introlab/securbot/firmware/README.md

# Firmware

This folder contains firmware for the battery board and the charging station.

Target platform is ESP32 Feather from Adafruit.  
Software is developped with PlatformIO on Visual Studio Code.

**Make sure to install appropriate USB FTDI drivers and UDEV rules!**  
Serial port is automatically detected for upload, if you have to specify it manually, something is wrong!
