introlab/securbot/scripts/VirtualCamSecurBot/ReadMe.md

## Installation

```./install.sh```

## Use Test image

```cd scripts```
```sudo ./startTest.sh```

#### Press q in the command window to stop virtual camera

## To use Test Map

```cd scripts```
```sudo ./startMap.sh```

#### Press q in the command window to stop virtual camera

### Use custom image
#### Replace the image file in the image folder. Keep the same name.

#### To do
   * Set a start file to use a gif instead of a static image.
