introlab/securbot/hardware/01 - PowerTree/03 - DESIGN NOTES/BuckBoost_19V_DesignFile.xlsx

Sheet: Design
TPS55340 DESIGN FILE
 | Considerations
 | Duty cycle must be between 10% and 90%
 | Duty cycle must be higher than 77ns. If the duty cycle is less than 77ns the chip enters in pulse skiping mode and it increases output ripple
 | Switching freq
 | A lower frequency provides a better efficiency, the frequency will be the lowest possible. It is also a main factor in component size, low frequency equals bigger components.
 | Freq = | 300000 | Hz
 | Rfreq = | 118161.3548 | Ω | i came with the adjustment in the Freq equation sheet. Equation was giving ratios and not a number
 | Min on time= | 7.7e-08 | sec
 | Absolute min duty cycle = | 0.0231
 | Vout
 | Vin max = | 16.5 | V
 | Vin min (battery voltage)= | 14.8 | V
 | Vout = | 19 | V
 | RSL = | 1500 | Ω
 | RSH = | 21689.58503 | Ω
 | SoftStart
 | A current of 6uA is biased on the SS pin
 | Once the capacitor reaches 1.8 V,the soft-start cycle is completed and the soft-start voltage no longer clamps the error amplifier output
 | When IC enters the shutdown mode, the SS capacitor is discharged througha 5-kΩ resistor
 | Charge current = | 6e-06 | A
 | (In function of rise time)
 | Charge time = | 0.03 | sec | Arbitrairy
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
