introlab/securbot/assets/docs_assets/electron_carousel.png

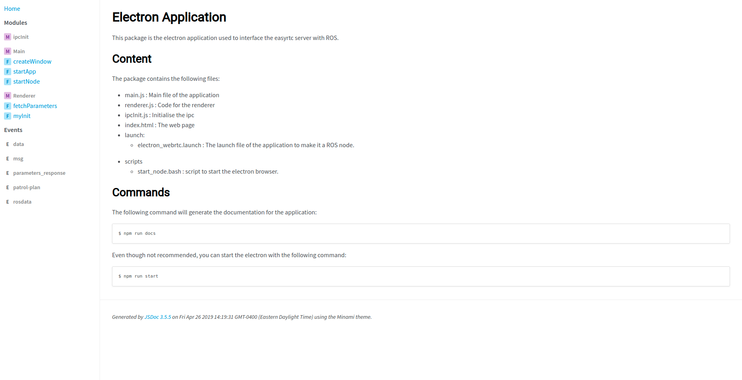
assets/docs_assets/electron_carousel.png
