introlab/securbot/assets/docs_assets/frontend_carousel.png

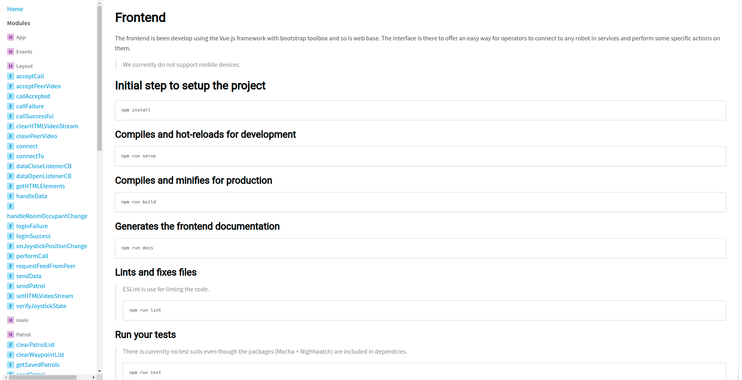
assets/docs_assets/frontend_carousel.png
