introlab/securbot/assets/docs_assets/secubot_pkg_carousel.png

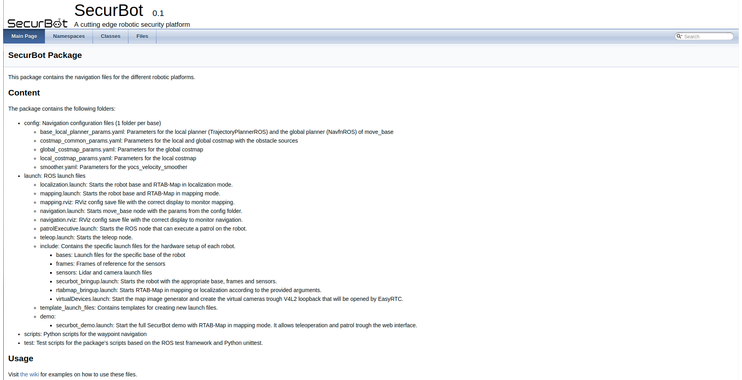
assets/docs_assets/secubot_pkg_carousel.png
