introlab/securbot/assets/wiki_assets/patrol_page_example.png

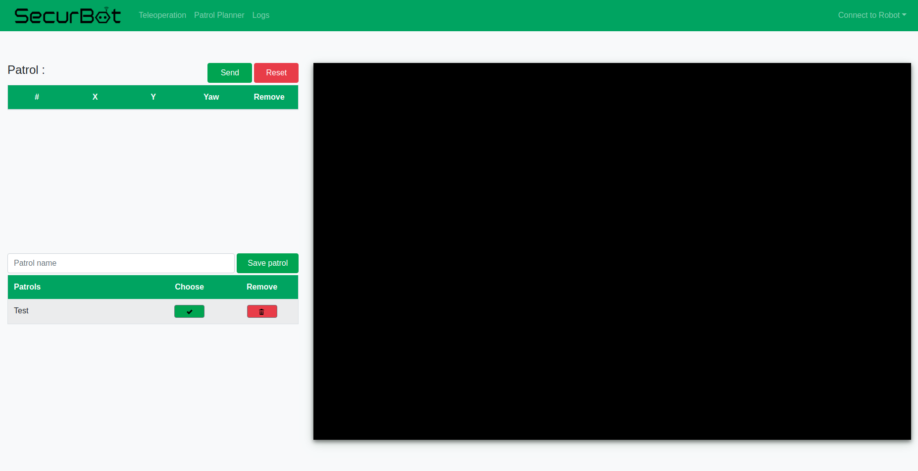
assets/wiki_assets/patrol_page_example.png
