introlab/securbot/assets/wiki_assets/teleop_page_example.png

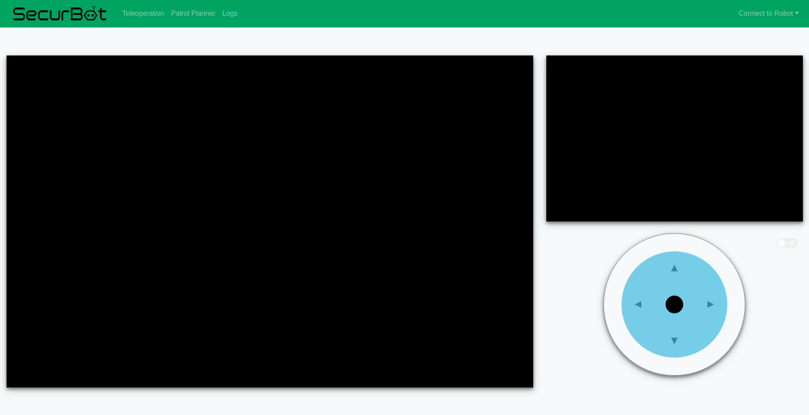
assets/wiki_assets/teleop_page_example.png
