introlab/securbot/scripts/VirtualCamSecurBot/images/Map.png

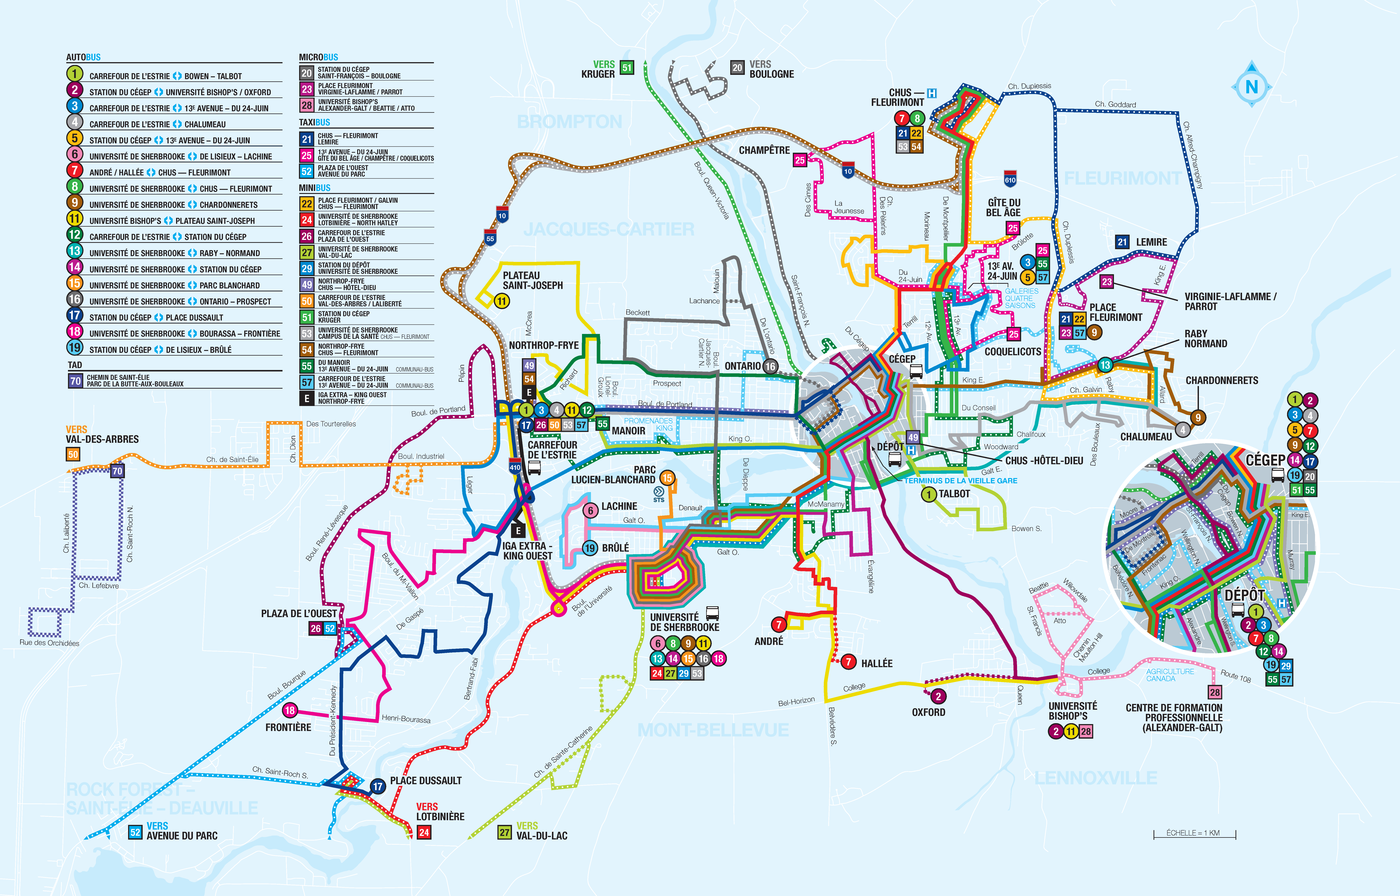
scripts/VirtualCamSecurBot/images/Map.png
