introlab/securbot/hardware/01 - PowerTree/04 - QUALIFICATIONS ET TESTS/SEC-349_RESULTS_2.xlsx

Output | Voltage | Expected voltage | Result with no load | Result with load | Power resistor value | Current read | Pass/Fail
J8 | 5 | 5.35 | 5.27 | 4.73 | 3.19 | 1.56 | Pass | These results are with modified resistor value for right output values
J7 | 5 | 5.35 | 5.27 | 4.72 | 3.19 | 1.56 | Pass
J6 | 5 | 5.35 | 5.27 | 4.68 | 3.19 | 1.56 | Pass
J5 | 5 | 5.35 | 5.27 | 4.71 | 3.19 | 1.56 | Pass
J3 | 12 | 12.35 | 12.58 | 12.01 | 7.84 | 1.605 | Pass
J2 | 12 | 12.35 | 12.64 | 12.06 | 7.84 | 1.597 | Pass
J10 | 2.5 | 2.5 | 2.52 | 2 | 1.59 | 1.4 | Pass
J10 | 13 | 13 | 12.45 | 11.88 | 7.76 | 1.57 | Pass
J4 | 15 | 15.35 | 16.1 | 15.57 | 10.02 | 1.79 | Pass
J11 | 19 | 18.5 | 18.85 | 18.45 | 11.75 | 1.74 | Pass
