introlab/securbot/hardware/01 - PowerTree/04 - QUALIFICATIONS ET TESTS/SEC-349_RESULTS_1.xlsx

Output | Voltage | Expected voltage | Result with no load | Result with load | Power resistor value | Current read | Pass/Fail
J8 | 5 | 5.35 | 6.25 | 5.65 | 3.5 | 1.65 | Fail
J7 | 5 | 5.35 | 6.23 | 5.66 | 3.5 | 1.66 | Fail
J6 | 5 | 5.35 | 6.23 | 5.61 | 3.5 | 1.66 | Fail
J5 | 5 | 5.35 | 6.24 | 5.63 | 3.5 | 1.65 | Fail
J3 | 12 | 12.35 | 13.2 | 12.54 | 7.93 | 1.656 | Fail
J2 | 12 | 12.35 | 13.18 | 12.51 | 7.93 | 1.64 | Fail
J10 | 2.5 | 2.5 | 2.52 | 2 | 1.53 | 1.441 | Pass
J10 | 13 | 13 | 12.46 | 11.85 | 7.48 | 1.63 | Pass
J4 | 15 | 15.35 | 16.15 | 15.52 | 9.75 | 1.81 | Pass
J11 | 19 | 19 | 19.72 | 19.3 | 11.8 | 1.2 | Pass
