introlab/securbot/hardware/03 - Charge Station/01 - SCHEMAS ET PCB/01 - REVISION 1_000/01 - OUTPUT/BOM_Charge_Station.xls

Designator | Part number | Quantity | Value
C1, C3 | GRT31CR61H106ME01L | 2 | 10 uF
C2, C4 | CC0805KRX7R9BB104 | 2 | 0.1uF
D1, D2 | PMEG6045ETPX | 2
FH1 | 01020071Z x2 | 1
J1 | PJ-082BH | 1
J2, J3, J4 | 0039281043 | 3
MH1, MH2, MH3, MH4 |  | 4
Q1, Q2 | DMN65D8L-7 | 2
R1, R4 | ERA-6AEB101V | 2 | 100R
R2 | ERA-6AEB4020V | 1 | 402R
R3, R5 | RMCF0805FT100K | 2 | 100K
RL1, RL2 | ORWH-SH-105D1F | 2
U1 | EL3H7(B)(TA)-VG | 1
U2 | UA78M05IKVURG3 | 1
