introlab/securbot/hardware/01 - PowerTree/01 - SCHEMAS ET PCB/01 - REVISION 1_000/01 - OUTPUT/BOM_PowerTree.xls

Designator | Part number | Quantity | Value
C1, C8, C15, C23, C31, C39, C47, C55, C63, C71 | EEE-FK1V330P | 10 | 33uF
C2, C3, C4, C5, C6, C7, C9, C13, C21, C29, C37, C45, C53, C61, C69 | GRT31CR61H106ME01L | 15 | 10 uF
C10, C12 | C0805C473K5RACTU | 2 | 0.047uF
C11 | C0805C430J5GAC7800 | 1 | 43pF
C14, C20, C22, C28, C30, C36, C38, C44, C46, C52, C54, C60, C62, C68, C70, C76 | CL21B103KBANNNC | 16 | 0.01uF
C16, C17, C24, C25, C32, C33, C40, C41, C48, C49, C56, C57, C64, C65, C72, C73 | CL31A226KAHNNNE | 16 | 22 uF
C18, C26, C34, C42, C50, C58, C66, C74 | CL21B332KBANNNC | 8 | 0.0033uF
C19, C27, C35, C43, C51, C59, C67, C75 | CC0805KRX7R9BB104 | 8 | 0.1uF
D1, D2, D5, D6, D7, D8, D9, D10, D11, D12, D13, D14 | PMEG6045ETPX | 12
D3, D4 | FSV15100V | 2
FID1, FID2, FID3 |  | 3
J1, J13, J14, J15, J16, J17, J18, J19, J20 | 61300211121 | 9
J2, J3, J4, J5, J6, J7, J8, J10, J11, J12 | 0039281043 | 10
J9 | PJ-082BH | 1
L1 | SRR1280-121K | 1 | 120 uH
L2, L3, L4, L5, L6, L7, L8, L9 | SRR1280-101M | 8 | 100uH
MH1, MH2, MH3, MH4 |  | 4
PTC1 | 0ZCG0110BF2B | 1
PTC2, PTC3, PTC4, PTC5, PTC6, PTC7, PTC8, PTC9 | 0ZCG0160BF2C | 8
R1, R9, R14, R19, R24, R29, R34, R39, R44 | KRL1220E-M-R010-F-T5 | 9 | 0R01
R2 | ERJ-6ENF2152V | 1 | 21,5K
R3 | CRCW0805200RFKEA | 1 | 200R
R4, R5, R45 | CRCW08051K50FKEA | 3 | 1.5k
R6 | CRCW0805118KFKEA | 1 | 118k
R7, R12, R17, R22, R27, R32, R37, R42 | RMCF0805FT10K0 | 8 | 10k
R8, R13, R18, R23, R28, R33, R38, R43 | RMCF0805FT100K | 8 | 100k
R10, R15, R20, R25 | RMCF0805FT47K5 | 4 | 47.5k
R11, R16, R21, R26, R31, R36, R41, R48 | RC0805FR-0713KL | 8 | 13k
R30, R35 | RMCF0805FT124K | 2 | 124k
R40 | RC0805FR-07154KL | 1 | 154k
R46 | 3361P-1-103GLF | 1 | 10K
R47 | RC0805FR-07866RL | 1 | 866
TP1, TP2, TP3, TP4, TP5, TP6, TP7, TP8, TP9, TP10, TP11, TP12, TP13, TP14, TP15, TP16, TP17, TP18, TP19, TP20, TP21, TP22 |  | 22
U1 | TPS55340 | 1
U2, U3, U4, U5, U6, U7, U8, U9 | RT8284N | 8
