introlab/securbot/hardware/96 - Mechanical/Base_pioneer/Panels/Assem4.SLDASM

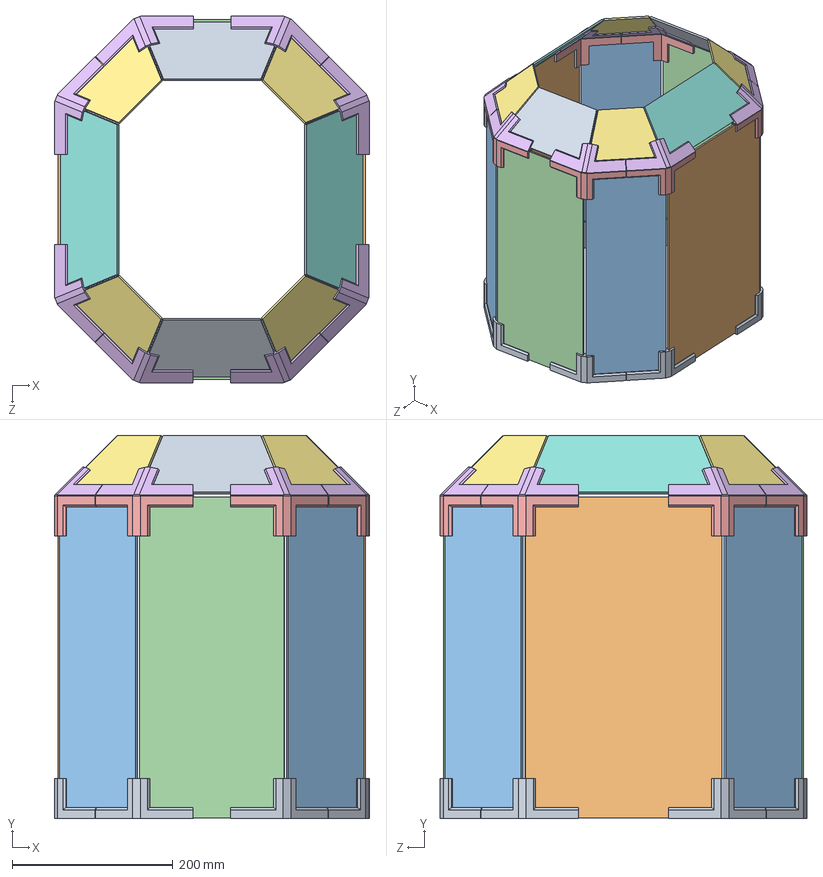
[picture p11: CAD file, 2019-09-19]
hardware/96 - Mechanical/Base_pioneer/Panels/Assem4.SLDASM
392.6 x 477.5 x 457.2 mm
CoinButtom_Bas x 8
Sides_long_h x 2
Side_angle x 4
Side_court_v x 2
CoinHaut_135deg x 8
angles_v2 x 8
Top_angle x 4
Top_long x 2
Top_court x 2
