introlab/securbot/hardware/96 - Mechanical/Base_turtlebot/Assemblage/Assem_Base_bodies.SLDASM

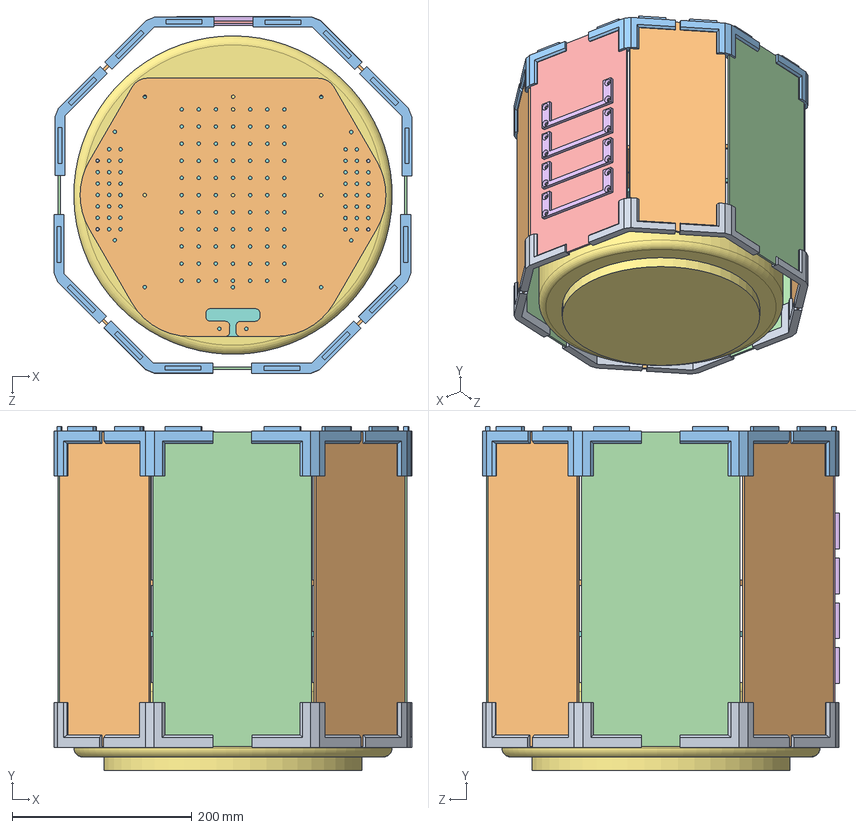
[picture p12: CAD file, 2019-10-12]
hardware/96 - Mechanical/Base_turtlebot/Assemblage/Assem_Base_bodies.SLDASM
398.0 x 382.5 x 397.1 mm
Links_ButtomOfBody x 8
Side_angle x 4
Links_TopOfBody x 8
Side_court_turtle x 3
Side_court_avant_turtle
Base_of_box_onpioneer x 4
kobuki
plate_bottom.stp
pole_middle.stp x 10
plate_top.stp
