introlab/securbot/hardware/96 - Mechanical/Contact bloc/Contact_box.SLDASM

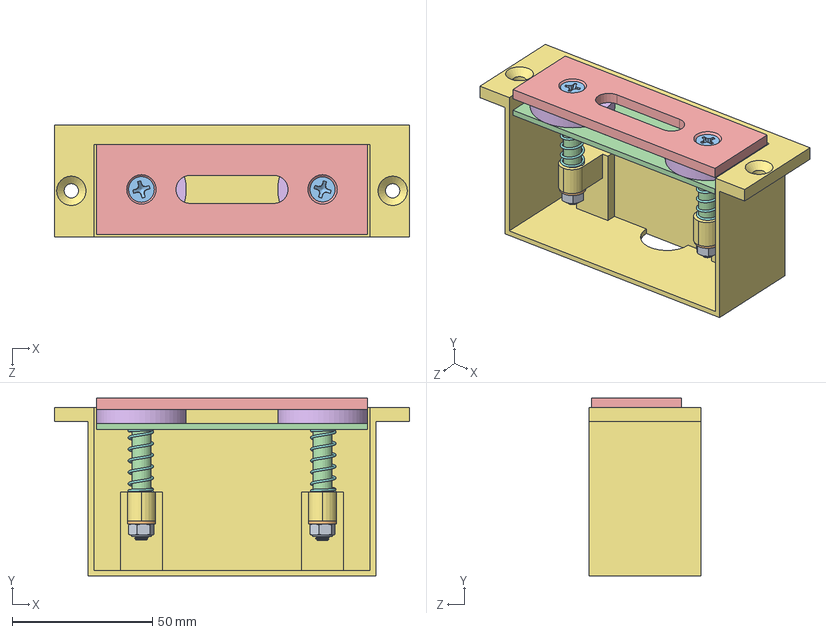
[picture p13: CAD file, 2019-10-16]
hardware/96 - Mechanical/Contact bloc/Contact_box.SLDASM
126.6 x 63.4 x 40.0 mm
90592A095_STEEL HEX NUT x 2
90965A160_TYPE 316 STAINLESS STEEL FLAT WASHER x 2
92010A346_METRIC 18-8 SS FLAT HEAD PHIL MACHINE SCREW x 2
Slider_double
Front_piece
Magnet x 2
Base_of_box
9434K730_MUSIC-WIRE STEEL COMPRESSION SPRINGS x 2
