introlab/securbot/hardware/96 - Mechanical/RobotBases/Base_pioneer/Assembly/Front_Panel_nickelContact_Pioneer.SLDASM

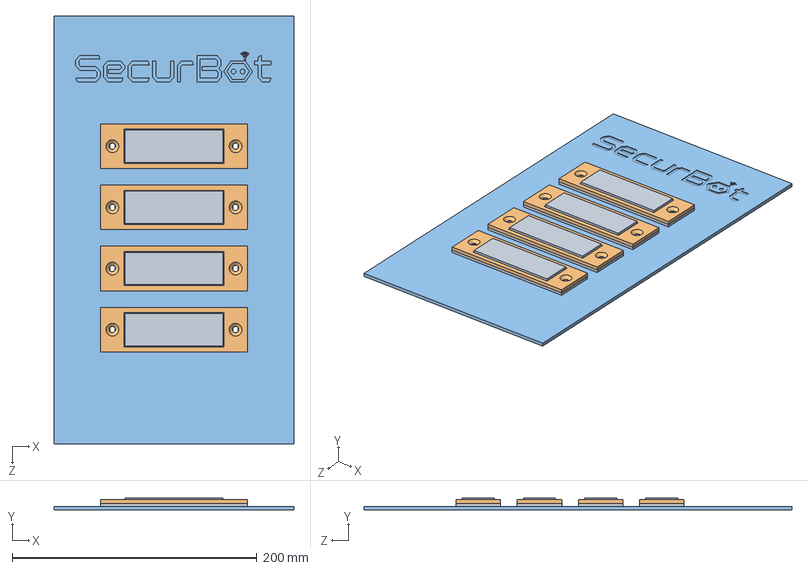
[picture p14: CAD file, 2019-10-27]
hardware/96 - Mechanical/RobotBases/Base_pioneer/Assembly/Front_Panel_nickelContact_Pioneer.SLDASM
196.0 x 10.0 x 350.0 mm
Part1_contact x 4
Part2_contact x 4
Body_Front_panel_nickelContact_Pioneer
