introlab/securbot/hardware/96 - Mechanical/RobotBases/Base_turtlebot/Assembly/Front_Panel_nickelContact_Turtle.SLDASM

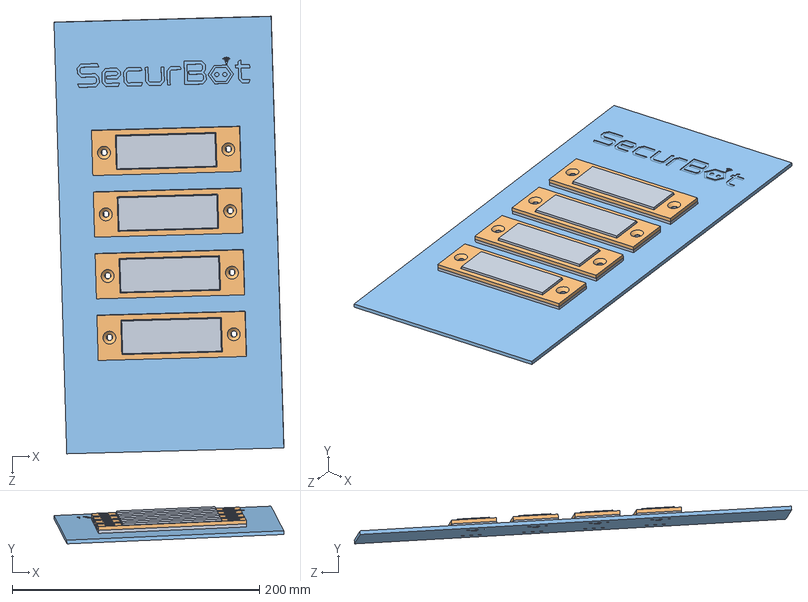
[picture p15: CAD file, 2019-10-27]
hardware/96 - Mechanical/RobotBases/Base_turtlebot/Assembly/Front_Panel_nickelContact_Turtle.SLDASM
186.2 x 30.5 x 354.2 mm
Part1_contact x 4
Part2_contact x 4
Body_Front_Panel_nickelContact_Turtle
