introlab/securbot/hardware/96 - Mechanical/RobotBases/Base_turtlebot/OriginalParts/Assem_turtleBase.SLDASM

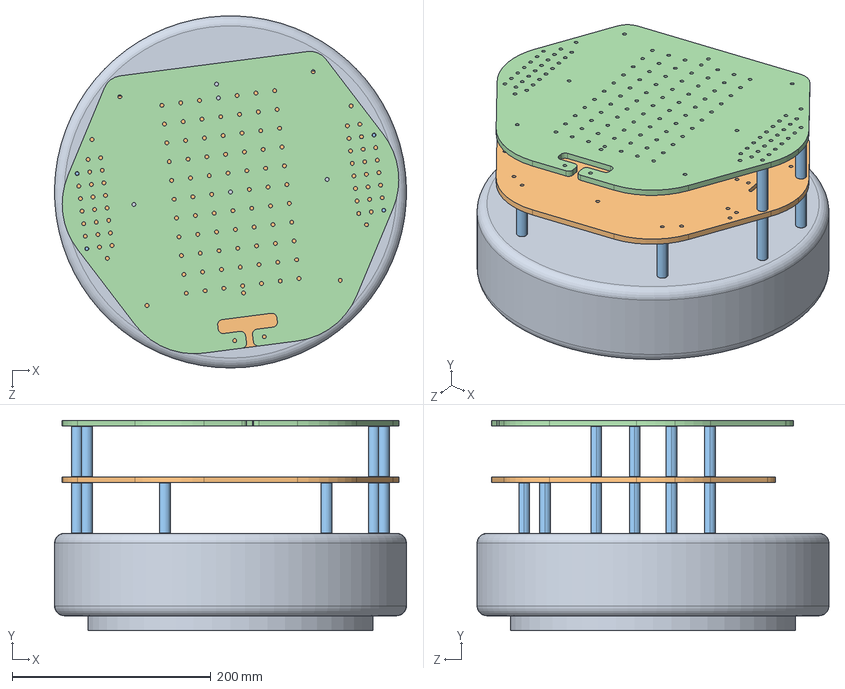
[picture p16: CAD file, 2019-10-27]
hardware/96 - Mechanical/RobotBases/Base_turtlebot/OriginalParts/Assem_turtleBase.SLDASM
353.9 x 211.6 x 353.8 mm
kobuki
plate_bottom.stp
pole_middle.stp x 10
plate_top.stp
