introlab/securbot/hardware/96 - Mechanical/RobotBases/Contact_robotBase/Contact_robotBase_aluminium/ContactAluFer.SLDASM

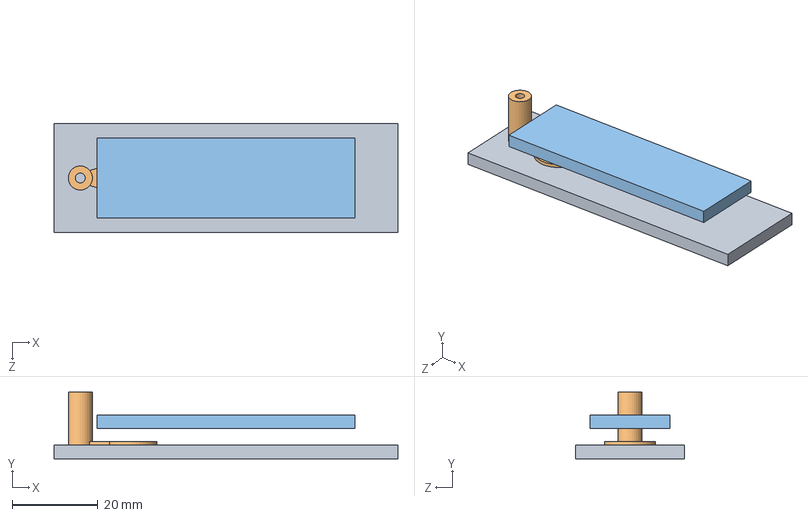
[picture p17: CAD file, 2019-10-27]
hardware/96 - Mechanical/RobotBases/Contact_robotBase/Contact_robotBase_aluminium/ContactAluFer.SLDASM
80.0 x 15.6 x 25.3 mm
Contact_barreAlu
ConnecteurAAnneau
Contact_barreFer
