introlab/securbot/hardware/96 - Mechanical/RobotBases/Contact_robotBase/Contact_robotBase_nickel/Contact.SLDASM

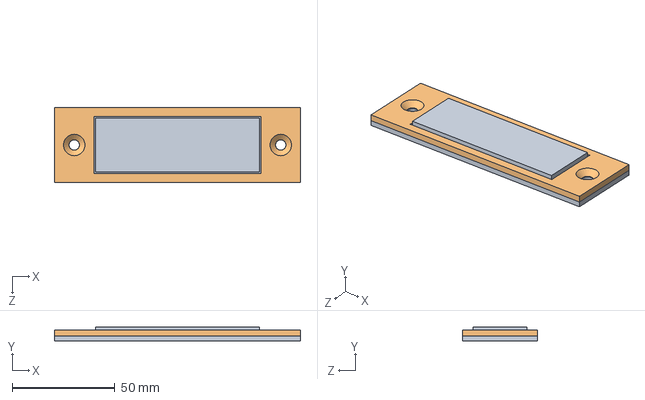
[picture p18: CAD file, 2019-10-27]
hardware/96 - Mechanical/RobotBases/Contact_robotBase/Contact_robotBase_nickel/Contact.SLDASM
120.0 x 7.00 x 36.5 mm
Part1_contact
Part2_contact
