introlab/securbot/hardware/96 - Mechanical/RobotBases/Lidar/rplidar-a2m4-r1.SLDASM

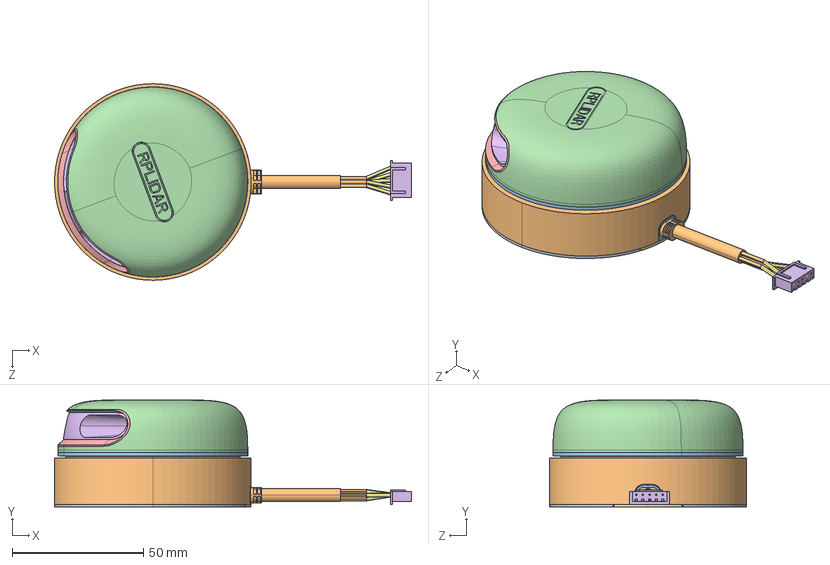
[picture p19: CAD file, 2019-10-12]
hardware/96 - Mechanical/RobotBases/Lidar/rplidar-a2m4-r1.SLDASM
136.2 x 40.8 x 75.0 mm
底盖.igs
编码齿外壳.igs
旋转平台.igs
LENS_1.6.igs
KEY_1.6.igs
BAT_COVER_19.igs
封盖.igs
激光发射头.igs
镜头.igs
接线端盖.igs
6p 插头.igs
零件4^外接线整体.igs
