introlab/securbot/hardware/96 - Mechanical/Charge Station/ChargeStation.SLDASM

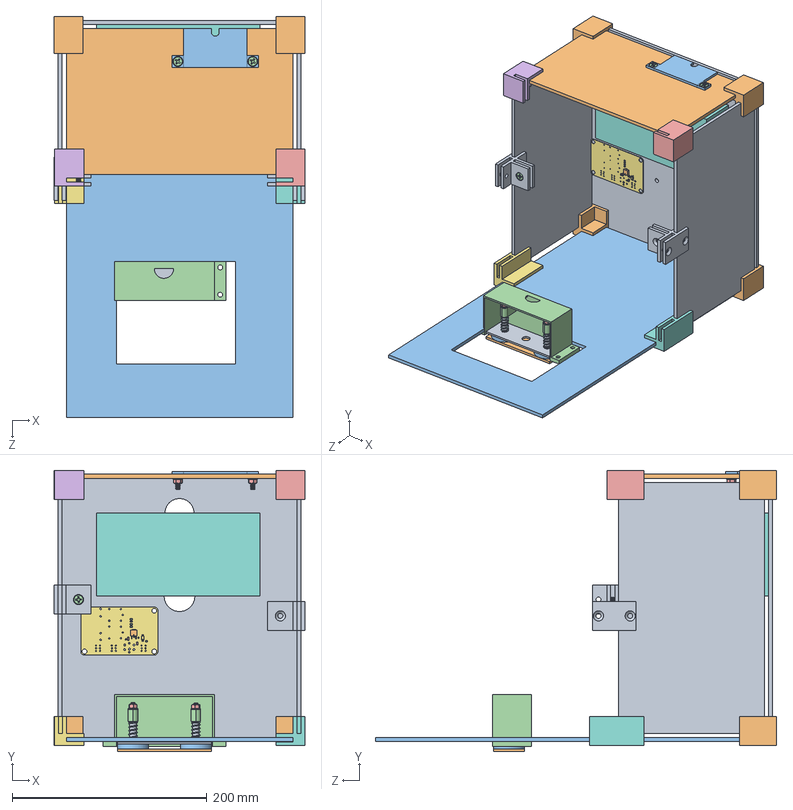
[picture p20: CAD file, 2019-10-10]
hardware/96 - Mechanical/Charge Station/ChargeStation.SLDASM
258.0 x 289.3 x 412.2 mm
Bottom
Link_corner x 4
Front
res0805.step x 5
Cap1206.step x 2
Cap0805.step x 2
Open_CASCADE_STEP_translator_6.8_7.2.1.step
Open_CASCADE_STEP_translator_6.8_7.1.step
Leader.step x 4
Open_CASCADE_STEP_translator_6.8_25.2.1.step
Open_CASCADE_STEP_translator_6.8_25.6.1.step
Open_CASCADE_STEP_translator_6.8_25.1.step
Lead.step x 2
Trimmed_Lead.step
Board.step
Power_supply
Side_Panel_Bottom x 2
Bottom_Back_Panel
Back_Pannel_Restrictor_for_supply_cable
92010A793_PASSIVATED 18-8 SS PHILLIPS FLAT HEAD SCREW x 3
90592A095_STEEL HEX NUT x 4
90965A160_TYPE 316 STAINLESS STEEL FLAT WASHER x 4
92010A346_METRIC 18-8 SS FLAT HEAD PHIL MACHINE SCREW x 2
9434K790_MUSIC-WIRE STEEL COMPRESSION SPRINGS x 2
Slider_double_V2
Double_mid_piece
Magnet x 2
Base_of_box_V2
Link_upper_corner_L
Link_upper_corner_R
Link_upper_corner_front_R
Link_upper_corner_front_L
Link_upper_side x 2
