introlab/securbot/hardware/96 - Mechanical/RobotBases/Base_pioneer/Assembly/Front_Panel_aluminiumContact.SLDASM

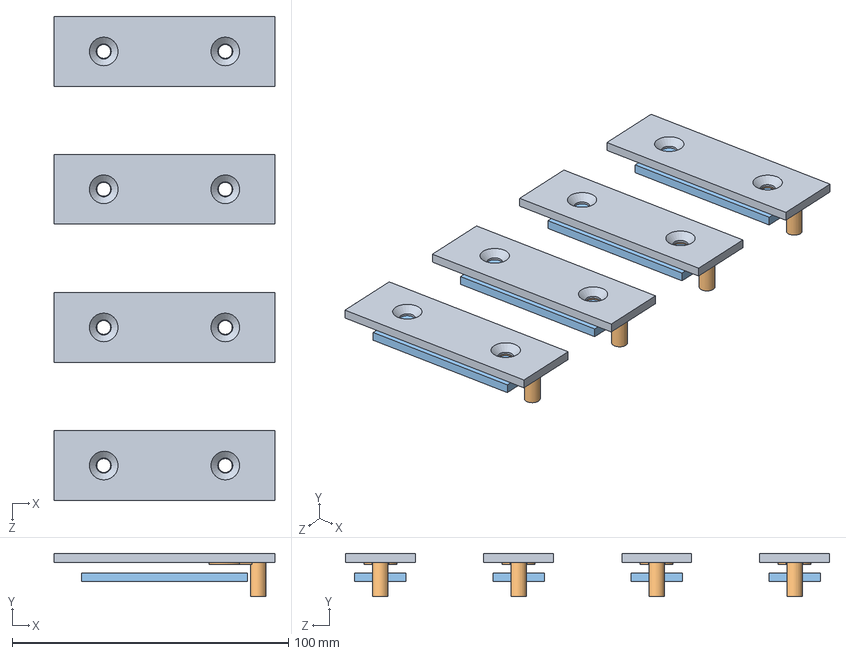
[picture p21: CAD file, 2019-10-27]
hardware/96 - Mechanical/RobotBases/Base_pioneer/Assembly/Front_Panel_aluminiumContact.SLDASM
80.0 x 15.6 x 175.2 mm
Contact_barreAlu x 4
ConnecteurAAnneau x 4
Contact_barreFer x 4
