introlab/securbot/hardware/96 - Mechanical/RobotBases/Base_turtlebot/Assembly/Front_Panel_aluminiumContact_Turtle.SLDASM

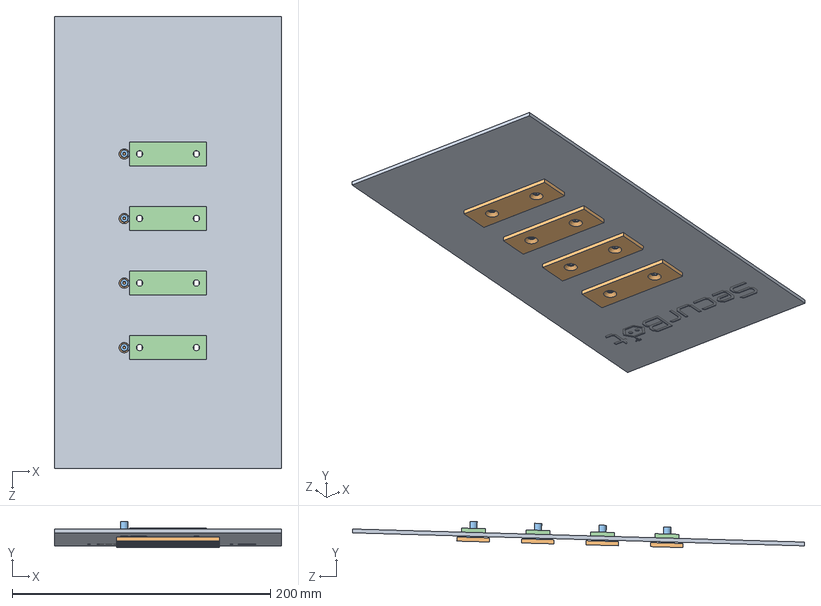
[picture p22: CAD file, 2019-10-27]
hardware/96 - Mechanical/RobotBases/Base_turtlebot/Assembly/Front_Panel_aluminiumContact_Turtle.SLDASM
176.0 x 20.3 x 349.9 mm
Body_Front_Panel_aluContact_Turtle
Contact_barreAlu x 4
ConnecteurAAnneau x 4
Contact_barreFer x 4
