introlab/securbot/hardware/96 - Mechanical/RobotBases/Base_pioneer/Assembly/Assem_Body_Pioneer.SLDASM

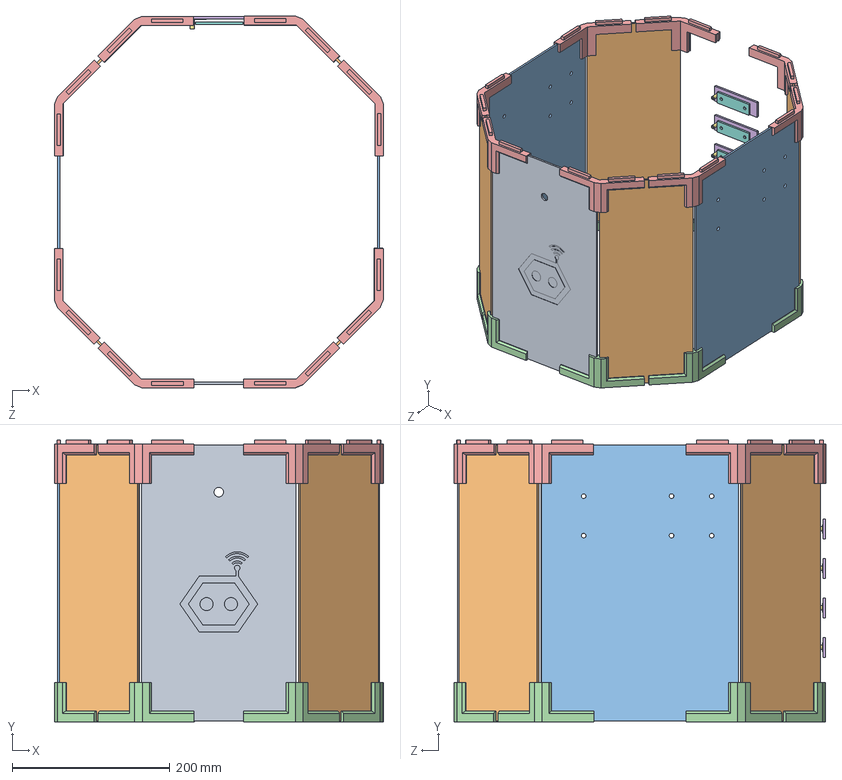
[picture p23: CAD file, 2019-10-27]
hardware/96 - Mechanical/RobotBases/Base_pioneer/Assembly/Assem_Body_Pioneer.SLDASM
417.1 x 357.0 x 471.1 mm
Links_ButtomOfBody x 8
Body_Side_Panel_Pioneer x 2
Body_Angled_Panel_Pioneer x 4
Body_Back_Panel_Pioneer
Links_TopOfBody x 8
Contact_barreAlu x 4
ConnecteurAAnneau x 4
Contact_barreFer x 4
