introlab/securbot/hardware/96 - Mechanical/RobotBases/Base_pioneer/Pioneer_originalRobotBase/WheelMain.SLDPRT

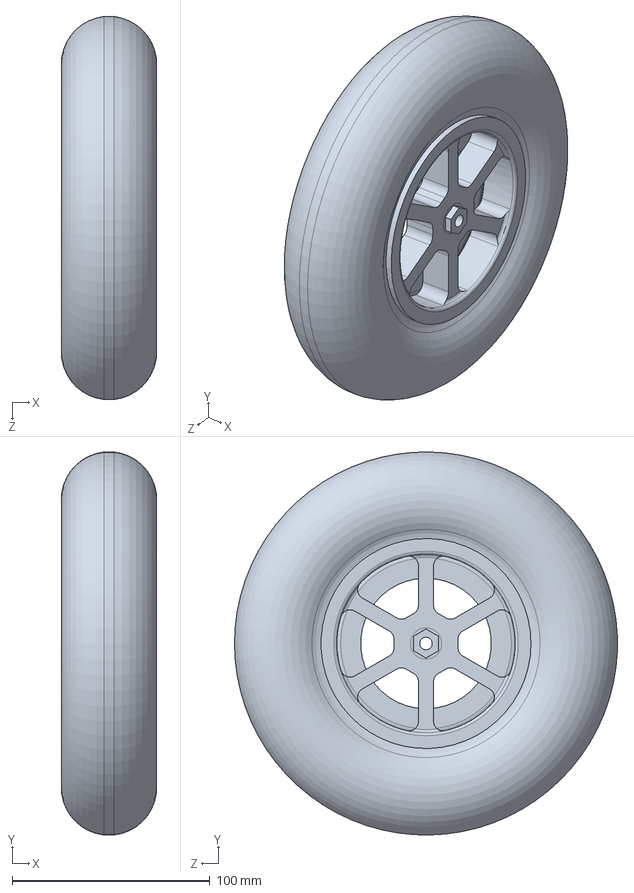
[picture p24: CAD file, 2019-10-16]
hardware/96 - Mechanical/RobotBases/Base_pioneer/Pioneer_originalRobotBase/WheelMain.SLDPRT
48.3 x 193.6 x 193.7 mm
