introlab/securbot/hardware/96 - Mechanical/RobotBases/Base_turtlebot/Assembly/SubAssem_cornerOfCap.SLDASM

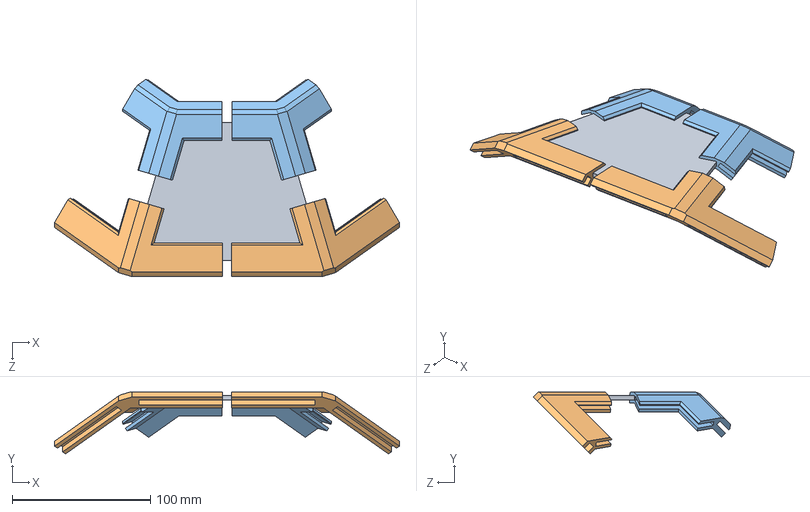
[picture p25: CAD file, 2019-10-27]
hardware/96 - Mechanical/RobotBases/Base_turtlebot/Assembly/SubAssem_cornerOfCap.SLDASM
249.6 x 44.8 x 142.8 mm
Top_angle_turtle
Links_ButtomOfCap x 2
Links_TopOfCap x 2
