introlab/securbot/hardware/96 - Mechanical/RobotBases/Base_pioneer/TopPlateScanAndDrawings/Pioneer_Compare_Plates.SLDASM

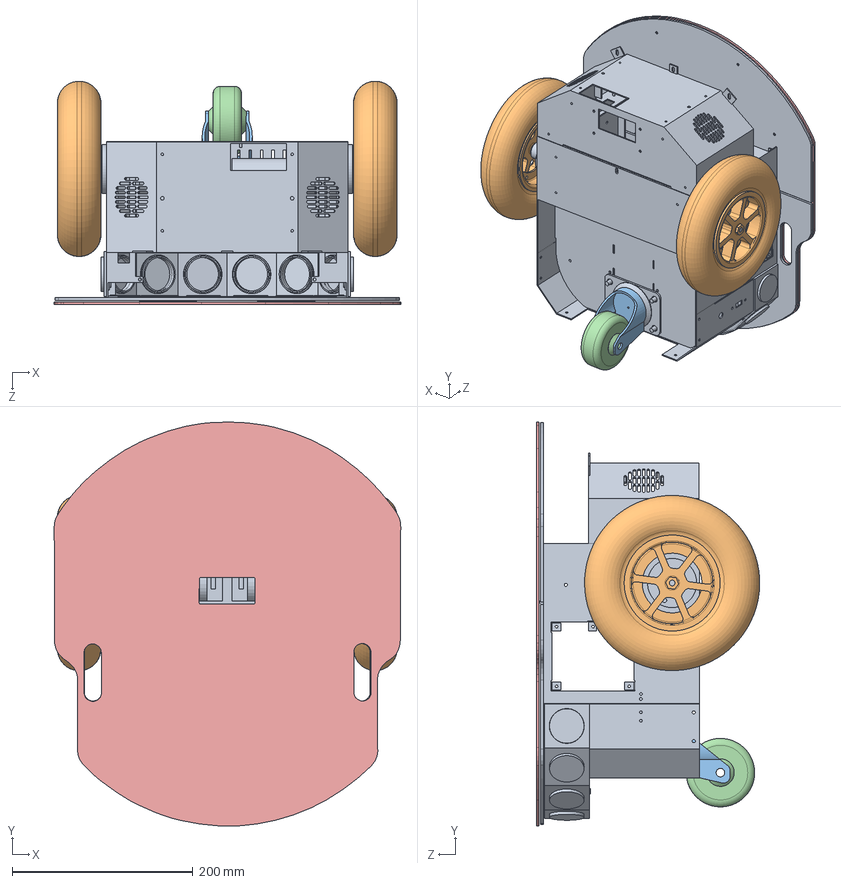
[picture p26: CAD file, 2019-09-10]
hardware/96 - Mechanical/RobotBases/Base_pioneer/TopPlateScanAndDrawings/Pioneer_Compare_Plates.SLDASM
383.2 x 446.7 x 247.0 mm
PioneerBody
WheelMain x 2
CasterWheelClamp
CasterWheelBody
TopPlate_Pioneer_final
