introlab/securbot/hardware/96 - Mechanical/RobotBases/Base_turtlebot/Assembly/Assem_Body_turtle.SLDASM

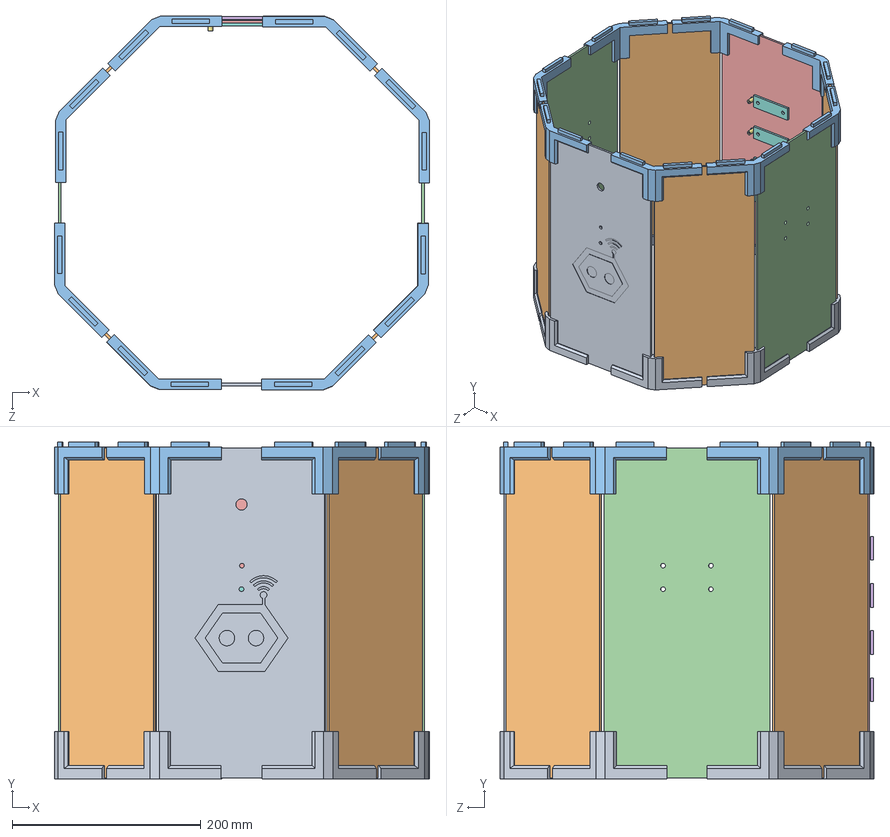
[picture p27: CAD file, 2019-10-27]
hardware/96 - Mechanical/RobotBases/Base_turtlebot/Assembly/Assem_Body_turtle.SLDASM
398.0 x 357.0 x 396.7 mm
Links_ButtomOfBody x 8
Body_Angled_Panel_Turtle x 4
Links_TopOfBody x 8
Body_Side_Panel_Turtle x 2
Body_Front_Panel_aluContact_Turtle
Contact_barreAlu x 4
ConnecteurAAnneau x 4
Contact_barreFer x 4
Body_Back_Panel_Turtle
