introlab/securbot/hardware/96 - Mechanical/RobotBases/OdasMaterials/Board_withSpacers.SLDASM

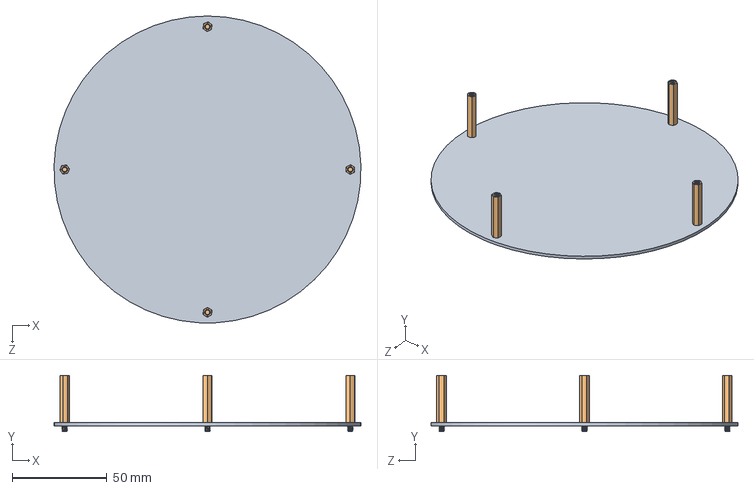
[picture p28: CAD file, 2019-10-18]
hardware/96 - Mechanical/RobotBases/OdasMaterials/Board_withSpacers.SLDASM
161.9 x 29.7 x 162.0 mm
Board
98952A120_ALUM MALE-FEM THRDED HEX STANDOFF x 4
