introlab/securbot/hardware/96 - Mechanical/Charge Station/AprilTagHolder.SLDPRT

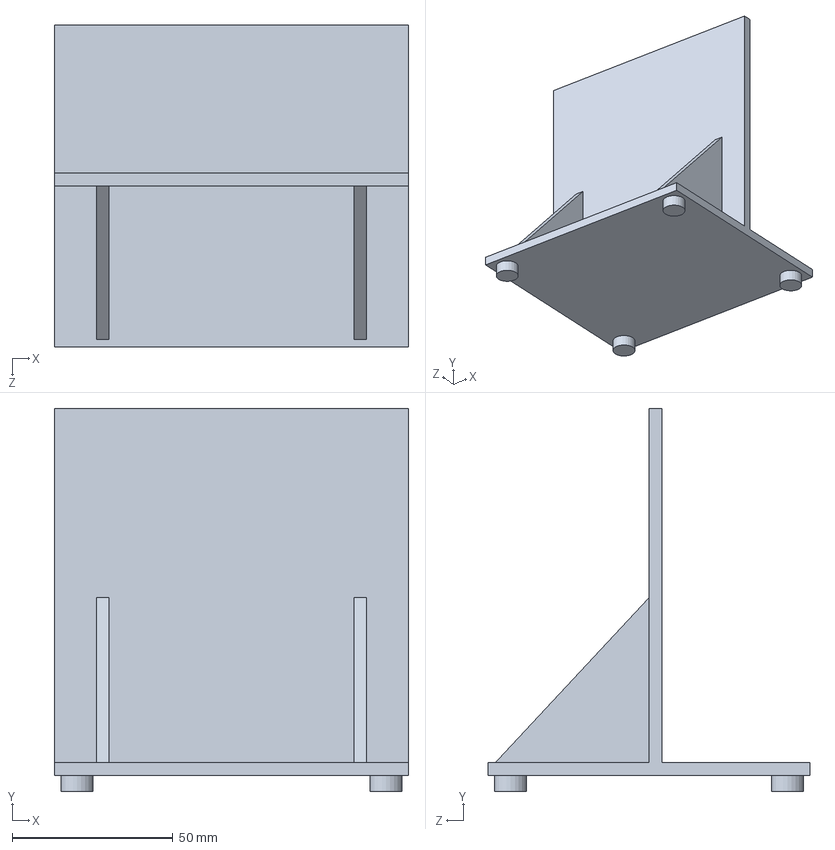
[picture p29: CAD file, 2019-12-14]
hardware/96 - Mechanical/Charge Station/AprilTagHolder.SLDPRT
110.0 x 119.0 x 100.0 mm
