introlab/securbot/hardware/96 - Mechanical/Charge Station/Links/Link_upper_corner_R.SLDPRT

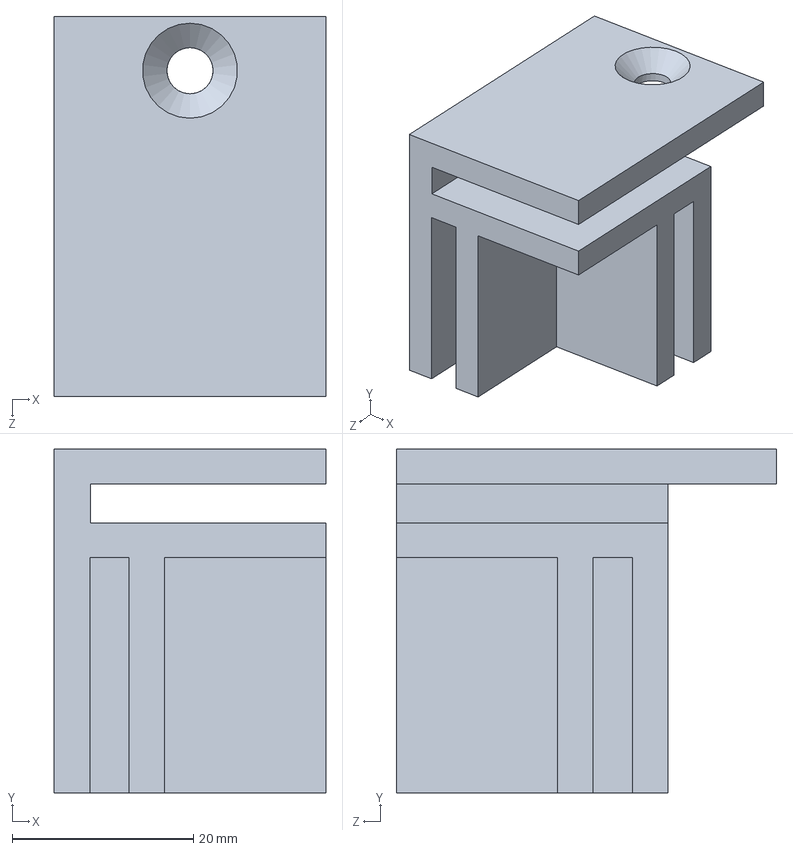
[picture p30: CAD file, 2019-10-27]
hardware/96 - Mechanical/Charge Station/Links/Link_upper_corner_R.SLDPRT
30.0 x 38.0 x 42.0 mm
