introlab/securbot/hardware/96 - Mechanical/Charge Station/Pannels/Upper_Pannel.SLDPRT

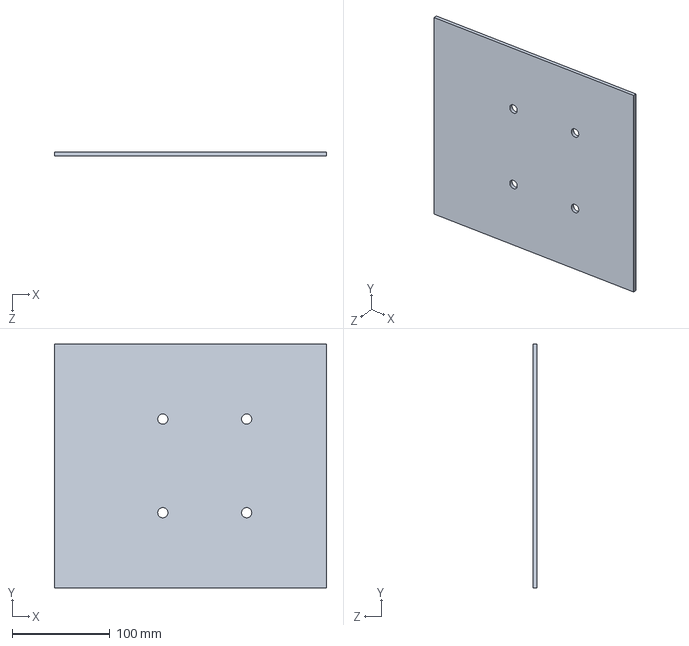
[picture p31: CAD file, 2019-12-14]
hardware/96 - Mechanical/Charge Station/Pannels/Upper_Pannel.SLDPRT
278.9 x 249.9 x 4.20 mm
