introlab/securbot/hardware/96 - Mechanical/Contact bloc/Plastic pieces/Base_of_box.SLDPRT

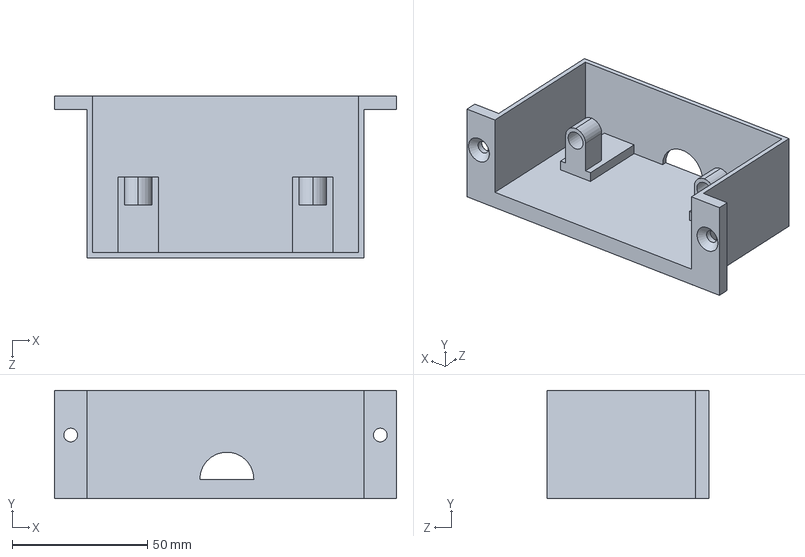
[picture p32: CAD file, 2019-10-16]
hardware/96 - Mechanical/Contact bloc/Plastic pieces/Base_of_box.SLDPRT
126.6 x 40.0 x 60.0 mm
