introlab/securbot/hardware/96 - Mechanical/RobotBases/Base_pioneer/BodyAttach/BodyAttach.SLDPRT

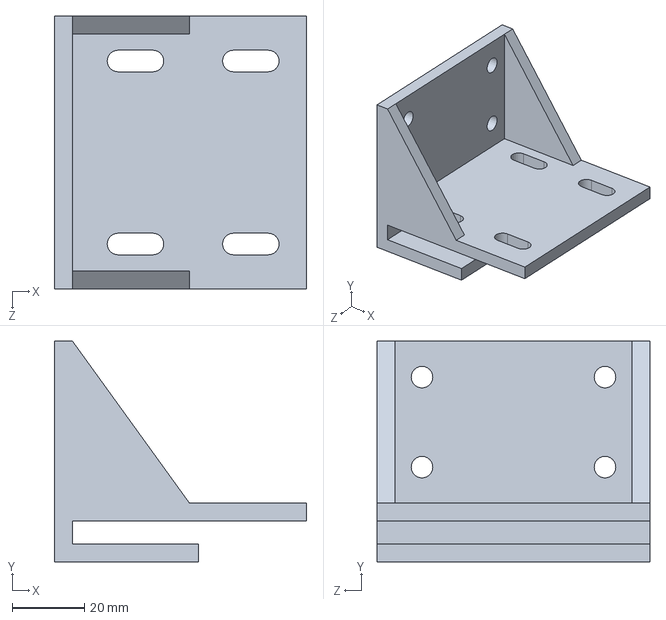
[picture p33: CAD file, 2019-12-14]
hardware/96 - Mechanical/RobotBases/Base_pioneer/BodyAttach/BodyAttach.SLDPRT
70.0 x 61.3 x 75.8 mm
