introlab/securbot/hardware/96 - Mechanical/RobotBases/Base_pioneer/Panels/Body_Side_Panel_Pioneer.SLDPRT

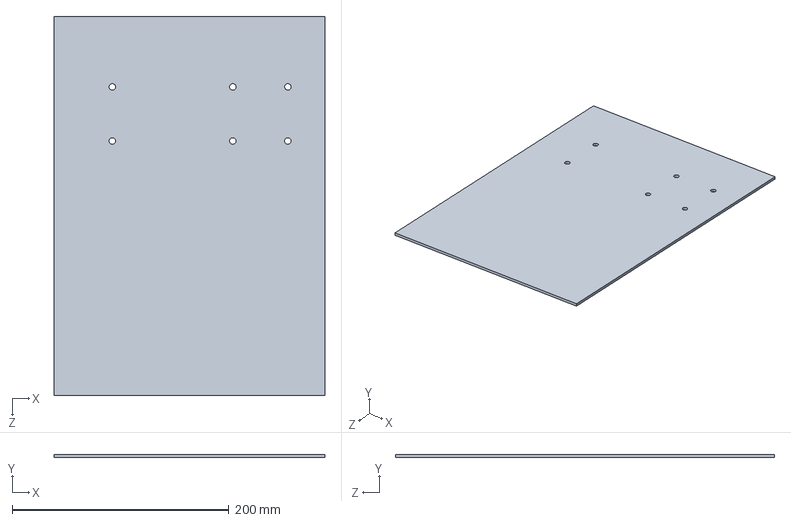
[picture p34: CAD file, 2019-10-27]
hardware/96 - Mechanical/RobotBases/Base_pioneer/Panels/Body_Side_Panel_Pioneer.SLDPRT
250.0 x 3.00 x 350.0 mm
