introlab/securbot/hardware/96 - Mechanical/RobotBases/Base_pioneer/STL/BodyAttachSecond.STL

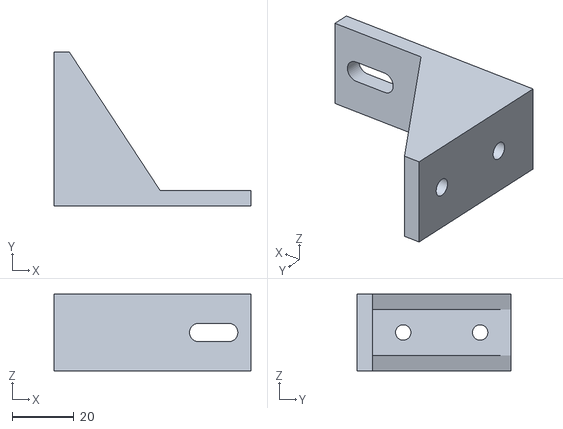
[picture p35: CAD file, 2019-10-27]
hardware/96 - Mechanical/RobotBases/Base_pioneer/STL/BodyAttachSecond.STL
64.0 x 50.0 x 25.0
