introlab/securbot/hardware/96 - Mechanical/RobotBases/Base_pioneer/TopPlateScanAndDrawings/Pioneer_V2.dxf

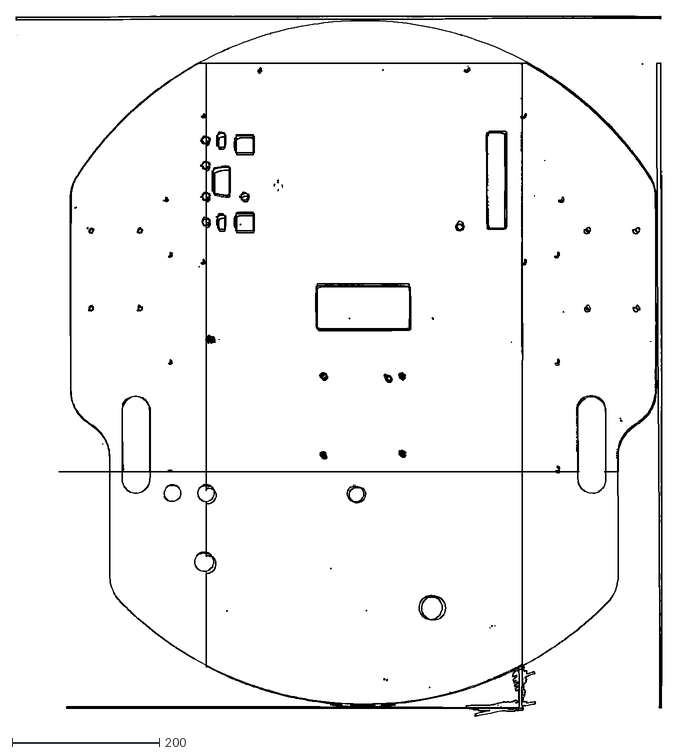
[picture p36: CAD file, 2019-10-12]
hardware/96 - Mechanical/RobotBases/Base_pioneer/TopPlateScanAndDrawings/Pioneer_V2.dxf
877.3 x 950.8
