introlab/securbot/hardware/96 - Mechanical/RobotBases/Base_turtlebot/BodyAttach_turtle/BodyAttach_side_turtle.SLDPRT

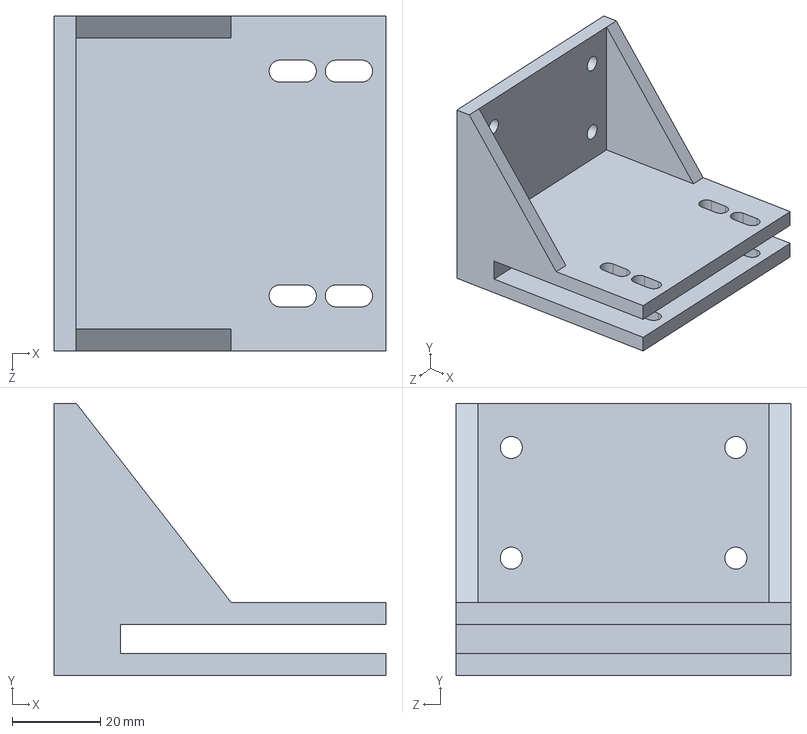
[picture p37: CAD file, 2019-10-27]
hardware/96 - Mechanical/RobotBases/Base_turtlebot/BodyAttach_turtle/BodyAttach_side_turtle.SLDPRT
75.0 x 61.6 x 75.7 mm
