introlab/securbot/hardware/96 - Mechanical/RobotBases/Base_turtlebot/Panels/Logo_SecurBot.dxf

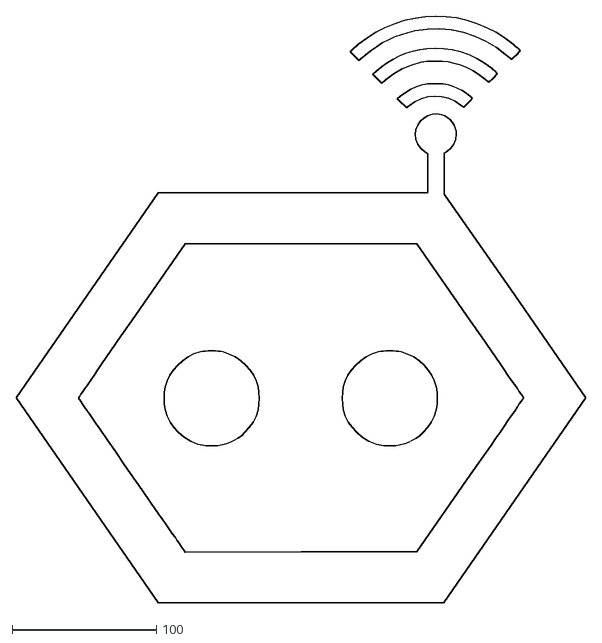
[picture p38: CAD file, 2019-10-27]
hardware/96 - Mechanical/RobotBases/Base_turtlebot/Panels/Logo_SecurBot.dxf
394.7 x 406.7
