introlab/securbot/hardware/96 - Mechanical/RobotBases/Cutouts_robotBase/TestPartForCut.DXF

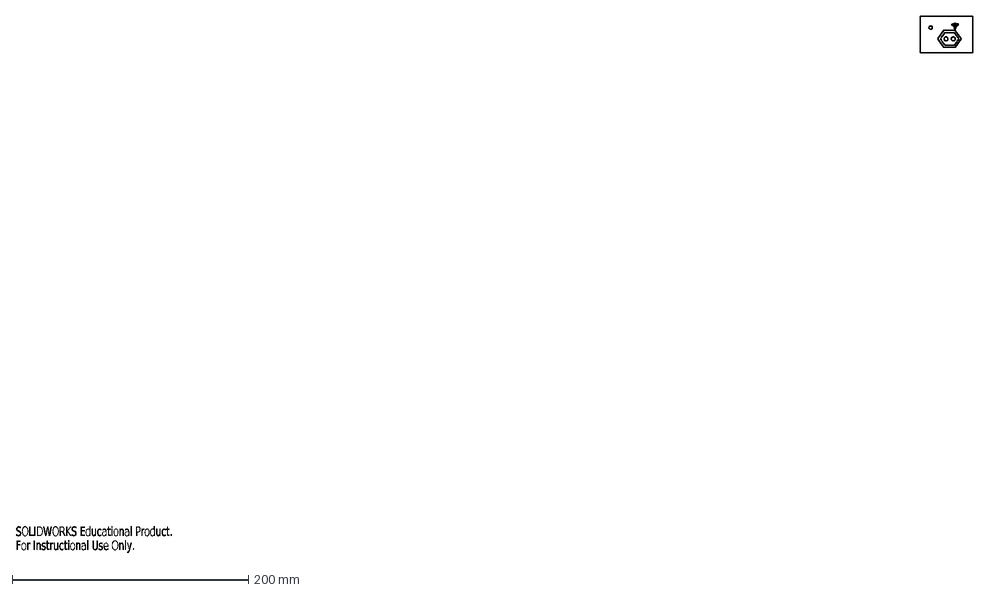
[picture p40: CAD file, 2019-10-27]
hardware/96 - Mechanical/RobotBases/Cutouts_robotBase/TestPartForCut.DXF
SOLIDWORKS Educational Product.
For Instructional Use Only.
