introlab/securbot/hardware/96 - Mechanical/RobotBases/Cutouts_robotBase/TurtleBot/Cutout_Turtle_2.DXF

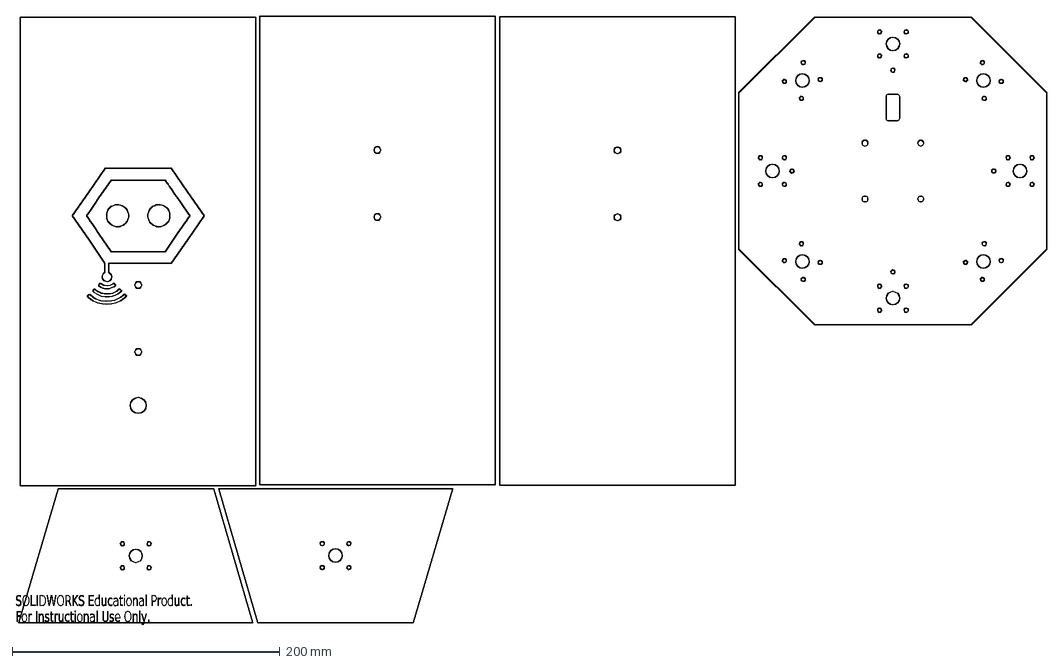
[picture p41: CAD file, 2019-10-27]
hardware/96 - Mechanical/RobotBases/Cutouts_robotBase/TurtleBot/Cutout_Turtle_2.DXF
SOLIDWORKS Educational Product.
For Instructional Use Only.
