introlab/securbot/hardware/96 - Mechanical/RobotBases/Prints3D_Links_Holder/RealSense_holder.SLDPRT

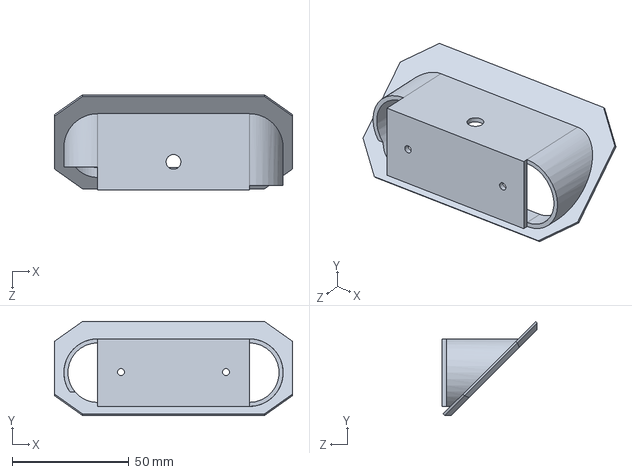
[picture p42: CAD file, 2019-10-27]
hardware/96 - Mechanical/RobotBases/Prints3D_Links_Holder/RealSense_holder.SLDPRT
102.0 x 40.3 x 40.9 mm
