introlab/securbot/hardware/96 - Mechanical/Charge Station/Links/Link_upper_corner_L.SLDPRT

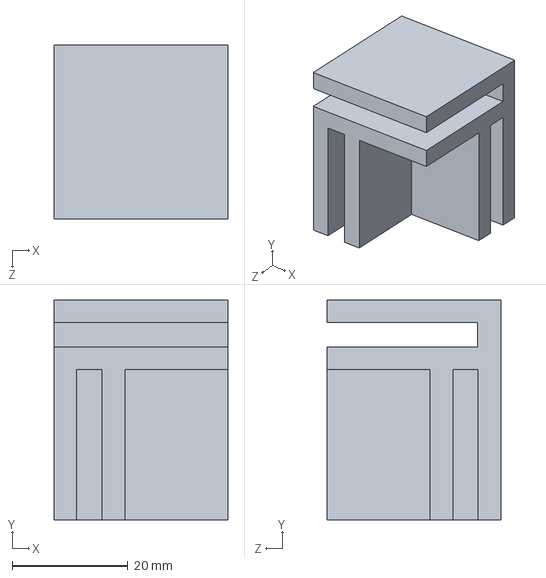
[picture p43: CAD file, 2019-10-27]
hardware/96 - Mechanical/Charge Station/Links/Link_upper_corner_L.SLDPRT
30.0 x 38.0 x 30.0 mm
