introlab/securbot/hardware/96 - Mechanical/Charge Station/Pannels/Front_Pannel.SLDPRT

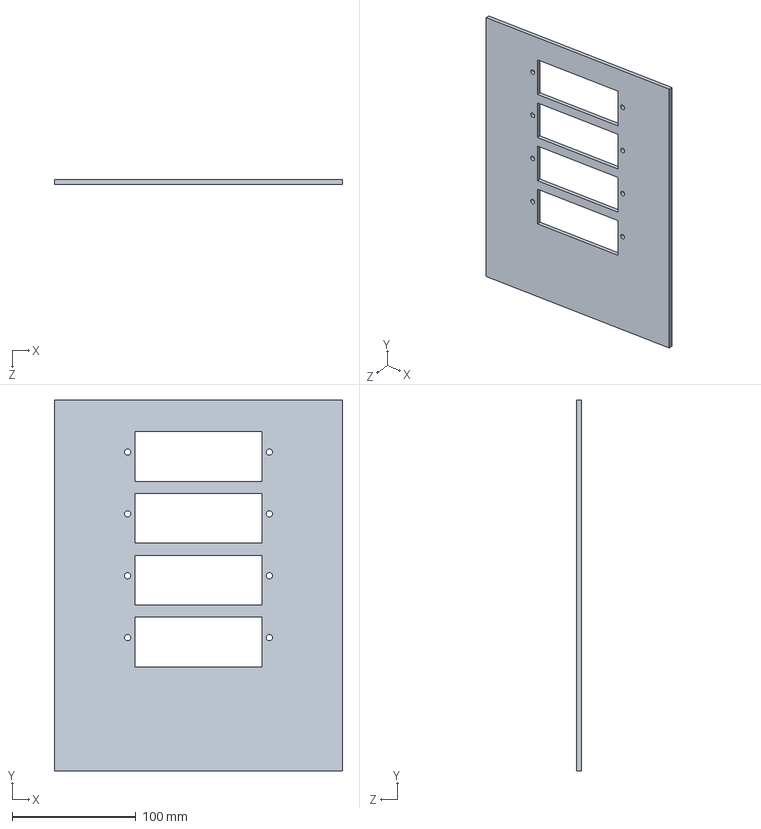
[picture p44: CAD file, 2019-10-15]
hardware/96 - Mechanical/Charge Station/Pannels/Front_Pannel.SLDPRT
233.0 x 300.0 x 4.20 mm
