introlab/securbot/hardware/96 - Mechanical/Contact bloc/Plastic pieces/Slider_double.SLDPRT

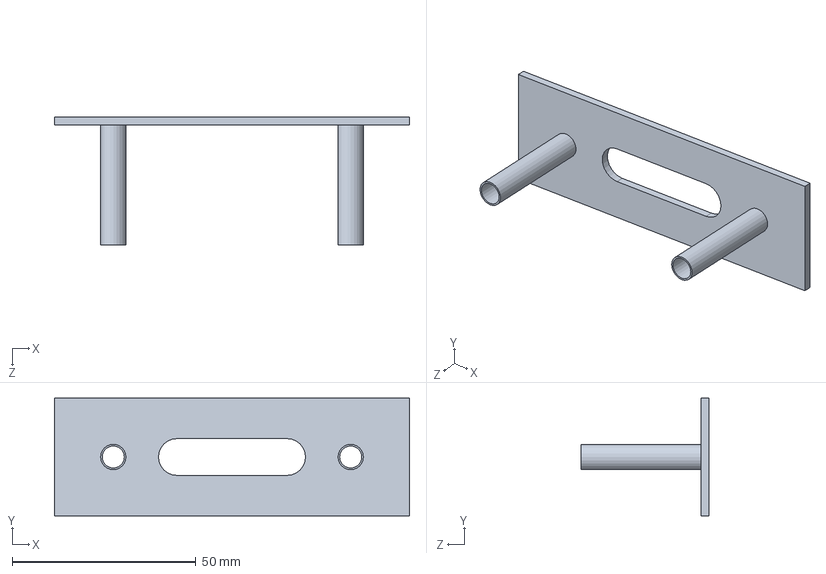
[picture p45: CAD file, 2019-10-15]
hardware/96 - Mechanical/Contact bloc/Plastic pieces/Slider_double.SLDPRT
96.6 x 32.0 x 34.8 mm
