introlab/securbot/hardware/96 - Mechanical/RobotBases/Base_pioneer/Pioneer_originalRobotBase/PioneerBody.SLDPRT

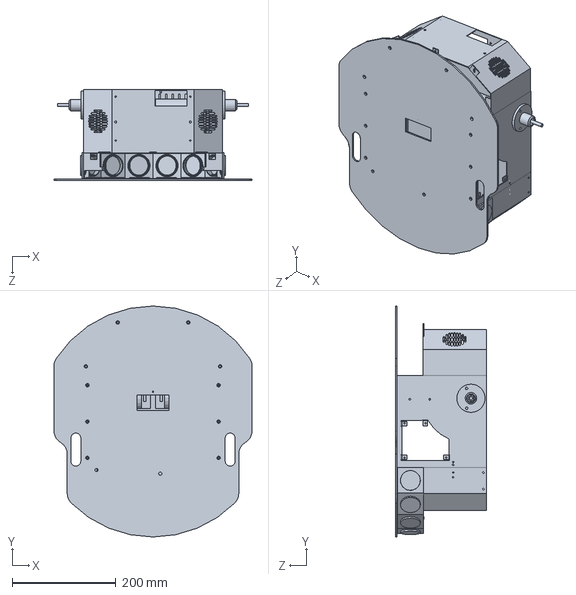
[picture p47: CAD file, 2019-10-16]
hardware/96 - Mechanical/RobotBases/Base_pioneer/Pioneer_originalRobotBase/PioneerBody.SLDPRT
381.0 x 444.5 x 175.9 mm
