introlab/securbot/hardware/96 - Mechanical/RobotBases/Base_turtlebot/BodyAttach_turtle/BodyAttach_back_turtle.SLDPRT

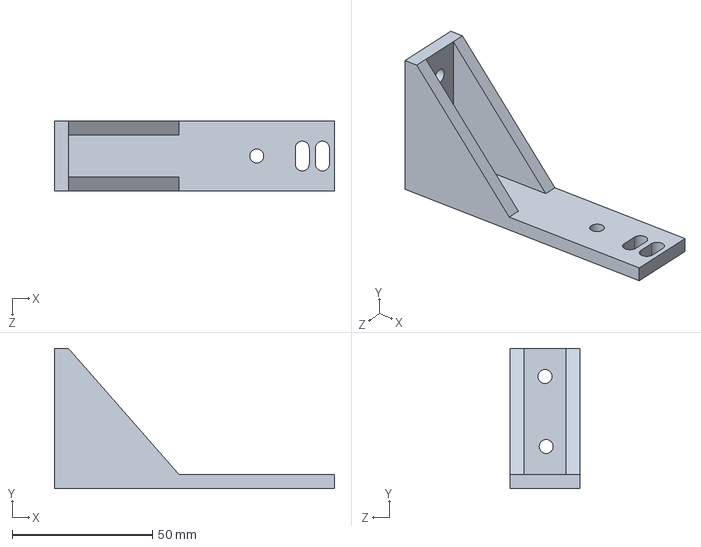
[picture p48: CAD file, 2019-10-27]
hardware/96 - Mechanical/RobotBases/Base_turtlebot/BodyAttach_turtle/BodyAttach_back_turtle.SLDPRT
100.0 x 50.0 x 25.0 mm
