introlab/securbot/hardware/96 - Mechanical/RobotBases/Base_turtlebot/OriginalParts/plate_top.stp

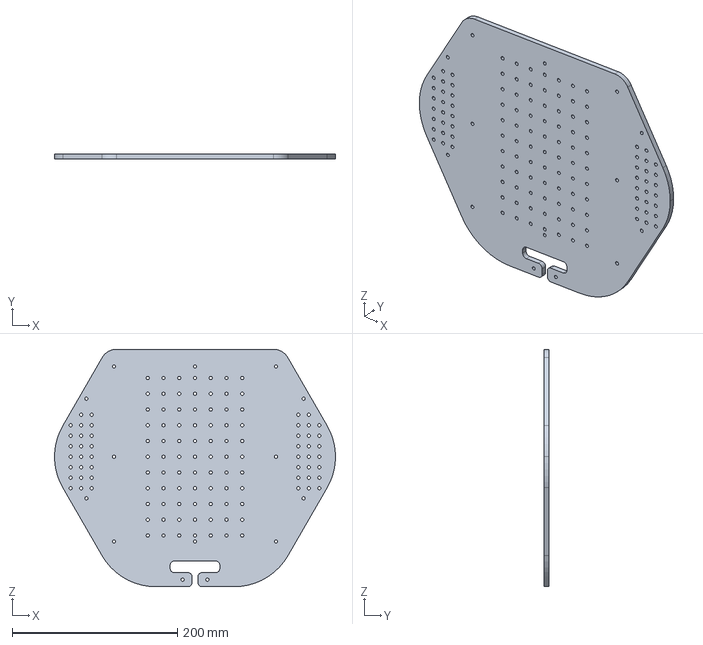
[picture p49: CAD file, 2019-10-09]
hardware/96 - Mechanical/RobotBases/Base_turtlebot/OriginalParts/plate_top.stp
340.0 x 6.00 x 287.3 mm
