introlab/securbot/hardware/96 - Mechanical/RobotBases/Contact_robotBase/Contact_robotBase_aluminium/Contact_barreFer.SLDPRT

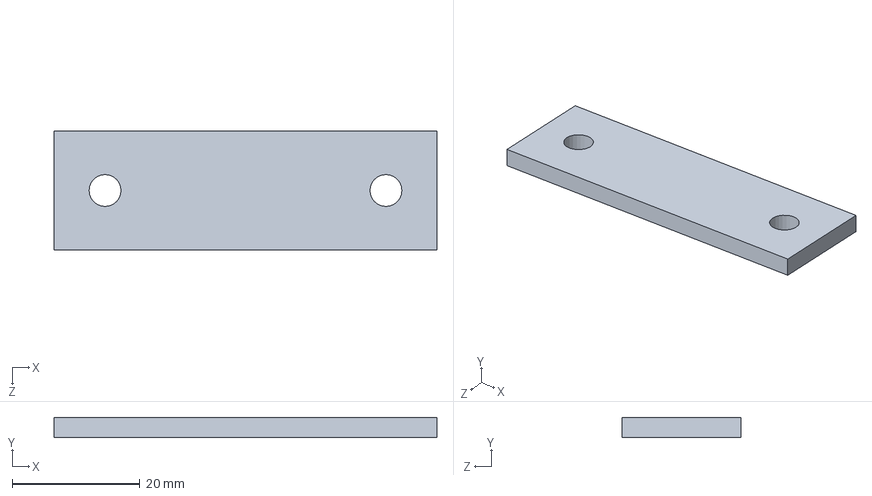
[picture p50: CAD file, 2019-10-18]
hardware/96 - Mechanical/RobotBases/Contact_robotBase/Contact_robotBase_aluminium/Contact_barreFer.SLDPRT
60.0 x 3.15 x 18.7 mm
