introlab/securbot/hardware/96 - Mechanical/RobotBases/Contact_robotBase/Contact_robotBase_nickel/Part1_contact.SLDPRT

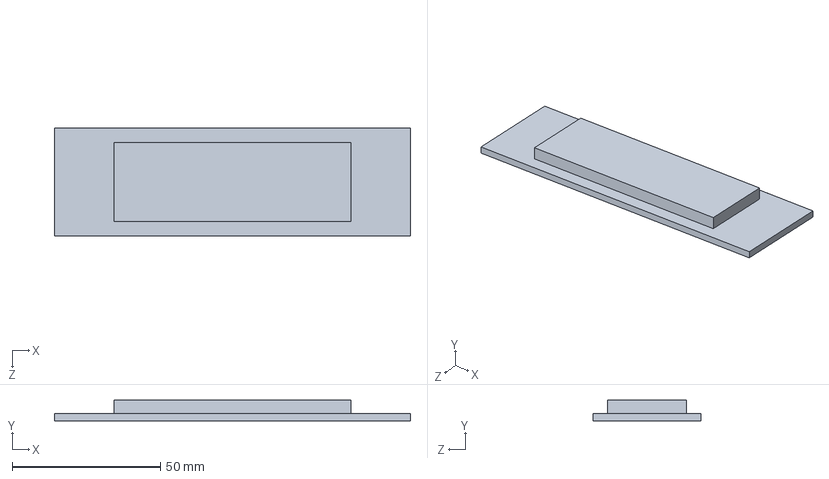
[picture p51: CAD file, 2019-10-13]
hardware/96 - Mechanical/RobotBases/Contact_robotBase/Contact_robotBase_nickel/Part1_contact.SLDPRT
120.0 x 7.00 x 36.5 mm
