introlab/securbot/hardware/96 - Mechanical/RobotBases/Cutouts_robotBase/Pioneer/Cutout_Pioneer_2.DXF

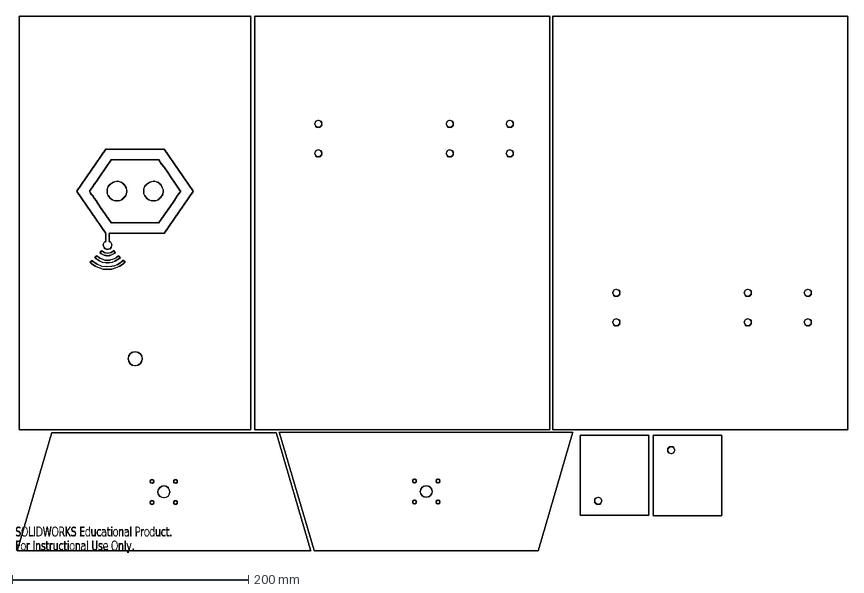
[picture p52: CAD file, 2019-10-27]
hardware/96 - Mechanical/RobotBases/Cutouts_robotBase/Pioneer/Cutout_Pioneer_2.DXF
SOLIDWORKS Educational Product.
For Instructional Use Only.
