introlab/securbot/hardware/96 - Mechanical/RobotBases/Cutouts_robotBase/TurtleBot/Cutout_Turtle_1.DXF

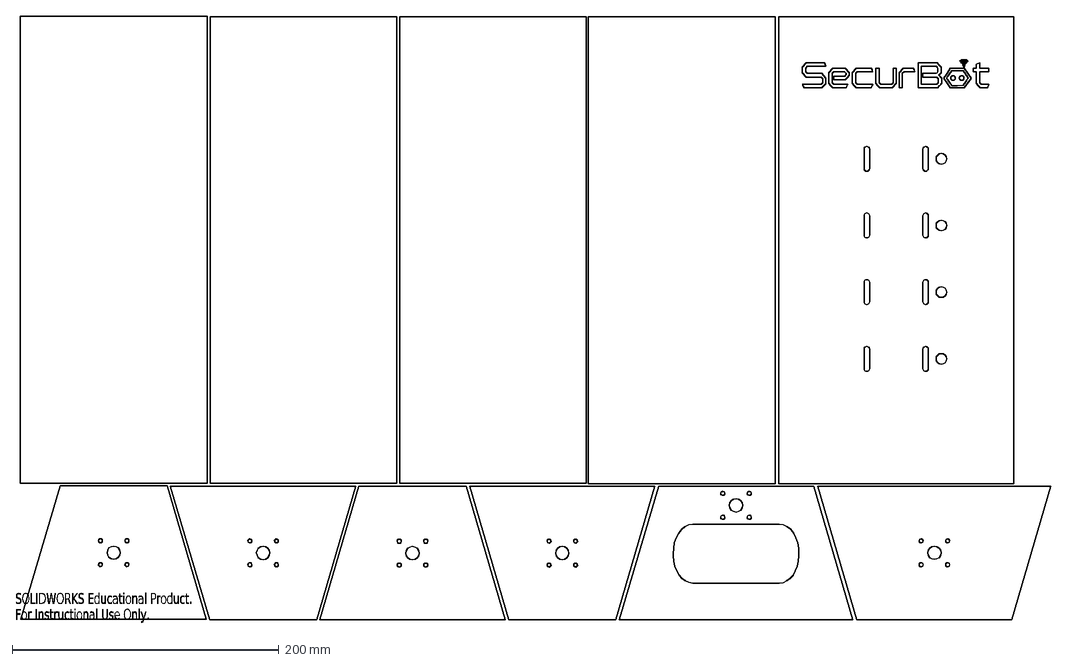
[picture p53: CAD file, 2019-10-27]
hardware/96 - Mechanical/RobotBases/Cutouts_robotBase/TurtleBot/Cutout_Turtle_1.DXF
SOLIDWORKS Educational Product.
For Instructional Use Only.
