introlab/securbot/hardware/96 - Mechanical/RobotBases/OdasMaterials/Board.SLDPRT

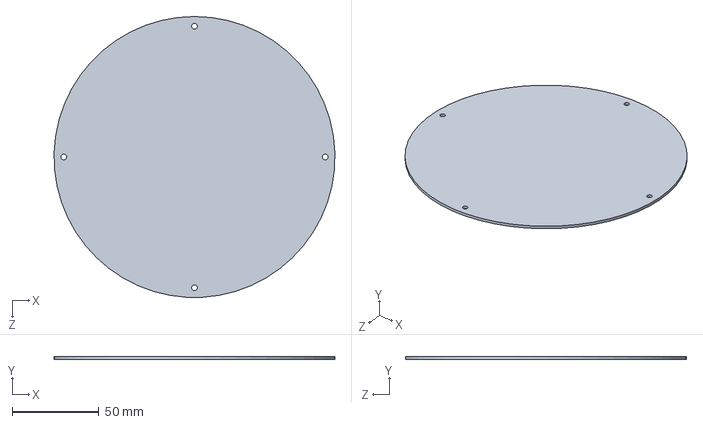
[picture p54: CAD file, 2019-10-18]
hardware/96 - Mechanical/RobotBases/OdasMaterials/Board.SLDPRT
161.9 x 1.64 x 162.0 mm
