introlab/securbot/hardware/96 - Mechanical/RobotBases/Prints3D_Links_Holder/Links_TopOfCap.SLDPRT

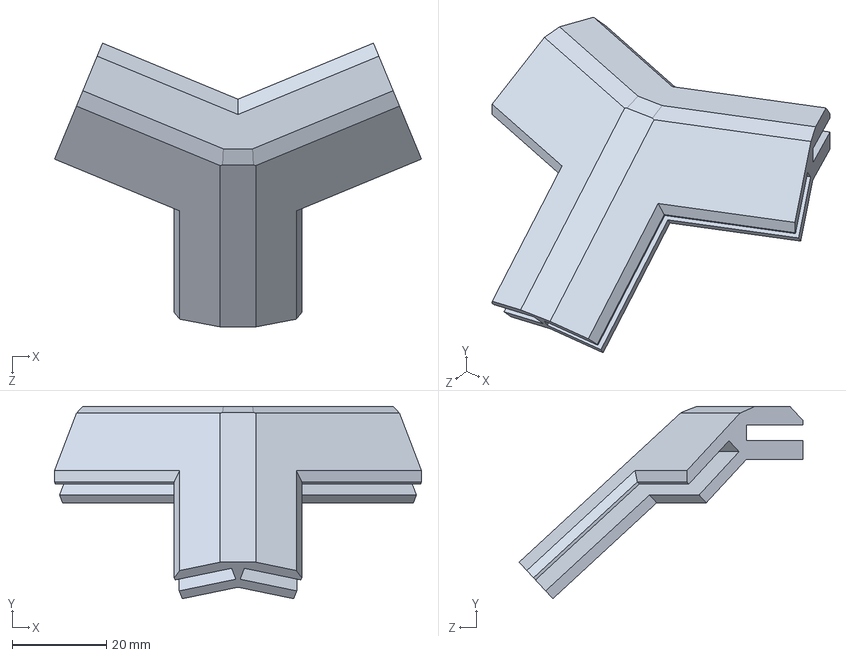
[picture p55: CAD file, 2019-10-18]
hardware/96 - Mechanical/RobotBases/Prints3D_Links_Holder/Links_TopOfCap.SLDPRT
77.9 x 40.9 x 60.2 mm
