introlab/securbot/hardware/96 - Mechanical/Charge Station/Links/Link_corner.SLDPRT

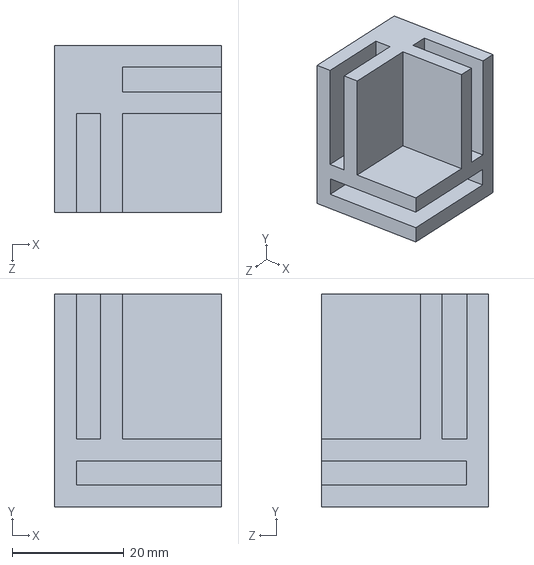
[picture p56: CAD file, 2019-10-15]
hardware/96 - Mechanical/Charge Station/Links/Link_corner.SLDPRT
30.0 x 38.2 x 30.0 mm
