introlab/securbot/hardware/96 - Mechanical/Contact bloc/Plastic pieces/Front_piece.SLDPRT

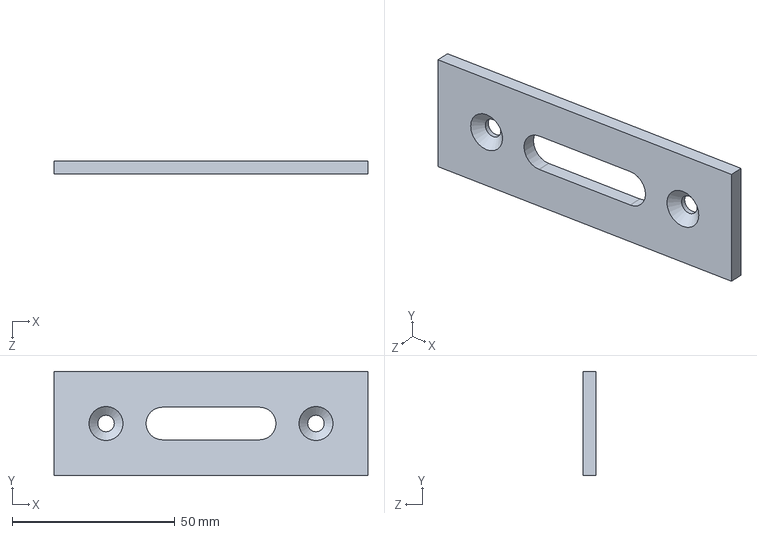
[picture p57: CAD file, 2019-10-15]
hardware/96 - Mechanical/Contact bloc/Plastic pieces/Front_piece.SLDPRT
96.6 x 32.0 x 4.00 mm
