introlab/securbot/hardware/96 - Mechanical/RobotBases/Base_pioneer/TopPlateScanAndDrawings/TopPlate_Pioneer_final.SLDPRT

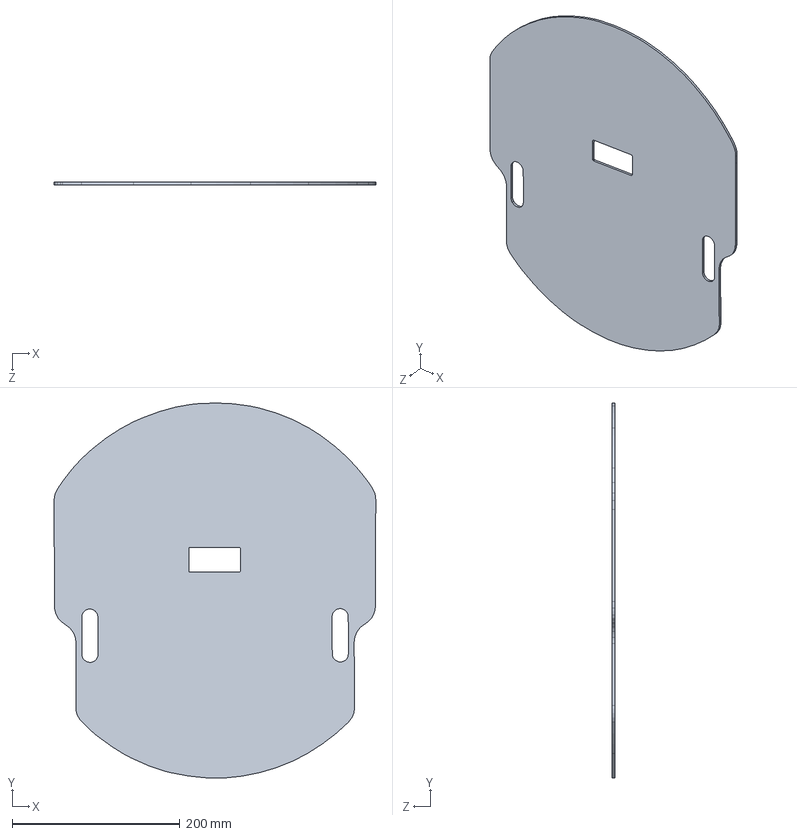
[picture p59: CAD file, 2019-09-10]
hardware/96 - Mechanical/RobotBases/Base_pioneer/TopPlateScanAndDrawings/TopPlate_Pioneer_final.SLDPRT
383.2 x 446.7 x 3.09 mm
