introlab/securbot/hardware/96 - Mechanical/RobotBases/Base_turtlebot/Panels/Body_Back_Panel_Turtle.SLDPRT

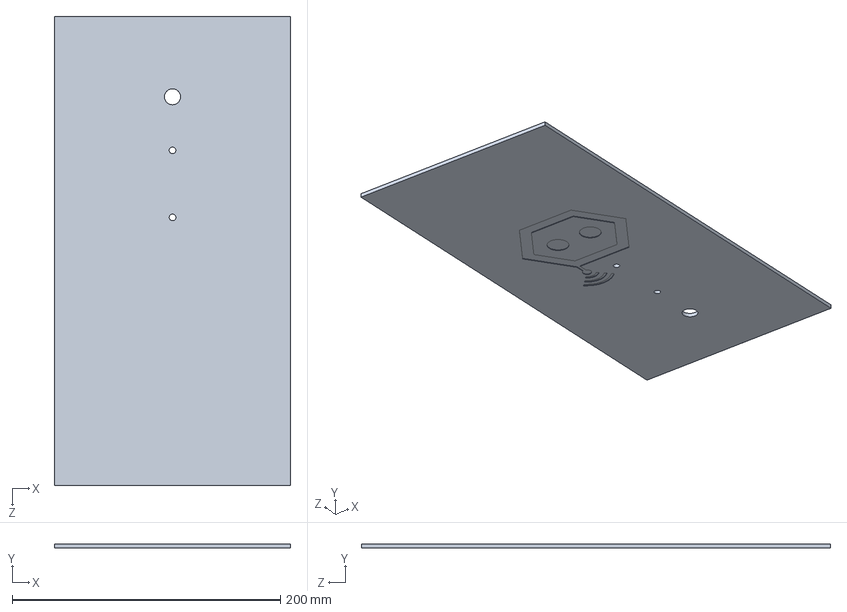
[picture p61: CAD file, 2019-10-27]
hardware/96 - Mechanical/RobotBases/Base_turtlebot/Panels/Body_Back_Panel_Turtle.SLDPRT
176.0 x 3.00 x 350.0 mm
