introlab/securbot/hardware/96 - Mechanical/RobotBases/Contact_robotBase/Contact_robotBase_aluminium/Contact_barreAlu.SLDPRT

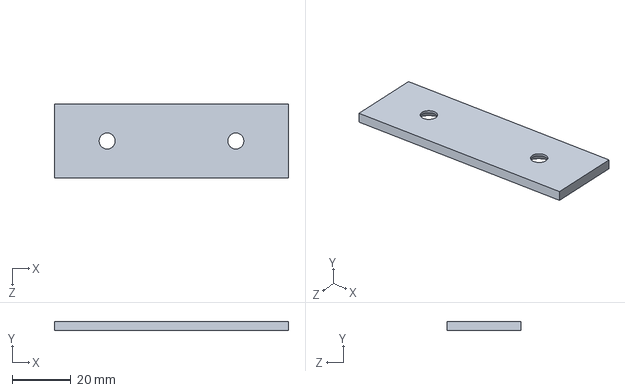
[picture p62: CAD file, 2019-10-18]
hardware/96 - Mechanical/RobotBases/Contact_robotBase/Contact_robotBase_aluminium/Contact_barreAlu.SLDPRT
80.0 x 3.20 x 25.3 mm
