introlab/securbot/hardware/96 - Mechanical/RobotBases/OdasMaterials/Micro.SLDPRT

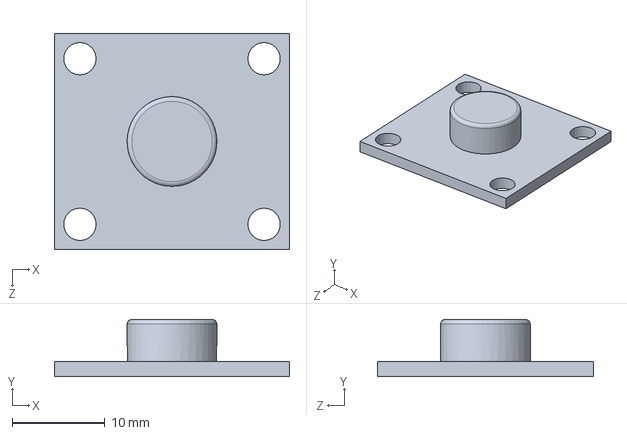
[picture p65: CAD file, 2019-10-18]
hardware/96 - Mechanical/RobotBases/OdasMaterials/Micro.SLDPRT
25.4 x 6.17 x 23.4 mm
