introlab/securbot/hardware/96 - Mechanical/RobotBases/Prints3D_Links_Holder/Links_ButtomOfBody.SLDPRT

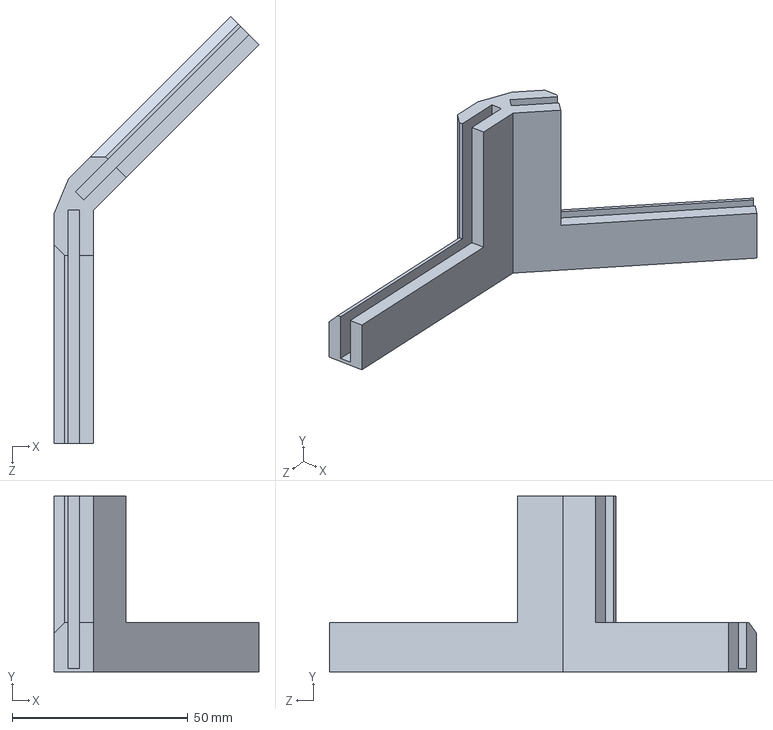
[picture p66: CAD file, 2019-10-18]
hardware/96 - Mechanical/RobotBases/Prints3D_Links_Holder/Links_ButtomOfBody.SLDPRT
58.3 x 50.0 x 121.5 mm
