introlab/securbot/hardware/96 - Mechanical/Charge Station/Pannels/Side_Panel.SLDPRT

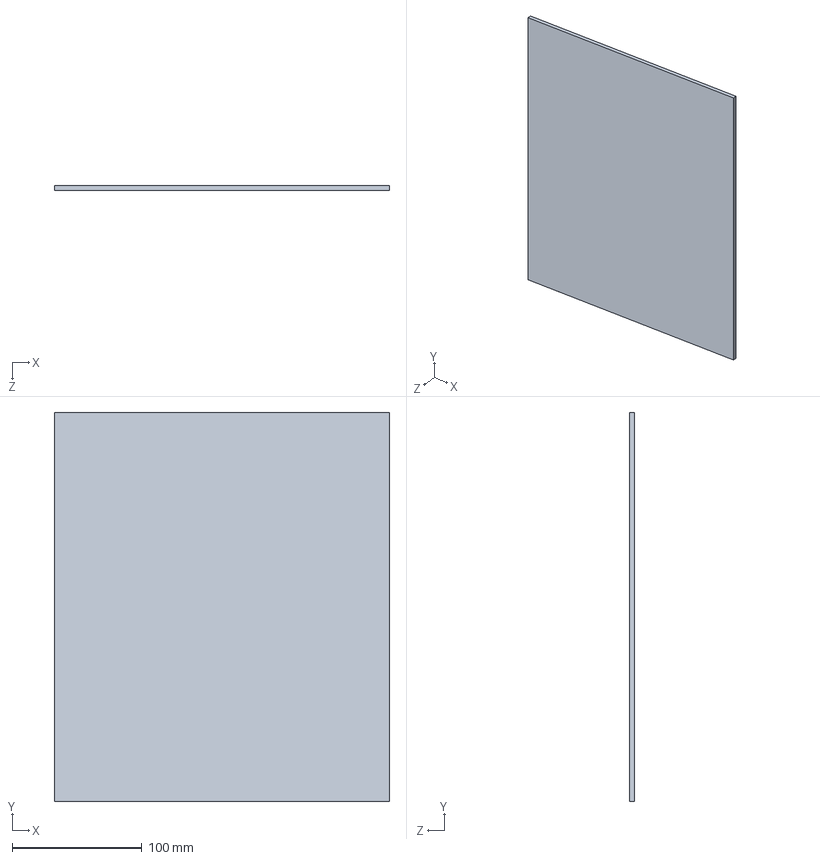
[picture p67: CAD file, 2019-10-15]
hardware/96 - Mechanical/Charge Station/Pannels/Side_Panel.SLDPRT
258.6 x 300.0 x 4.20 mm
