introlab/securbot/hardware/96 - Mechanical/RobotBases/Base_pioneer/Pioneer_originalRobotBase/CasterWheelBody.SLDPRT

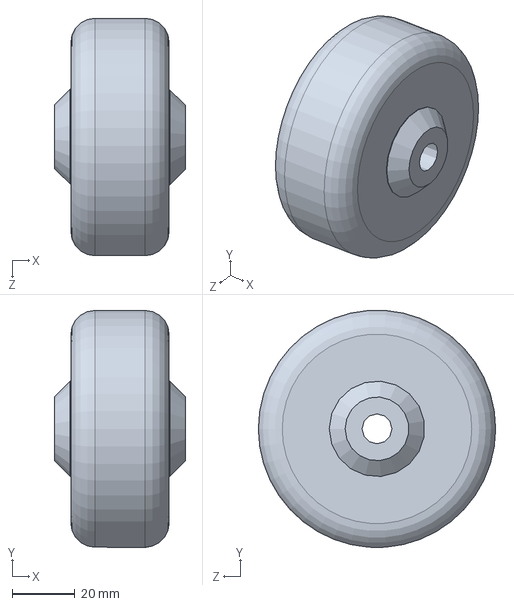
[picture p68: CAD file, 2019-10-16]
hardware/96 - Mechanical/RobotBases/Base_pioneer/Pioneer_originalRobotBase/CasterWheelBody.SLDPRT
41.9 x 75.6 x 75.7 mm
