introlab/securbot/hardware/96 - Mechanical/RobotBases/Base_turtlebot/OriginalParts/kobuki.SLDPRT

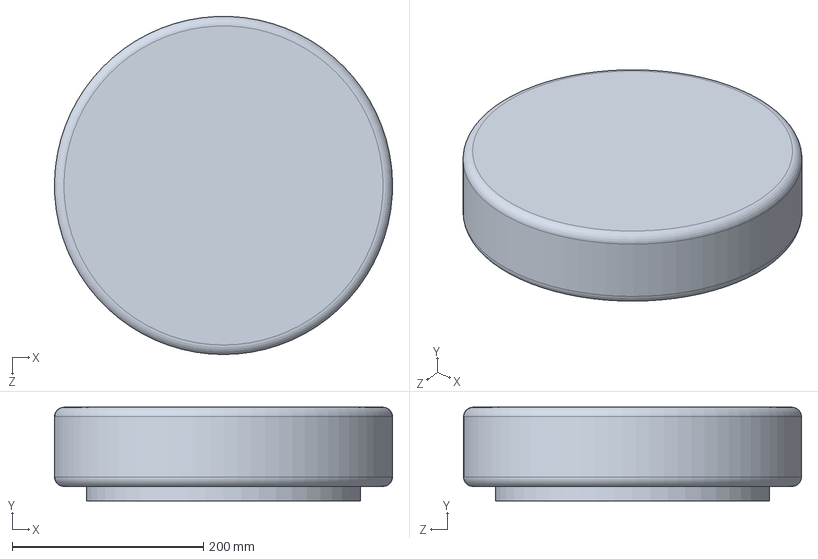
[picture p69: CAD file, 2019-10-09]
hardware/96 - Mechanical/RobotBases/Base_turtlebot/OriginalParts/kobuki.SLDPRT
353.9 x 98.0 x 353.8 mm
