introlab/securbot/hardware/96 - Mechanical/RobotBases/Contact_robotBase/Contact_robotBase_aluminium/ConnecteurAAnneau.SLDPRT

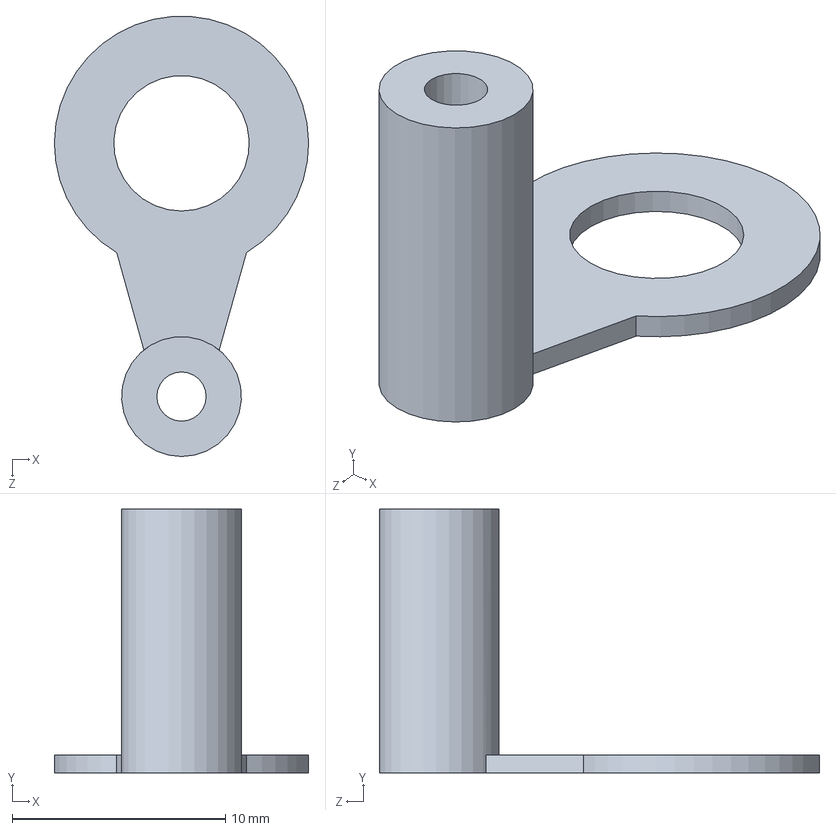
[picture p70: CAD file, 2019-10-16]
hardware/96 - Mechanical/RobotBases/Contact_robotBase/Contact_robotBase_aluminium/ConnecteurAAnneau.SLDPRT
11.9 x 12.4 x 20.6 mm
