introlab/securbot/hardware/96 - Mechanical/RobotBases/Prints3D_Links_Holder/Links_ButtomOfCap.SLDPRT

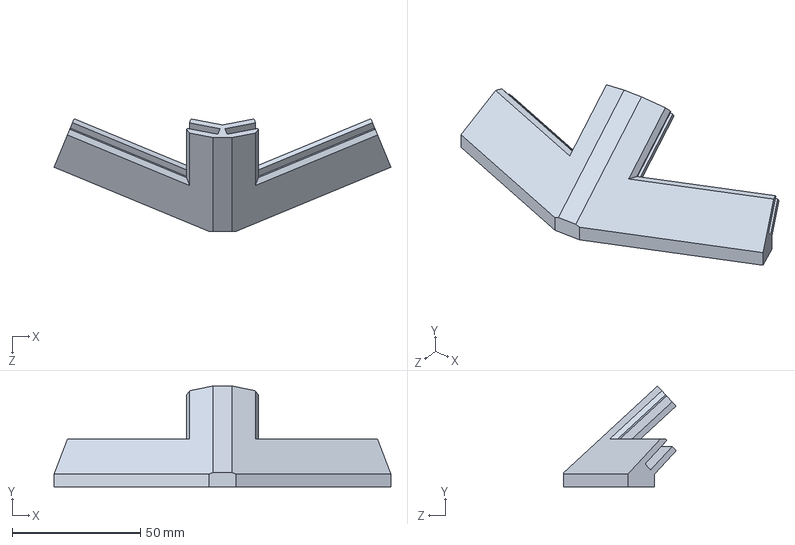
[picture p71: CAD file, 2019-10-12]
hardware/96 - Mechanical/RobotBases/Prints3D_Links_Holder/Links_ButtomOfCap.SLDPRT
131.5 x 39.4 x 44.0 mm
