introlab/securbot/hardware/96 - Mechanical/Charge Station/Links/Link_upper_side.SLDPRT

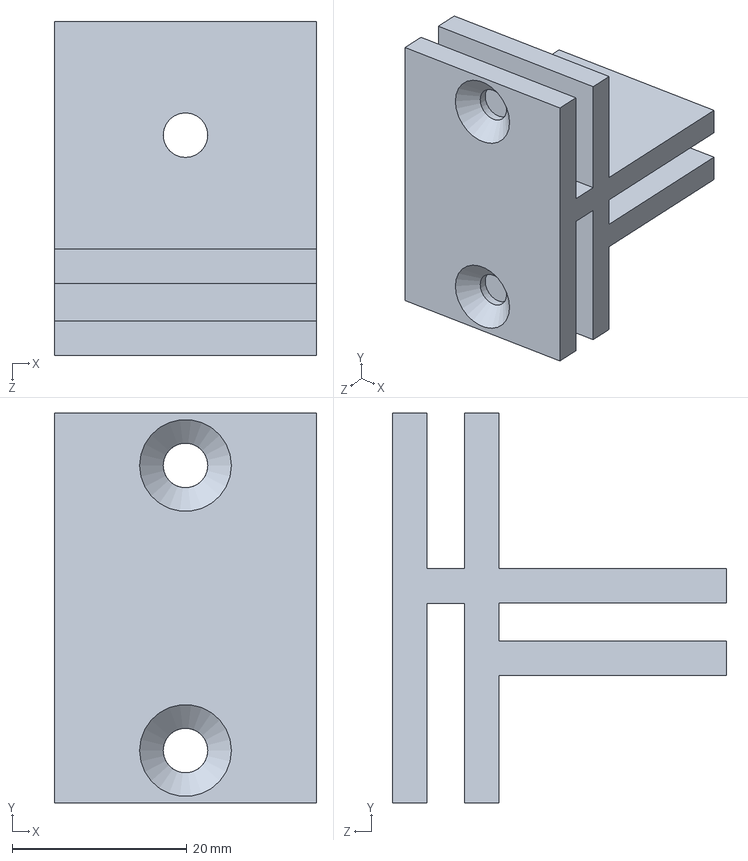
[picture p72: CAD file, 2019-10-10]
hardware/96 - Mechanical/Charge Station/Links/Link_upper_side.SLDPRT
30.0 x 44.6 x 38.2 mm
