introlab/securbot/hardware/96 - Mechanical/RobotBases/Base_pioneer/Pioneer_originalRobotBase/CasterWheelClamp.SLDPRT

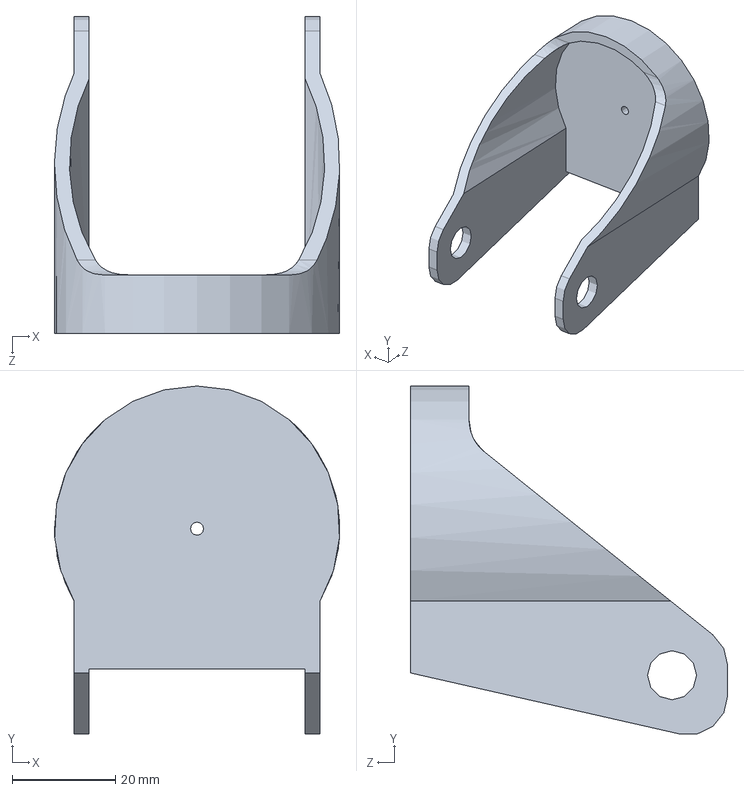
[picture p75: CAD file, 2019-10-16]
hardware/96 - Mechanical/RobotBases/Base_pioneer/Pioneer_originalRobotBase/CasterWheelClamp.SLDPRT
55.3 x 67.5 x 61.6 mm
