introlab/securbot/hardware/96 - Mechanical/RobotBases/Base_pioneer/TopPlateScanAndDrawings/Pioneer_Compare_Plates-TOP PLATE-1.SLDPRT

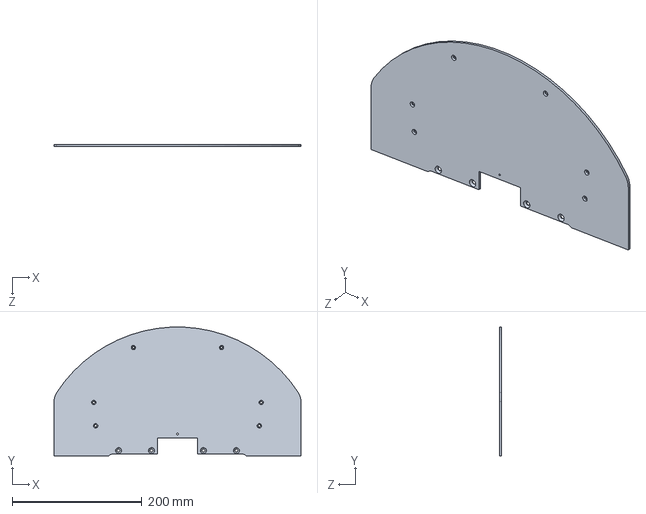
[picture p76: CAD file, 2019-09-10]
hardware/96 - Mechanical/RobotBases/Base_pioneer/TopPlateScanAndDrawings/Pioneer_Compare_Plates-TOP PLATE-1.SLDPRT
381.0 x 198.5 x 3.18 mm
