introlab/securbot/hardware/96 - Mechanical/RobotBases/Base_turtlebot/OriginalParts/plate_bottom.stp

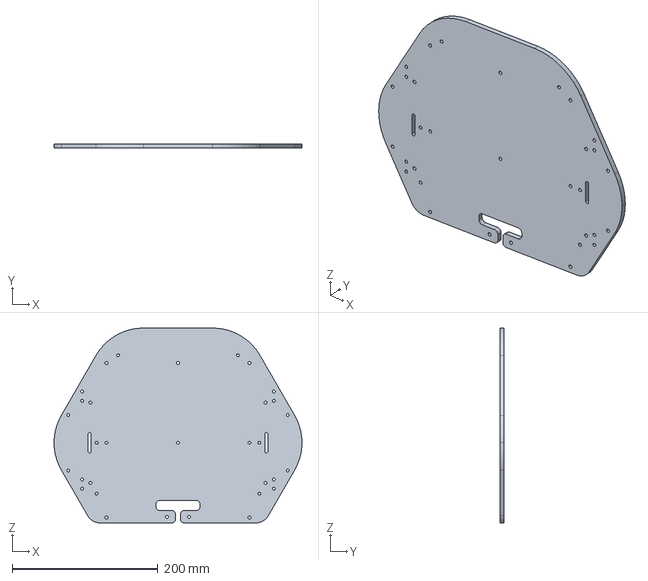
[picture p77: CAD file, 2019-10-09]
hardware/96 - Mechanical/RobotBases/Base_turtlebot/OriginalParts/plate_bottom.stp
340.0 x 6.00 x 267.3 mm
