introlab/securbot/hardware/96 - Mechanical/RobotBases/Prints3D_Links_Holder/Links_TopOfBody.SLDPRT

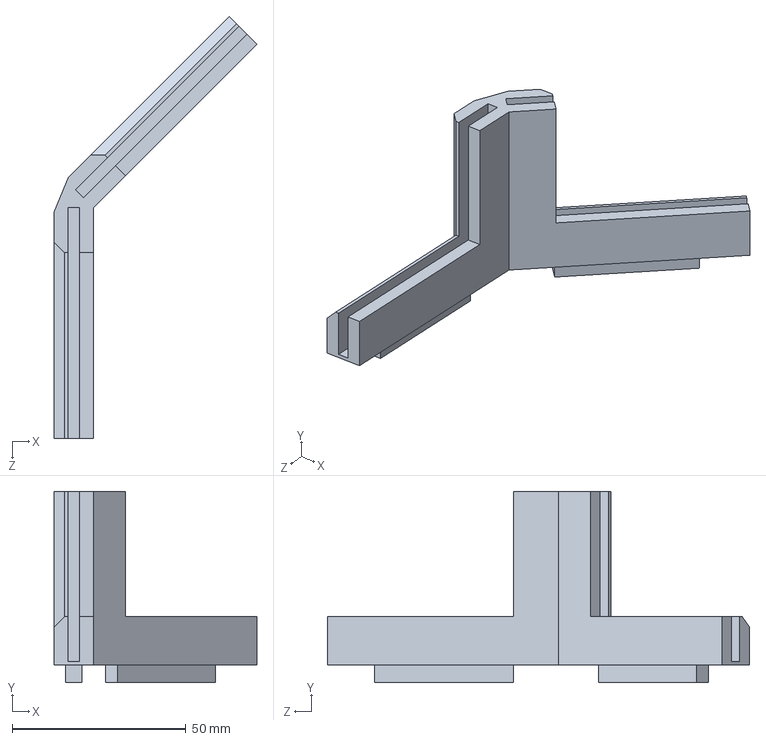
[picture p79: CAD file, 2019-10-09]
hardware/96 - Mechanical/RobotBases/Prints3D_Links_Holder/Links_TopOfBody.SLDPRT
58.3 x 55.0 x 121.5 mm
