introlab/securbot/hardware/96 - Mechanical/Charge Station/Links/Link_upper_corner_front_R.SLDPRT

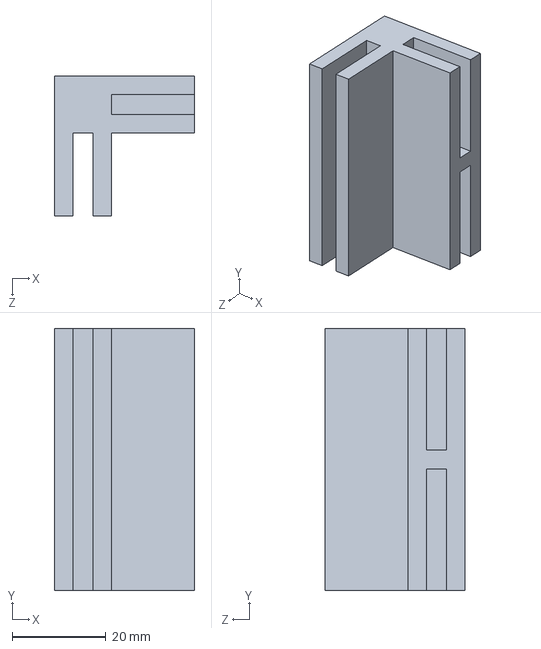
[picture p80: CAD file, 2019-10-10]
hardware/96 - Mechanical/Charge Station/Links/Link_upper_corner_front_R.SLDPRT
30.0 x 56.0 x 30.0 mm
