introlab/securbot/hardware/96 - Mechanical/RobotBases/Base_pioneer/Panels/Cap_Side_Panel_Pioneer.SLDPRT

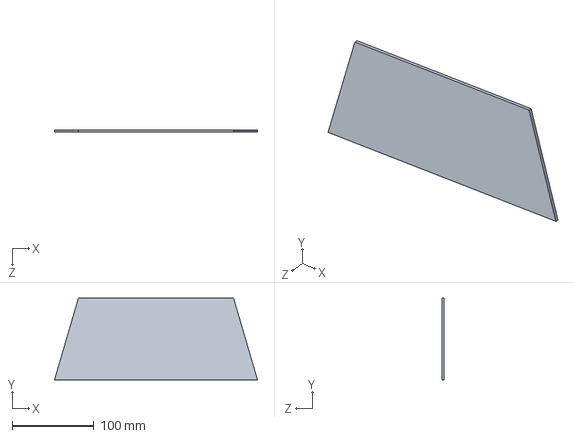
[picture p81: CAD file, 2019-10-27]
hardware/96 - Mechanical/RobotBases/Base_pioneer/Panels/Cap_Side_Panel_Pioneer.SLDPRT
248.5 x 100.0 x 3.01 mm
