introlab/securbot/hardware/96 - Mechanical/RobotBases/Base_turtlebot/OriginalParts/pole_middle.stp

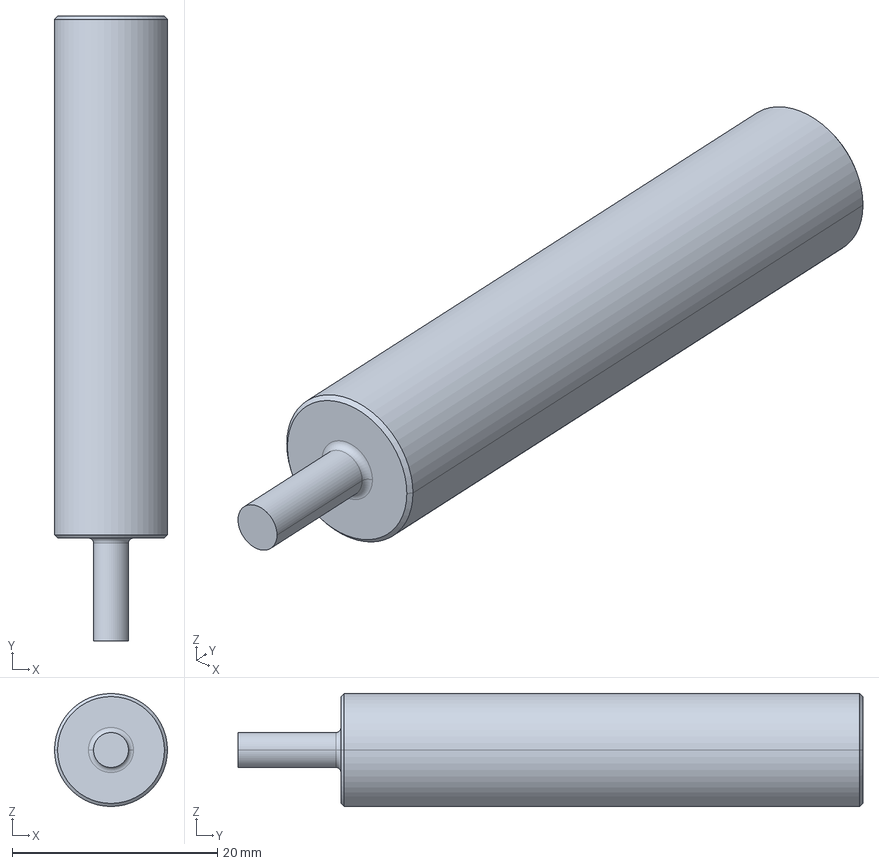
[picture p82: CAD file, 2019-10-09]
hardware/96 - Mechanical/RobotBases/Base_turtlebot/OriginalParts/pole_middle.stp
11.0 x 60.8 x 11.0 mm
