introlab/securbot/hardware/96 - Mechanical/RobotBases/Base_pioneer/TopPlateScanAndDrawings/Pioneer_top_plate.dxf

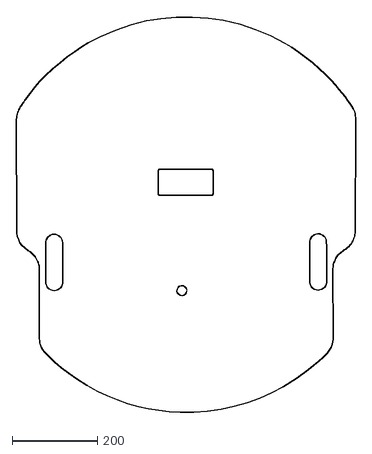
[picture p83: CAD file, 2019-09-10]
hardware/96 - Mechanical/RobotBases/Base_pioneer/TopPlateScanAndDrawings/Pioneer_top_plate.dxf
795.7 x 933.1
