introlab/securbot/hardware/96 - Mechanical/RobotBases/Base_turtlebot/OriginalParts/pole_bottom.stp

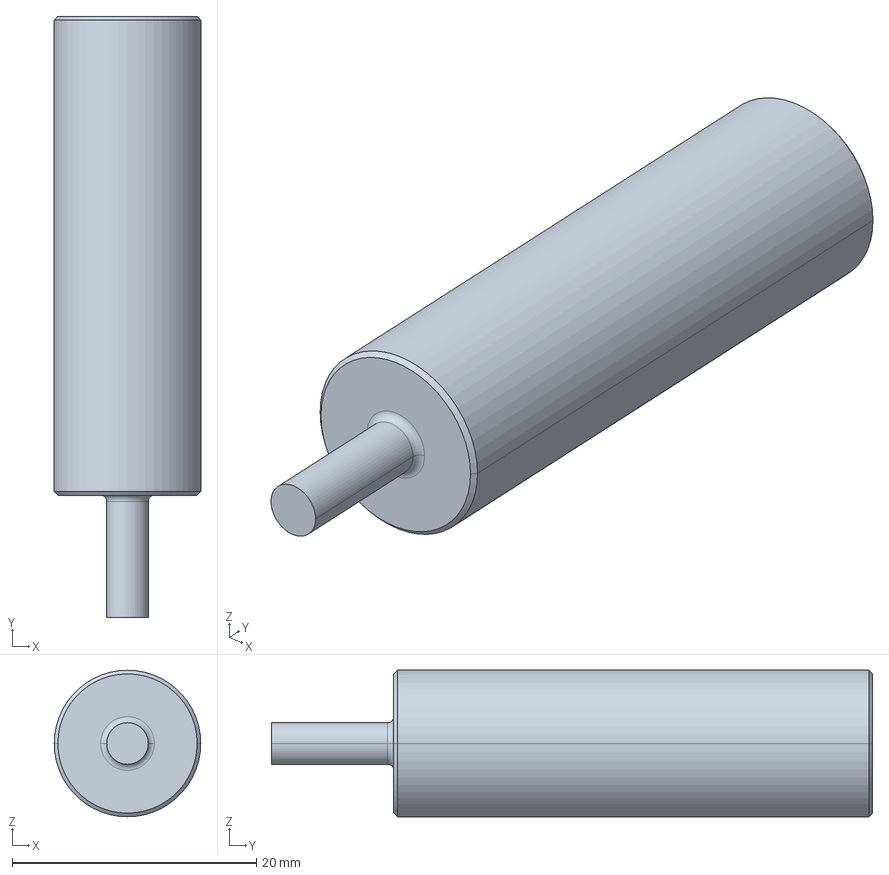
[picture p84: CAD file, 2019-10-09]
hardware/96 - Mechanical/RobotBases/Base_turtlebot/OriginalParts/pole_bottom.stp
12.0 x 49.2 x 12.0 mm
