introlab/securbot/hardware/96 - Mechanical/RobotBases/Base_turtlebot/Panels/Cap_TopPlate_Panel_turtle.SLDPRT

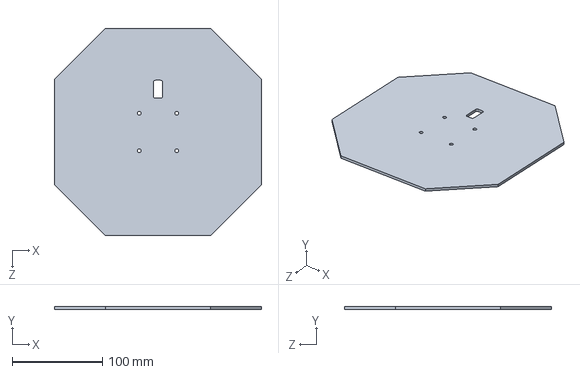
[picture p85: CAD file, 2019-10-27]
hardware/96 - Mechanical/RobotBases/Base_turtlebot/Panels/Cap_TopPlate_Panel_turtle.SLDPRT
230.0 x 3.00 x 230.0 mm
