introlab/securbot/hardware/96 - Mechanical/RobotBases/Base_turtlebot/OriginalParts/pole_kinect.stp

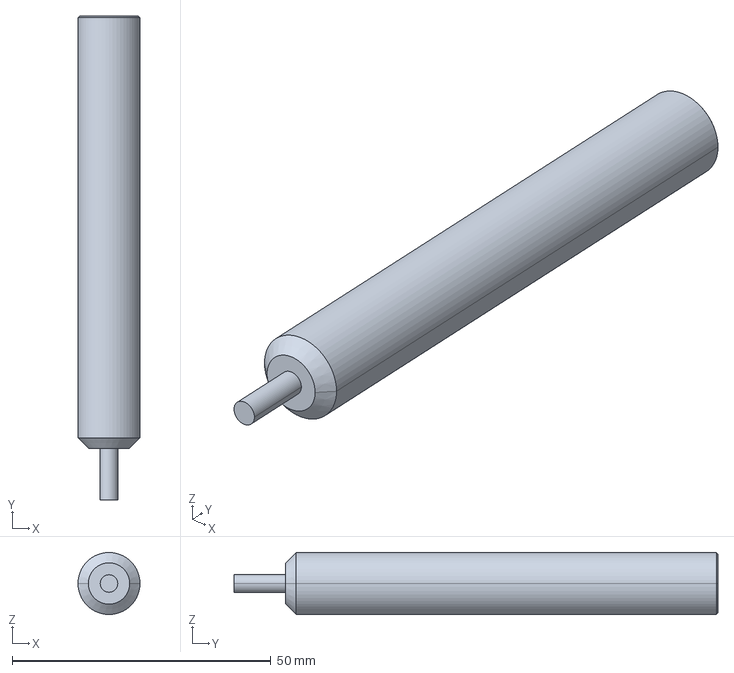
[picture p87: CAD file, 2019-10-09]
hardware/96 - Mechanical/RobotBases/Base_turtlebot/OriginalParts/pole_kinect.stp
12.0 x 93.6 x 12.0 mm
