introlab/securbot/hardware/96 - Mechanical/RobotBases/Base_turtlebot/Panels/Cap_Side_Panel_Turtle.SLDPRT

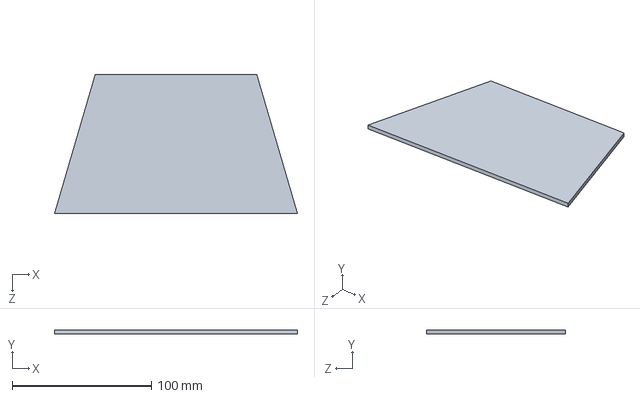
[picture p88: CAD file, 2019-10-27]
hardware/96 - Mechanical/RobotBases/Base_turtlebot/Panels/Cap_Side_Panel_Turtle.SLDPRT
174.8 x 3.00 x 100.0 mm
