introlab/securbot/hardware/96 - Mechanical/RobotBases/Base_pioneer/Panels/Cap_Top_Plate_Panel_Pioneer.SLDPRT

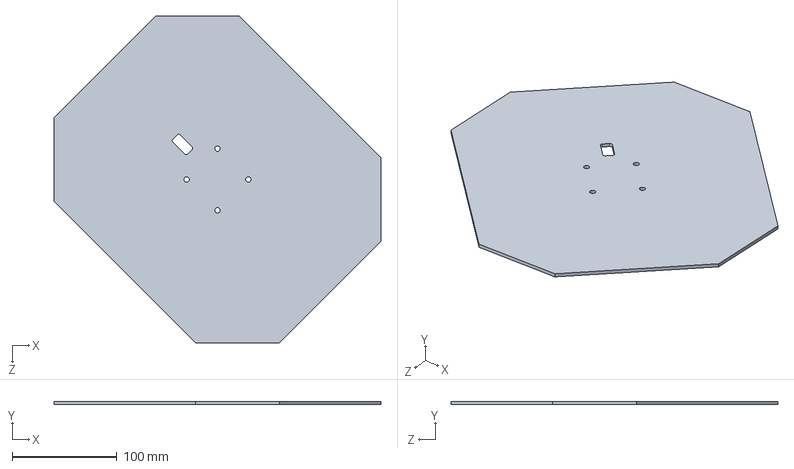
[picture p89: CAD file, 2019-10-27]
hardware/96 - Mechanical/RobotBases/Base_pioneer/Panels/Cap_Top_Plate_Panel_Pioneer.SLDPRT
312.9 x 3.00 x 312.9 mm
