introlab/securbot/hardware/96 - Mechanical/RobotBases/Base_turtlebot/OriginalParts/plate_middle.stp

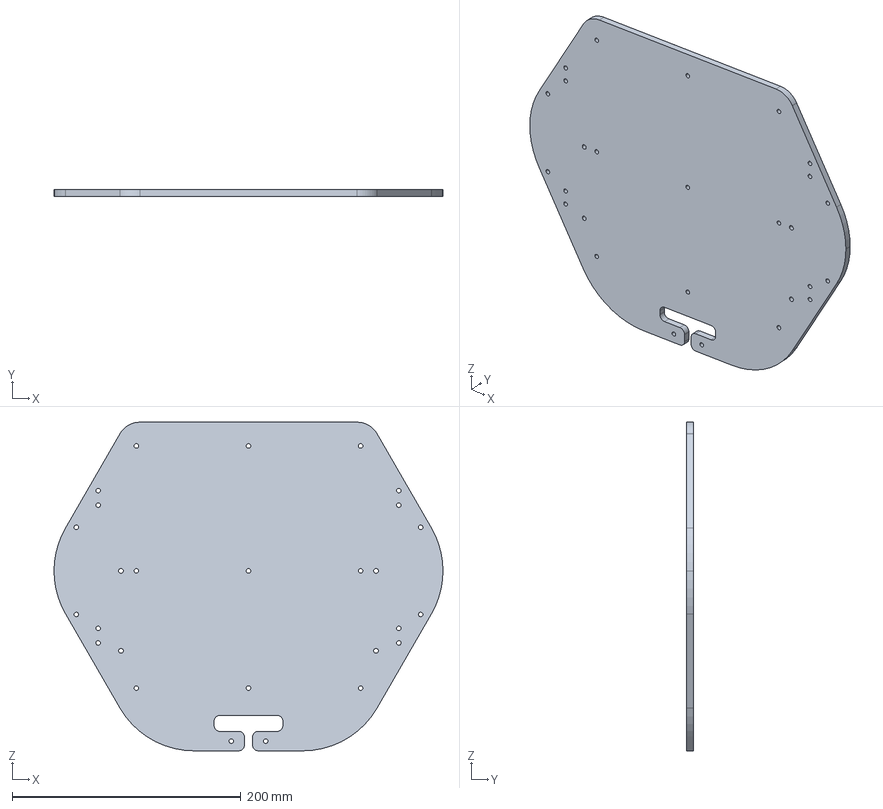
[picture p90: CAD file, 2019-10-09]
hardware/96 - Mechanical/RobotBases/Base_turtlebot/OriginalParts/plate_middle.stp
340.0 x 6.00 x 287.3 mm
