introlab/securbot/hardware/96 - Mechanical/RobotBases/Base_pioneer/Panels/TopPlateStructure.SLDPRT

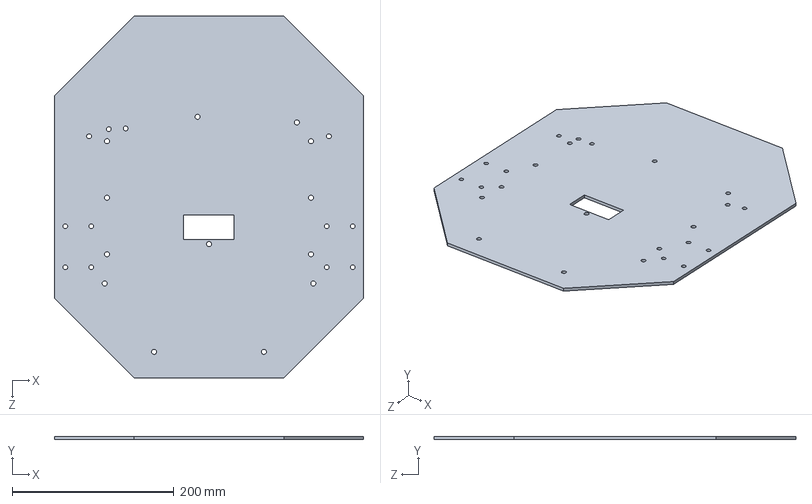
[picture p91: CAD file, 2019-10-27]
hardware/96 - Mechanical/RobotBases/Base_pioneer/Panels/TopPlateStructure.SLDPRT
383.0 x 4.12 x 448.0 mm
