introlab/securbot/hardware/96 - Mechanical/RobotBases/Base_turtlebot/Panels/Top_angle_turtle.SLDPRT

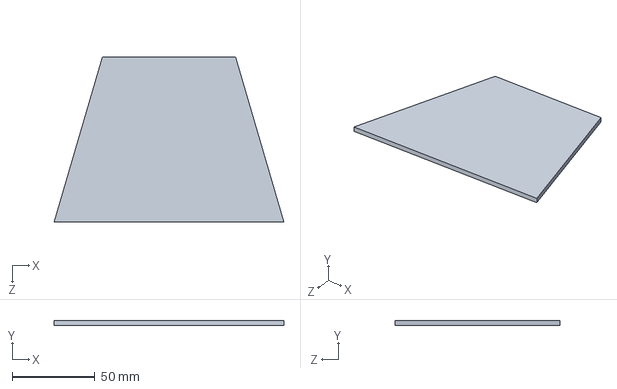
[picture p92: CAD file, 2019-10-18]
hardware/96 - Mechanical/RobotBases/Base_turtlebot/Panels/Top_angle_turtle.SLDPRT
139.0 x 3.00 x 100.0 mm
