introlab/securbot/hardware/96 - Mechanical/RobotBases/Base_pioneer/Panels/Cap_Front_Panel_Pioneer.SLDPRT

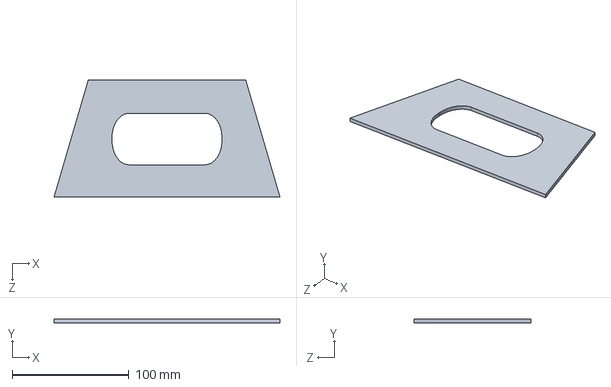
[picture p93: CAD file, 2019-10-27]
hardware/96 - Mechanical/RobotBases/Base_pioneer/Panels/Cap_Front_Panel_Pioneer.SLDPRT
193.2 x 3.00 x 100.0 mm
