introlab/securbot/hardware/96 - Mechanical/RobotBases/Base_pioneer/Panels/metalPlatePatch.SLDPRT

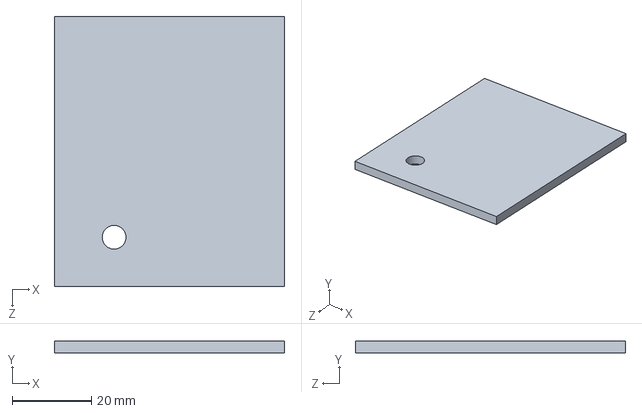
[picture p94: CAD file, 2019-10-16]
hardware/96 - Mechanical/RobotBases/Base_pioneer/Panels/metalPlatePatch.SLDPRT
58.0 x 3.00 x 68.0 mm
