introlab/securbot/(list of files, cad)

Other CAD files:
hardware/96 - Mechanical/RobotBases/Base_turtlebot/STL/BodyAttach_side_turtle.STL
hardware/96 - Mechanical/RobotBases/Base_turtlebot/TopPlate_Scan_Drawings/Part1.SLDPRT
hardware/96 - Mechanical/RobotBases/STL/RealSense_holder.STL
hardware/96 - Mechanical/RobotBases/Base_pioneer/BodyAttach/BodyAttachSecond.SLDPRT
hardware/96 - Mechanical/RobotBases/Base_pioneer/STL/BodyAttach.STL
hardware/96 - Mechanical/RobotBases/Base_pioneer/TopPlateScanAndDrawings/Part1.SLDPRT
hardware/96 - Mechanical/RobotBases/Base_turtlebot/Panels/Logo_SecurBot_font_carre.dxf
hardware/96 - Mechanical/RobotBases/Base_turtlebot/STL/BodyAttach_back_turtle.STL
hardware/96 - Mechanical/RobotBases/Base_turtlebot/TopPlate_Scan_Drawings/TopPlate_turtle_drawing.SLDPRT
hardware/96 - Mechanical/Charge Station/Pannels/Bottom_Pannel.SLDPRT
hardware/96 - Mechanical/Charge Station/Links/Link_upper_corner.SLDPRT
hardware/96 - Mechanical/RobotBases/Base_pioneer/Panels/Body_Front_panel_nickelContact_Pioneer.SLDPRT
hardware/96 - Mechanical/RobotBases/Base_turtlebot/Panels/Body_Front_Panel_aluContact_Turtle.SLDPRT
hardware/96 - Mechanical/RobotBases/Base_turtlebot/Panels/Body_Side_Panel_Turtle.SLDPRT
hardware/96 - Mechanical/Charge Station/Links/Link_upper_corner_front_L.SLDPRT
hardware/96 - Mechanical/RobotBases/Base_pioneer/Panels/Logo_SecurBot_font_carre.dxf
hardware/96 - Mechanical/RobotBases/Base_pioneer/Panels/Body_Front_panel_aluContact_Pioneer.SLDPRT
hardware/96 - Mechanical/RobotBases/Base_turtlebot/Panels/Body_Angled_Panel_Turtle.SLDPRT
hardware/96 - Mechanical/RobotBases/Base_turtlebot/Panels/Body_Front_Panel_nickelContact_Turtle.SLDPRT
hardware/96 - Mechanical/RobotBases/Base_turtlebot/Panels/Top_plate_turtle.SLDPRT
hardware/96 - Mechanical/RobotBases/Base_pioneer/Panels/Cap_Angled_Panel_Pioneer.SLDPRT
hardware/96 - Mechanical/RobotBases/Base_pioneer/Panels/metalPlatePatchGauche.SLDPRT
hardware/96 - Mechanical/Charge Station/AprilTagHolder.STL
hardware/96 - Mechanical/Charge Station/Bolts_Nuts_Misc/90592A095_STEEL HEX NUT.SLDPRT
hardware/96 - Mechanical/Charge Station/Bolts_Nuts_Misc/90604A148_PAN HEAD COMBINATION DRIVE MACHINE SCREW.SLDPRT
hardware/96 - Mechanical/Charge Station/Bolts_Nuts_Misc/90965A160_TYPE 316 STAINLESS STEEL FLAT WASHER.SLDPRT
hardware/96 - Mechanical/Charge Station/Bolts_Nuts_Misc/91780A133_ALUM FEM THRDED HEX STANDOFF.SLDPRT
hardware/96 - Mechanical/Charge Station/Bolts_Nuts_Misc/92010A793_PASSIVATED 18-8 SS PHILLIPS FLAT HEAD SCREW.SLDPRT
hardware/96 - Mechanical/Charge Station/Bolts_Nuts_Misc/Back_Pannel_Restrictor_for_supply_cable.SLDPRT
hardware/96 - Mechanical/Charge Station/Bolts_Nuts_Misc/Back_Pannel_Restrictor_for_supply_cable.STL
hardware/96 - Mechanical/Charge Station/Bolts_Nuts_Misc/Charge Station Board.SLDASM
hardware/96 - Mechanical/Charge Station/Bolts_Nuts_Misc/Power_supply.SLDPRT
hardware/96 - Mechanical/Charge Station/Links/Link_corner.STL
hardware/96 - Mechanical/Charge Station/Links/Link_upper_corner_L.STL
hardware/96 - Mechanical/Charge Station/Links/Link_upper_corner_R.STL
hardware/96 - Mechanical/Charge Station/Pannels/Back_Pannel.DXF
hardware/96 - Mechanical/Charge Station/Pannels/Bottom_Pannel.DXF
hardware/96 - Mechanical/Charge Station/Pannels/Front_Pannel.DXF
hardware/96 - Mechanical/Charge Station/Pannels/Side_Panel.DXF
hardware/96 - Mechanical/Charge Station/Pannels/Upper_Pannel.DXF
hardware/96 - Mechanical/Contact bloc/Bolts_Nuts_Misc/90592A095_STEEL HEX NUT.SLDPRT
hardware/96 - Mechanical/Contact bloc/Bolts_Nuts_Misc/90965A160_TYPE 316 STAINLESS STEEL FLAT WASHER.SLDPRT
hardware/96 - Mechanical/Contact bloc/Bolts_Nuts_Misc/92010A346_METRIC 18-8 SS FLAT HEAD PHIL MACHINE SCREW.SLDPRT
hardware/96 - Mechanical/Contact bloc/Bolts_Nuts_Misc/9434K730_MUSIC-WIRE STEEL COMPRESSION SPRINGS.SLDPRT
hardware/96 - Mechanical/Contact bloc/Bolts_Nuts_Misc/Magnet.SLDPRT
hardware/96 - Mechanical/Contact bloc/Plastic pieces/Base_of_box.STL
hardware/96 - Mechanical/Contact bloc/Plastic pieces/Front_piece.STL
hardware/96 - Mechanical/Contact bloc/Plastic pieces/Slider_double.STL
hardware/96 - Mechanical/RobotBases/Base_pioneer/TopPlateScanAndDrawings/Pioneer.dxf
hardware/96 - Mechanical/RobotBases/Cutouts_robotBase/Pioneer/Cutout_Pioneer_1.SLDDRW
hardware/96 - Mechanical/RobotBases/Cutouts_robotBase/Pioneer/Cutout_Pioneer_2.SLDDRW
hardware/96 - Mechanical/RobotBases/Cutouts_robotBase/Pioneer/Cutout_Pioneer_3.SLDDRW
hardware/96 - Mechanical/RobotBases/Cutouts_robotBase/TestPartForCut.SLDDRW
hardware/96 - Mechanical/RobotBases/Cutouts_robotBase/TurtleBot/Cutout_Turtle_1.SLDDRW
hardware/96 - Mechanical/RobotBases/Cutouts_robotBase/TurtleBot/Cutout_Turtle_2.SLDDRW
hardware/96 - Mechanical/RobotBases/OdasMaterials/91290A110_BLACK-OXIDE CLASS 12.9 SOCKET HEAD CAP SCREW.SLDPRT
hardware/96 - Mechanical/RobotBases/OdasMaterials/95610A330_NYLON FLAT WASHER.SLDPRT
hardware/96 - Mechanical/RobotBases/OdasMaterials/98952A120_ALUM MALE-FEM THRDED HEX STANDOFF.SLDPRT
hardware/96 - Mechanical/RobotBases/OdasMaterials/Micro_withScrews.SLDASM
