introlab/securbot/test/Mapping and Navigation/Complete-TurtleBot-Navigation_and_Mapping-SEC422.rtf

Info

Test designer: Alexandre Guilbault
Creation date: 04/04/2019
ID Jira: SEC-384
Test Title: TurtleBot Navigation

Test description

Test objectives and goals:
Validate that the navigation parameters used on the pioneer work as well on the TurtleBot

Sub-system(s):
Navigation

Component(s) (devices and test equipment):
-TurtleBot with rasberrypie
-Hokuyo URG Lx04
-kinect
-Laptop

Environment (location, conditions):
P2-1033, P2-1004 → Lab environnement at the 3it

Test Procedure (include files and illustrations):
To perform the test, RTAB-Map needs a map. Used the mapping.launch file to create a map.

- Power on the rasberrypie
- Power on the kinect
- Power on the lidar

[On TurtleBot]
$ roscore
(other tab)
$ roslaunch securbot_pkg localization.launch
(other tab)
$ roslaunch securbot_pkg navigation.launch

[On Laptop]
$ roscd securbot_pkg/launch
$ rosrun rviz rviz -d navigation.rviz

- Manipulations:
1) Position the TurtleBot in the P2-1033 so it looks at the door to help it find itself in the map.
2) Using RVIZ, send the TurtleBot to different locations in the P2-1033.
3) Using RVIZ, send the TurtleBot in the corridor.
4) Using RVIZ, go in the P2-1004. (The door should be open)
5) Using RVIZ, go to the washrooms near the clean rooms.
6) Using RVIZ, go to the end of that corridor.
7) Using RVIZ, come back to the P2-1033.

Test parameters and inputs (limits, tolerances, settings):
Inputs are the position in RVIZ.

Parameters are the navigation parameters in the following files:
base_local_planner_params.yaml
global_costmap_params.yaml
costmap_common_params.yaml
local_costmap_params.yaml

They are located in ~/catkin_ws/src/Robot_Software/securbot_pkg/config/turtlebot.

Expected results:
1) The TurtleBot should reach the desired location and orientation without any collision.
2) The TurtleBot should reach the desired location and orientation without any collision.
3) The TurtleBot should reach the desired location and orientation without any collision.
4) The TurtleBot should reach the desired location and orientation without any collision.
5) The TurtleBot should reach the desired location and orientation without any collision.
6) The TurtleBot should reach the desired location and orientation without any collision.
7) The TurtleBot should reach the desired location and orientation without any collision.

Security

Potential risks:
[ YES / NO ] Mechanical equipment damages (high speeds, sharp objects, projectiles)
[ YES / NO ] Electrical equipment damages (high power, reverse polarity, ESD, shorts)
[ YES / NO ] Thermal hazards (power dissipation, friction, heat-sensitive/flamable components)
[ YES / NO ] Chemicals (batteries, contaminants, exposition, airborne particles)
[ YES / NO ] New components (first tests, original/student designs)
[ YES / NO ] Human risks (operator proximity, ergonomics, environment, bystanders)
[ YES / NO ] Others: _______________________________
___________________________________________________
___________________________________________________

Risk mitigation:

Neutralization at the source:
The pioneer should always be on the ground when it is powered on.

Collective protections:
Someone from the team has to follow the robot to ensure it does not endanger itself or bystanders.

Personal protections:

Approbation

Approved by: ______________________
Date: ________________________

Test Results

Test 1 : Alexandre Guilbault, April 19th 2019
Complete test with the turtlebot
Results & Comments
Since the TurtleBot as a lidar with a smaller range, the mapping process is longer. The robot needs to pass through each hallway multiple times to find as many features as possible.

Once the map is complete, the robot navigates well.
However, not seeing the end of the hallway with the lidar makes the robot drift on its map. Most of the times, it can replace itself, but it might get stuck between obstacles and remaining obstacles.

Overall, the navigation is as good as we can expect to achieve with a 4 meter lidar and a kinect.

__________________________________________________
