introlab/securbot/test/Mapping and Navigation/Pioneer-Mapping_SEC-335.rtf

Info

Test designer: Cédric Godin
Creation date: 19/03/2019
ID Jira: SEC-335
Test Title: Pioneer Mapping

Test description

Test objectives and goals:
Validate mapping features on Pioneer robot

Sub-system(s): Navigation

Component(s) (devices and test equipment):
-Pioneer
-Roboclaw
-RP-Lidar
-Intel Realsense d435
-Laptop

Environment (location, conditions): 1033

Test Procedure (include files and illustrations):

-Unplug lidar usb under pioneer top on left side
-Open pioneer top
-Plug Roboclaw in orange power pack
-Plug Jetson power supply (extension cord suggested)
-Install top on pioneer
-Plug in lidar under pioneer top on left side
-Power on Jetson (power button reachable trough hole on pioneer right side

[On Pioneer]
$ roslaunch securbot_pkg mapping.launch

[On Laptop]
$ roscd securbot_pkg/launch
$ rosrun rviz rviz -d mapping.rviz
(other tab)
$ rosrun teleop_twist_keyboard teleop_twist_keyboard.py

Drive pioneer robot around.

Test paramters and inputs (limits, tolerances, settings):
Sensor data, teleop commands

Expected results:
-Robot should move according to keyboard input, should stop if no command for more then 1 seconds.
Spam key to go far.
-base_footprint Axes in Rviz should match robot position in map Axes
-map cloud should match environnement
-map shoudl match environnement

Security

Potential risks:
[ YES / NO ] Mechanical equipment damages (high speeds, sharp objects, projectiles)
[ YES / NO ] Electrical equipment damages (high power, reverse polarity, ESD, shorts)
[ YES / NO ] Thermal hazards (power dissipation, friction, heat-sensitive/flamable components)
[ YES / NO ] Chemicals (batteries, contaminants, exposition, airborne particles)
[ YES / NO ] New components (first tests, original/student designs)
[ YES / NO ] Human risks (operator proximity, ergonomics, environment, bystanders)
[ YES / NO ] Others: _______________________________
___________________________________________________
___________________________________________________

Risk mitigation:

Neutralization at the source: _____________________________
___________________________________________________

Collective protections: _________________________________
___________________________________________________

Personal protections: _________________________________
__________________________________________________

Approbation

Approved by: ______________________
Date: ________________________

Test Results

Tester | Time & date | Results | Comments
Cédric Godin | 19-03-2019 | Pass

Comments

__________________________________________________
