introlab/securbot/test/Mapping and Navigation/Pioneer-move_base_SEC-343.rtf

Info

Test designer: Cédric Godin
Creation date: 20/03/2019
ID Jira: SEC-343
Test Title: Pioneer move_base validation

Test description

Test objectives and goals:
Validate proper operation of move_base path planning node on pioneer robot

Sub-system(s): navigation

Component(s) (devices and test equipment):
-Pioneer
-Roboclaw
-RP-Lidar
-Intel Realsense d435
-Laptop

Environment (location, conditions): 1033

Test Procedure (include files and illustrations):

THERE MUST BE A VALID RTAB-MAP DATABASE ON THE ROBOT BEFORE RUNNING NAVIGATION. SEE MAPPING TEST.
NAVIGATION AREA MUST BE MAPPED.

-Unplug lidar usb under pioneer top on left side
-Open pioneer top
-Plug Roboclaw in orange power pack
-Plug Jetson power supply (extension cord suggested)
-Install top on pioneer
-Plug in lidar under pioneer top on left side
-Power on Jetson (power button reachable trough hole on pioneer right side

[On Pioneer]
$ roslaunch securbot_pkg localization.launch
$ roslaunch securbot_pkg navigation.launch

[On Laptop]
$ roscd securbot_pkg/launch
$ rosrun rviz rviz -d navigation.rviz

Validate that robot is localized in map. If necessary, move robot around using teleop twist joystick. See mapping.
Set goal with the 2D nav goal button in rviz then click and drag in the map.

Test paramters and inputs (limits, tolerances, settings):
Existing database, nav goal trough rviz

Expected results:
Robot reaches goal avoiding obstacles.
Global and local costmaps are updated in rviz and match robot environnement.

Security

Potential risks:
[ YES / NO ] Mechanical equipment damages (high speeds, sharp objects, projectiles)
[ YES / NO ] Electrical equipment damages (high power, reverse polarity, ESD, shorts)
[ YES / NO ] Thermal hazards (power dissipation, friction, heat-sensitive/flamable components)
[ YES / NO ] Chemicals (batteries, contaminants, exposition, airborne particles)
[ YES / NO ] New components (first tests, original/student designs)
[ YES / NO ] Human risks (operator proximity, ergonomics, environment, bystanders)
[ YES / NO ] Others: _______________________________
___________________________________________________
___________________________________________________

Risk mitigation:

Neutralization at the source: _____________________________
___________________________________________________

Collective protections: _________________________________
___________________________________________________

Personal protections: _________________________________
__________________________________________________

Approbation

Approved by: ______________________
Date: ________________________

Test Results

Tester | Time & date | Results | Comments
Cédric Godin | 03-20-2019 | Passed | Robot path planning is jerky some times.

Comments

Further refining of base planner setting needs to be done.
