introlab/securbot/test/Mapping and Navigation/Pioneer-Odometry_Testing_SEC-335.rtf

Info

Test designer: Cédric Godin
Creation date: 18/03/2019
ID Jira: SEC-335
Test Title: Pioneer Odometry Testing

Test description

Test objectives and goals:
Validate tf dynamic transform from odom to base_footprint

Sub-system(s):
Pioneer, navigation, roboclaw

Component(s) (devices and test equipment):
Pioneer
Roclaw
Jetson
Latptop (for monitoring)

Environment (location, conditions): 1033

Test Procedure (include files and illustrations):
Launch securbot_pkg/lauch/navigation.launch

Test paramters and inputs (limits, tolerances, settings):
Cartesian motion of robot by hand
Display referential on rviz

Expected results:
Base footprint follows robot motion

Security

Potential risks:
[ YES / NO ] Mechanical equipment damages (high speeds, sharp objects, projectiles)
[ YES / NO ] Electrical equipment damages (high power, reverse polarity, ESD, shorts)
[ YES / NO ] Thermal hazards (power dissipation, friction, heat-sensitive/flamable components)
[ YES / NO ] Chemicals (batteries, contaminants, exposition, airborne particles)
[ YES / NO ] New components (first tests, original/student designs)
[ YES / NO ] Human risks (operator proximity, ergonomics, environment, bystanders)
[ YES / NO ] Others: _______________________________
___________________________________________________
___________________________________________________

Risk mitigation:

Neutralization at the source: _____________________________
___________________________________________________

Collective protections: _________________________________
___________________________________________________

Personal protections: _________________________________
__________________________________________________

Approbation

Approved by: ______________________
Date: ________________________

Test Results

Tester | Time & date | Results | Comments
Cédric Godin | 18-03-2019 | Forward/Reverse OK, Front/Rear are reversed after the robot turn for 90°/-90° | Motors connexions mismatch assumption in roboclaw node code, node will be corrected. Hypothesis is to add pi to rotation angle.

Comments

__________________________________________________
