introlab/securbot/test/Mapping and Navigation/RP-LIDAR-integration_SEC-331.rtf

Info

Test designer: Cédric Godin
Creation date: 2019/03/15
ID Jira: SEC-331
Test Title: RP-LIDAR-integration

Test description

Test objectives and goals:
Plug RP-LIDAR and view laser scan data in RVIZ

Sub-system(s): Navigation

Component(s) (devices and test equipment):
-RP-LIDAR
-RP-LIDAR Serial to USB adapter
-Laptop
-Micro USB Cable

Environment (location, conditions):
P2-1033
Room conditions

Test Procedure (include files and illustrations):
-Use code in pioneer-ros-integration branch
-Create udev rules with script inside rplidar-ros package
./scripts/create_udev_rules.sh
-Plug RP-LIDAR into laptop with USB to serial converter
-Start node and viewer
roslaunch rplidar_ros view_rplidar_a3.launch

Test paramters and inputs (limits, tolerances, settings):
All defaults

Expected results:
Laser scan matching room

Security

Potential risks:
[ YES / NO ] Mechanical equipment damages (high speeds, sharp objects, projectiles)
[ YES / NO ] Electrical equipment damages (high power, reverse polarity, ESD, shorts)
[ YES / NO ] Thermal hazards (power dissipation, friction, heat-sensitive/flamable components)
[ YES / NO ] Chemicals (batteries, contaminants, exposition, airborne particles)
[ YES / NO ] New components (first tests, original/student designs)
[ YES / NO ] Human risks (operator proximity, ergonomics, environment, bystanders)
[ YES / NO ] Others: _______________________________
___________________________________________________
___________________________________________________

Risk mitigation:

Neutralization at the source: _____________________________
______N.A_____________________________________________

Collective protections: _________________________________
__________N.A_________________________________________

Personal protections: _________________________________
_________N.A_________________________________________

Approbation

Approved by: ______________________
Date: ________________________

Test Results

Tester | Time & date | Results | Comments
Cédric Godin | 14:51 2019-03-15 | Scan OK | Had to use patch from contributor to fix node

Comments

__________________________________________________
