introlab/securbot/test/template_test_SEC-XXX.rtf

Info

Test designer: __________________________________
Creation date: ____/____/____
ID Jira: SEC-___
Test Title: ____________________________

Test description

Test objectives and goals: ______________________________
___________________________________________________

Sub-system(s): _______________________________________
___________________________________________________

Component(s) (devices and test equipment):________________
___________________________________________________

Environment (location, conditions): ________________________
___________________________________________________

Test Procedure (include files and illustrations):
1.
2.
3.

Test paramters and inputs (limits, tolerances, settings): _______
___________________________________________________

Expected results: ___________________________________
___________________________________________________

Security

Potential risks:
[ YES / NO ] Mechanical equipment damages (high speeds, sharp objects, projectiles)
[ YES / NO ] Electrical equipment damages (high power, reverse polarity, ESD, shorts)
[ YES / NO ] Thermal hazards (power dissipation, friction, heat-sensitive/flamable components)
[ YES / NO ] Chemicals (batteries, contaminants, exposition, airborne particles)
[ YES / NO ] New components (first tests, original/student designs)
[ YES / NO ] Human risks (operator proximity, ergonomics, environment, bystanders)
[ YES / NO ] Others: _______________________________
___________________________________________________
___________________________________________________

Risk mitigation:

Neutralization at the source: _____________________________
___________________________________________________

Collective protections: _________________________________
___________________________________________________

Personal protections: _________________________________
__________________________________________________

Approbation

Approved by: ______________________
Date: ________________________

Test Results

Tester | Time & date | Results | Comments

Comments

__________________________________________________
