introlab/securbot/ros_pkg/securbot_pkg/launch/includes/OccupancyGridValidator.xlsx

RTAB-MAP
width | height | res | x_origin | y_origin
421 | 421 | 0.05 | -10.525 | -10.525
Launch
width | height | res | x_origin | y_origin
40 | 25 | 25 | 500 | 500
 |  |  | Ne modifier que les cases en bleu, les grises sont calculées automatiques. Les cases en jaune peuvent être modifiées, mais prendre les valeurs dans rviz, ces valeurs ne peuvent pas être modifier par nous...
Var | Value
rowOffset | 236.875
colOffset | 236.875
imageRows | 1000
imageCols | 1000
Scaled Rows | 526.25
Scaled Cols | 526.25
Too Small? | Fine
