introlab/securbot/hardware/02 - Battery Board/01 - SCHÉMAS ET PCB/01 - 00001 REVISION/01 - PROJECT/Debug/Second Tests/SDS00002.jpg

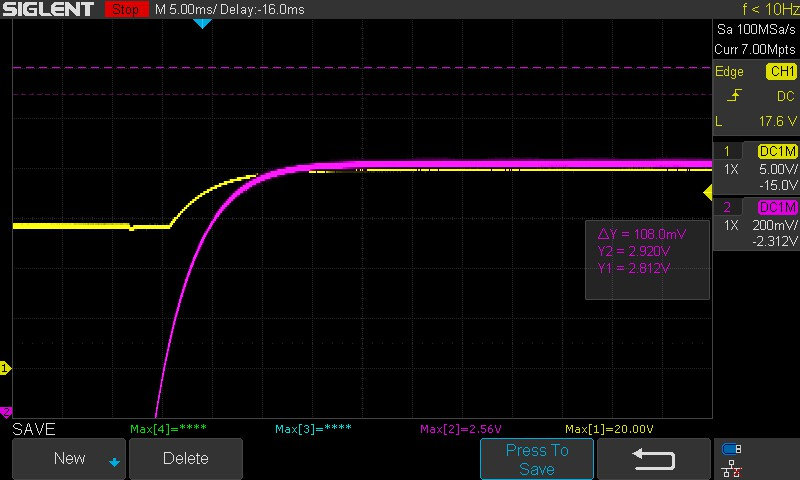
hardware/02 - Battery Board/01 - SCHÉMAS ET PCB/01 - 00001 REVISION/01 - PROJECT/Debug/Second Tests/SDS00002.jpg
