introlab/securbot/hardware/02 - Battery Board/01 - SCHÉMAS ET PCB/01 - 00001 REVISION/01 - PROJECT/Debug/SDS00002.png

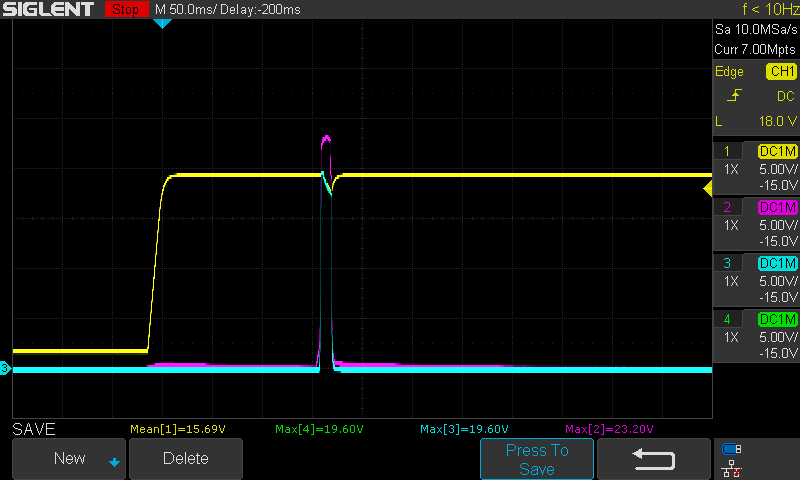
hardware/02 - Battery Board/01 - SCHÉMAS ET PCB/01 - 00001 REVISION/01 - PROJECT/Debug/SDS00002.png
