introlab/securbot/(threads)

Thread 64 (2020-01-16):

Generate PointCloud with RTAB-Map instead of Realsense SDK

GodCed, 2020-01-16:
**ToDo** to improve obstacle detection under of over LIDAR line of sight (such as office chair legs).

Modify SecurBot bringup to generate the pointcloud with RTAB-Map (in `launch/includes/rtabmap_bringup`) instead of the RealSense SDK filter (in `launch/includes/sensors/realsense`) and tune to get good performance and lower CPU.

Enable back pointcloud observation source in costmap_common_config.yaml.

[RTAB-Map pointcloud XYZ](http://wiki.ros.org/rtabmap_ros#rtabmap_ros.2BAC8-point_cloud_xyz)
[RTAB-Map obstacle detection](http://wiki.ros.org/rtabmap_ros#rtabmap_ros.2BAC8-obstacles_detection)
