introlab/securbot/hardware/02 - Battery Board/01 - SCHÉMAS ET PCB/01 - 00001 REVISION/02 - OUTPUT/BatteryBoard.pdf

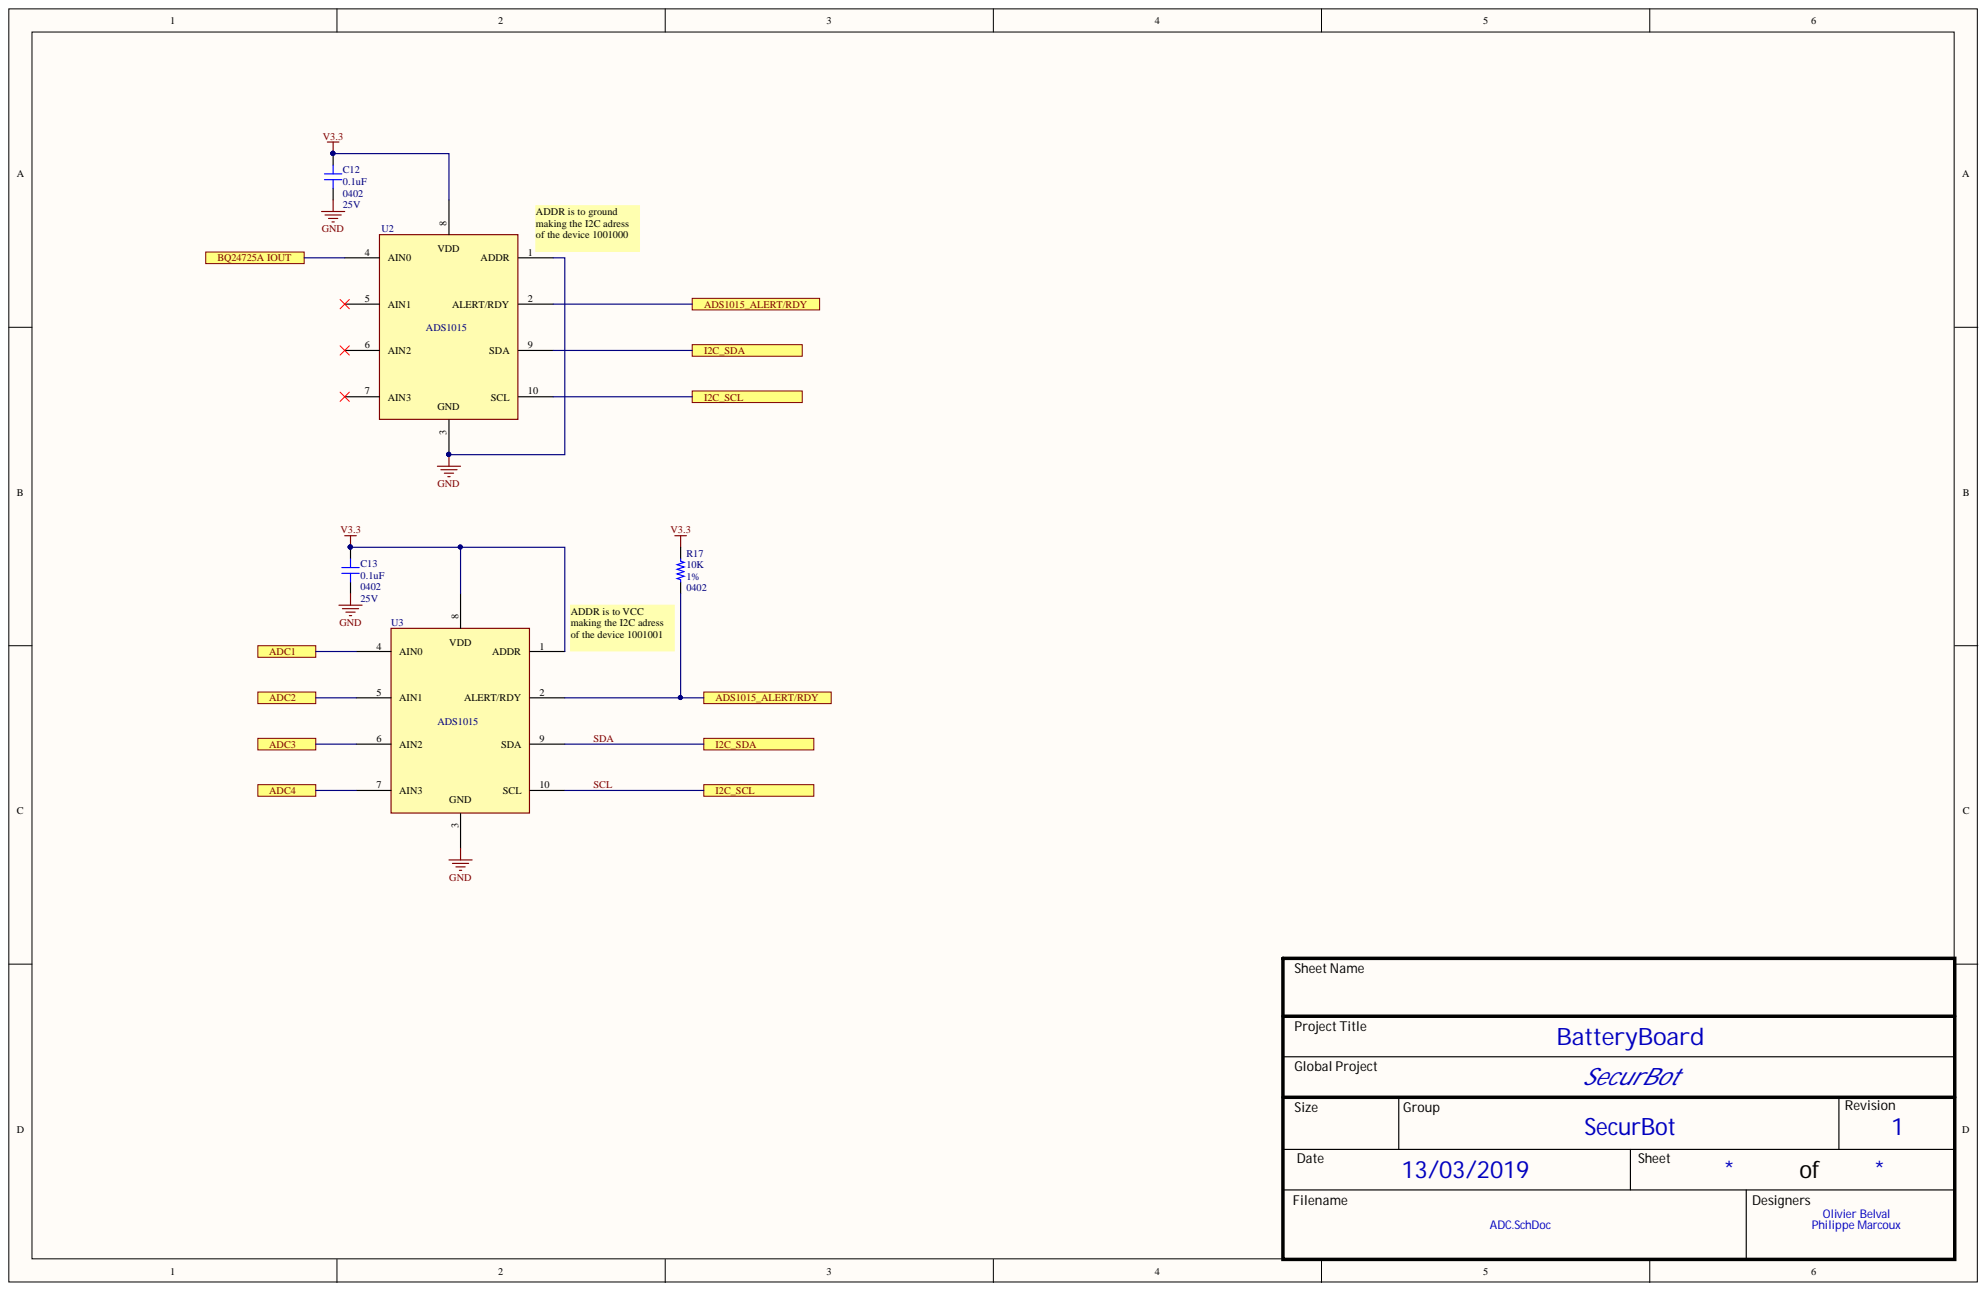
[picture p111: page 1]

ADDR is to ground
making the I2C adress
of the device 1001000

ADDR is to VCC
of the device 1001001

VDD AIN0 4 ADS1015

AIN1 5 GND

ADC2 | AIN2 6 | ADS1015_ALERT/RDY

Size | Group SecurBot | Revision 1

Date 13/03/2019 | Sheet * of *

Filename ADC.SchDoc | Designers Olivier Belval Philippe Marcoux

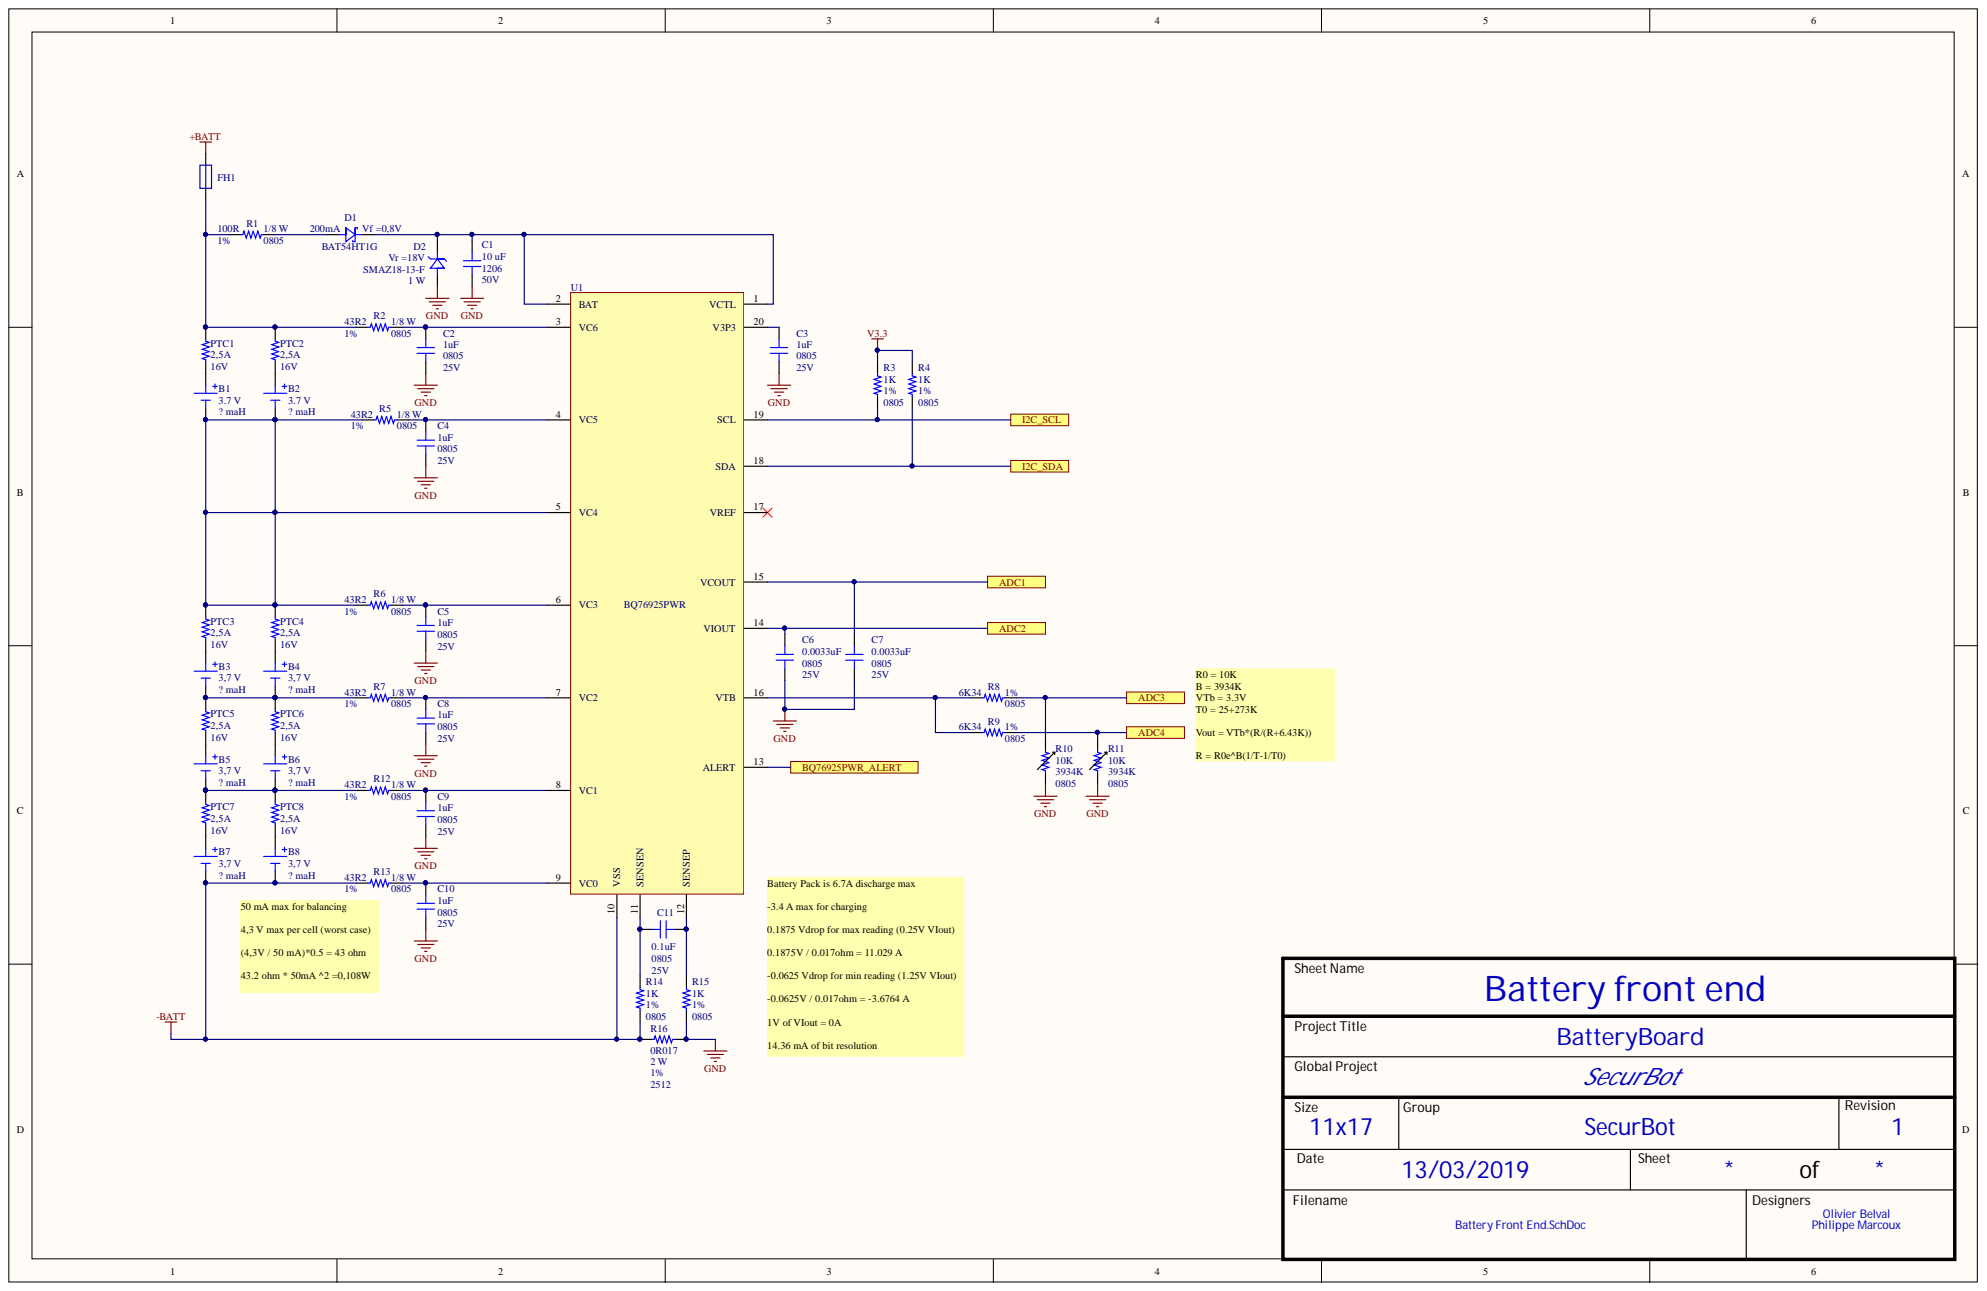
[picture p112: page 2]

Battery Pack is 6.7A discharge max

50 mA max for balancing 4,3 V max per cell (worst case) (4,3V / 50 mA)*0.5 = 43 ohm 43.2 ohm * 50mA ^2 =0,108W

0.1875 Vdrop for max reading (0.25V VIout)

-0.0625 Vdrop for min reading (1.25V VIout)

14.36 mA of bit resolution

Size 11x17 | Group SecurBot | Revision 1

Date 13/03/2019 | Sheet * of *

Filename Battery Front End.SchDoc | Designers Olivier Belval Philippe Marcoux

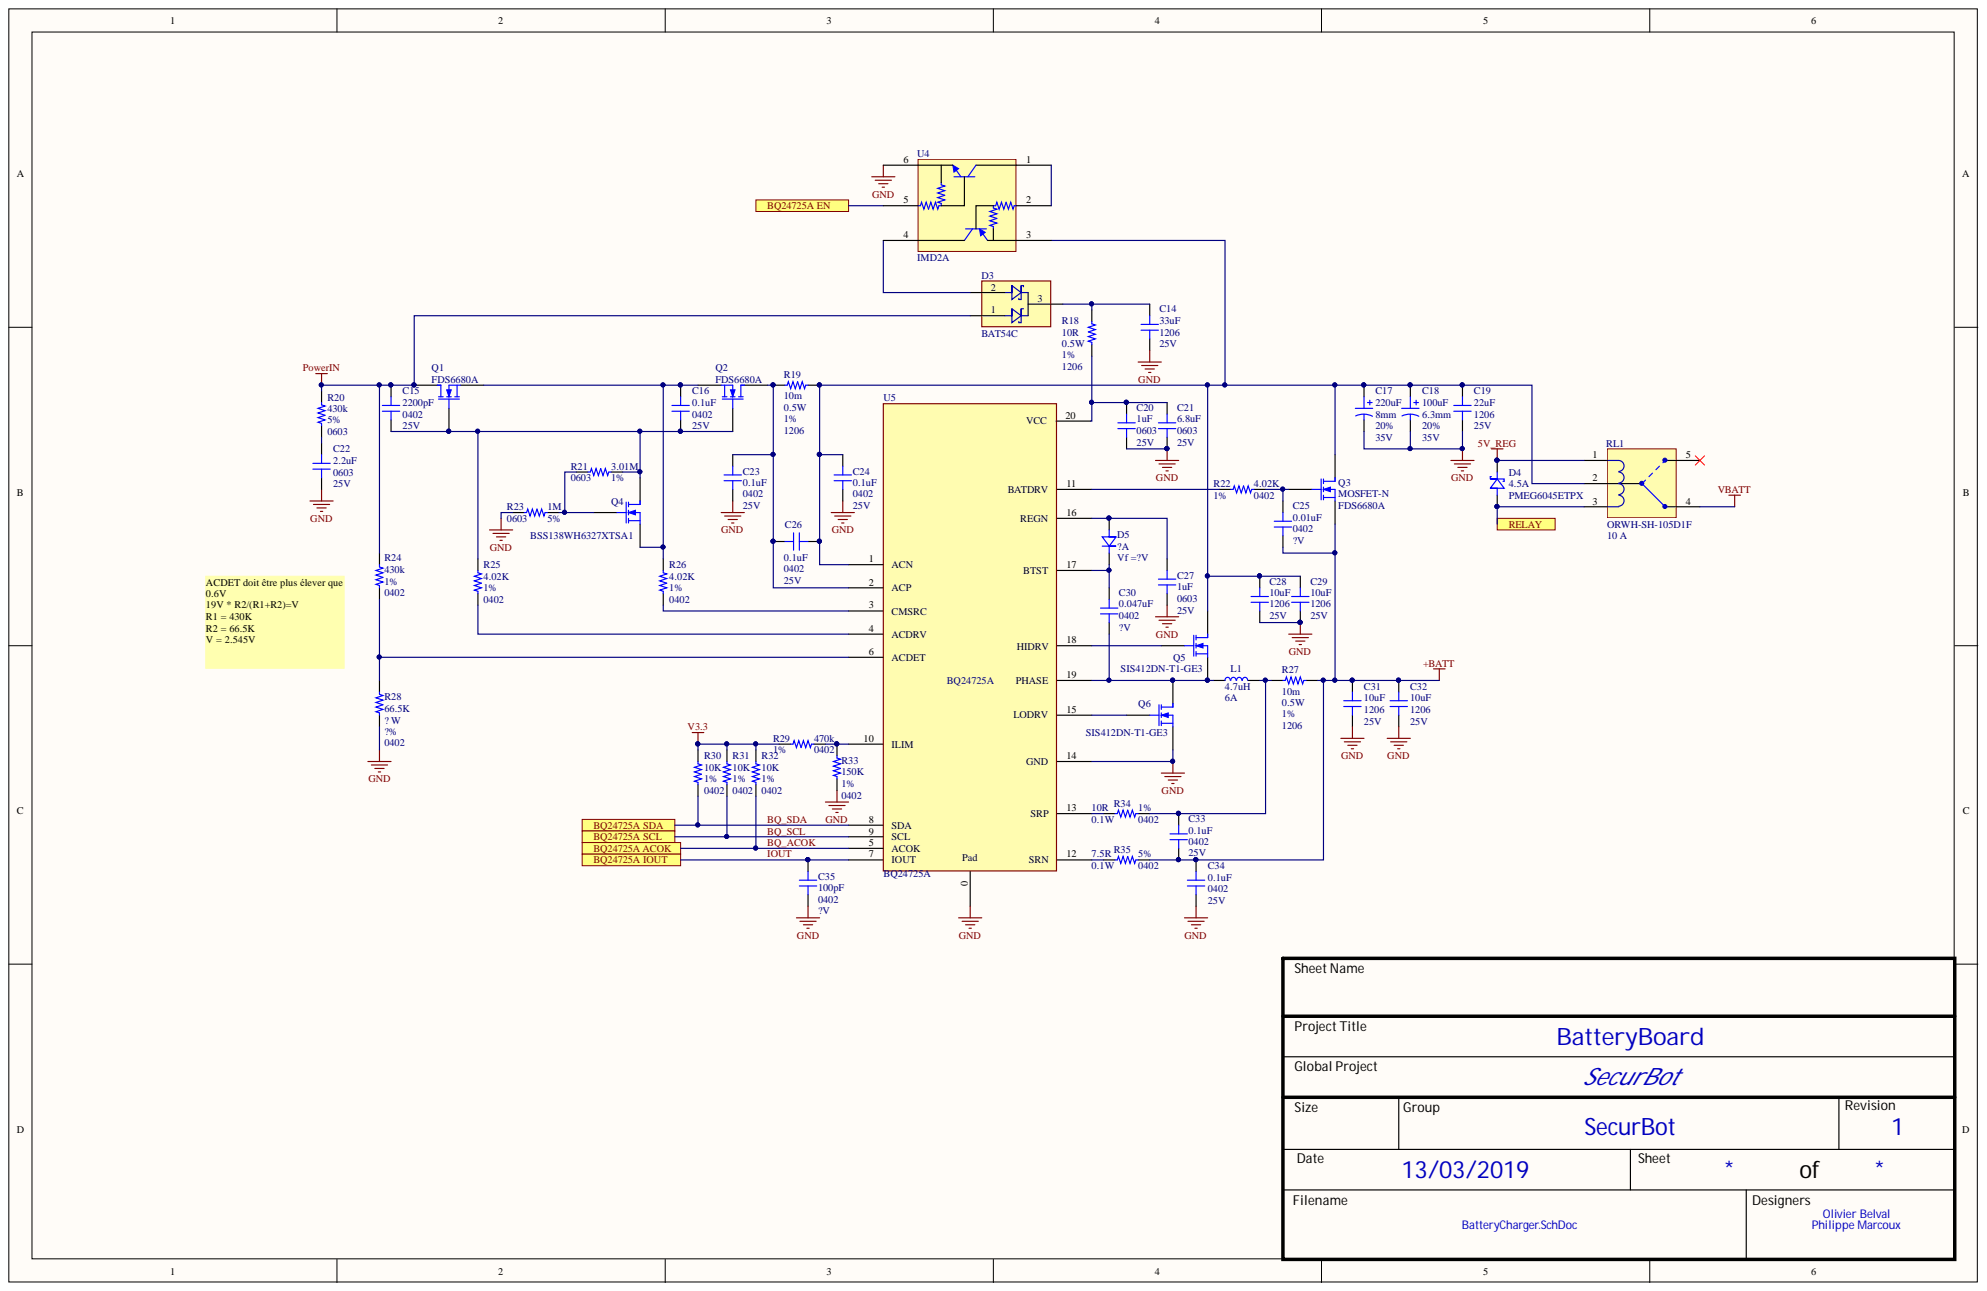
[picture p113: page 3]

ILIM 10

BQ24725A SCL | | | BQ_SCL | SCL 9
BQ24725A ACOK | | | BQ_ACOK | ACOK 5
BQ24725A IOUT | IOUT | | | IOUT 7

Size | Group SecurBot | Revision 1

Date 13/03/2019 | Sheet * of *

Filename BatteryCharger.SchDoc | Designers Olivier Belval Philippe Marcoux

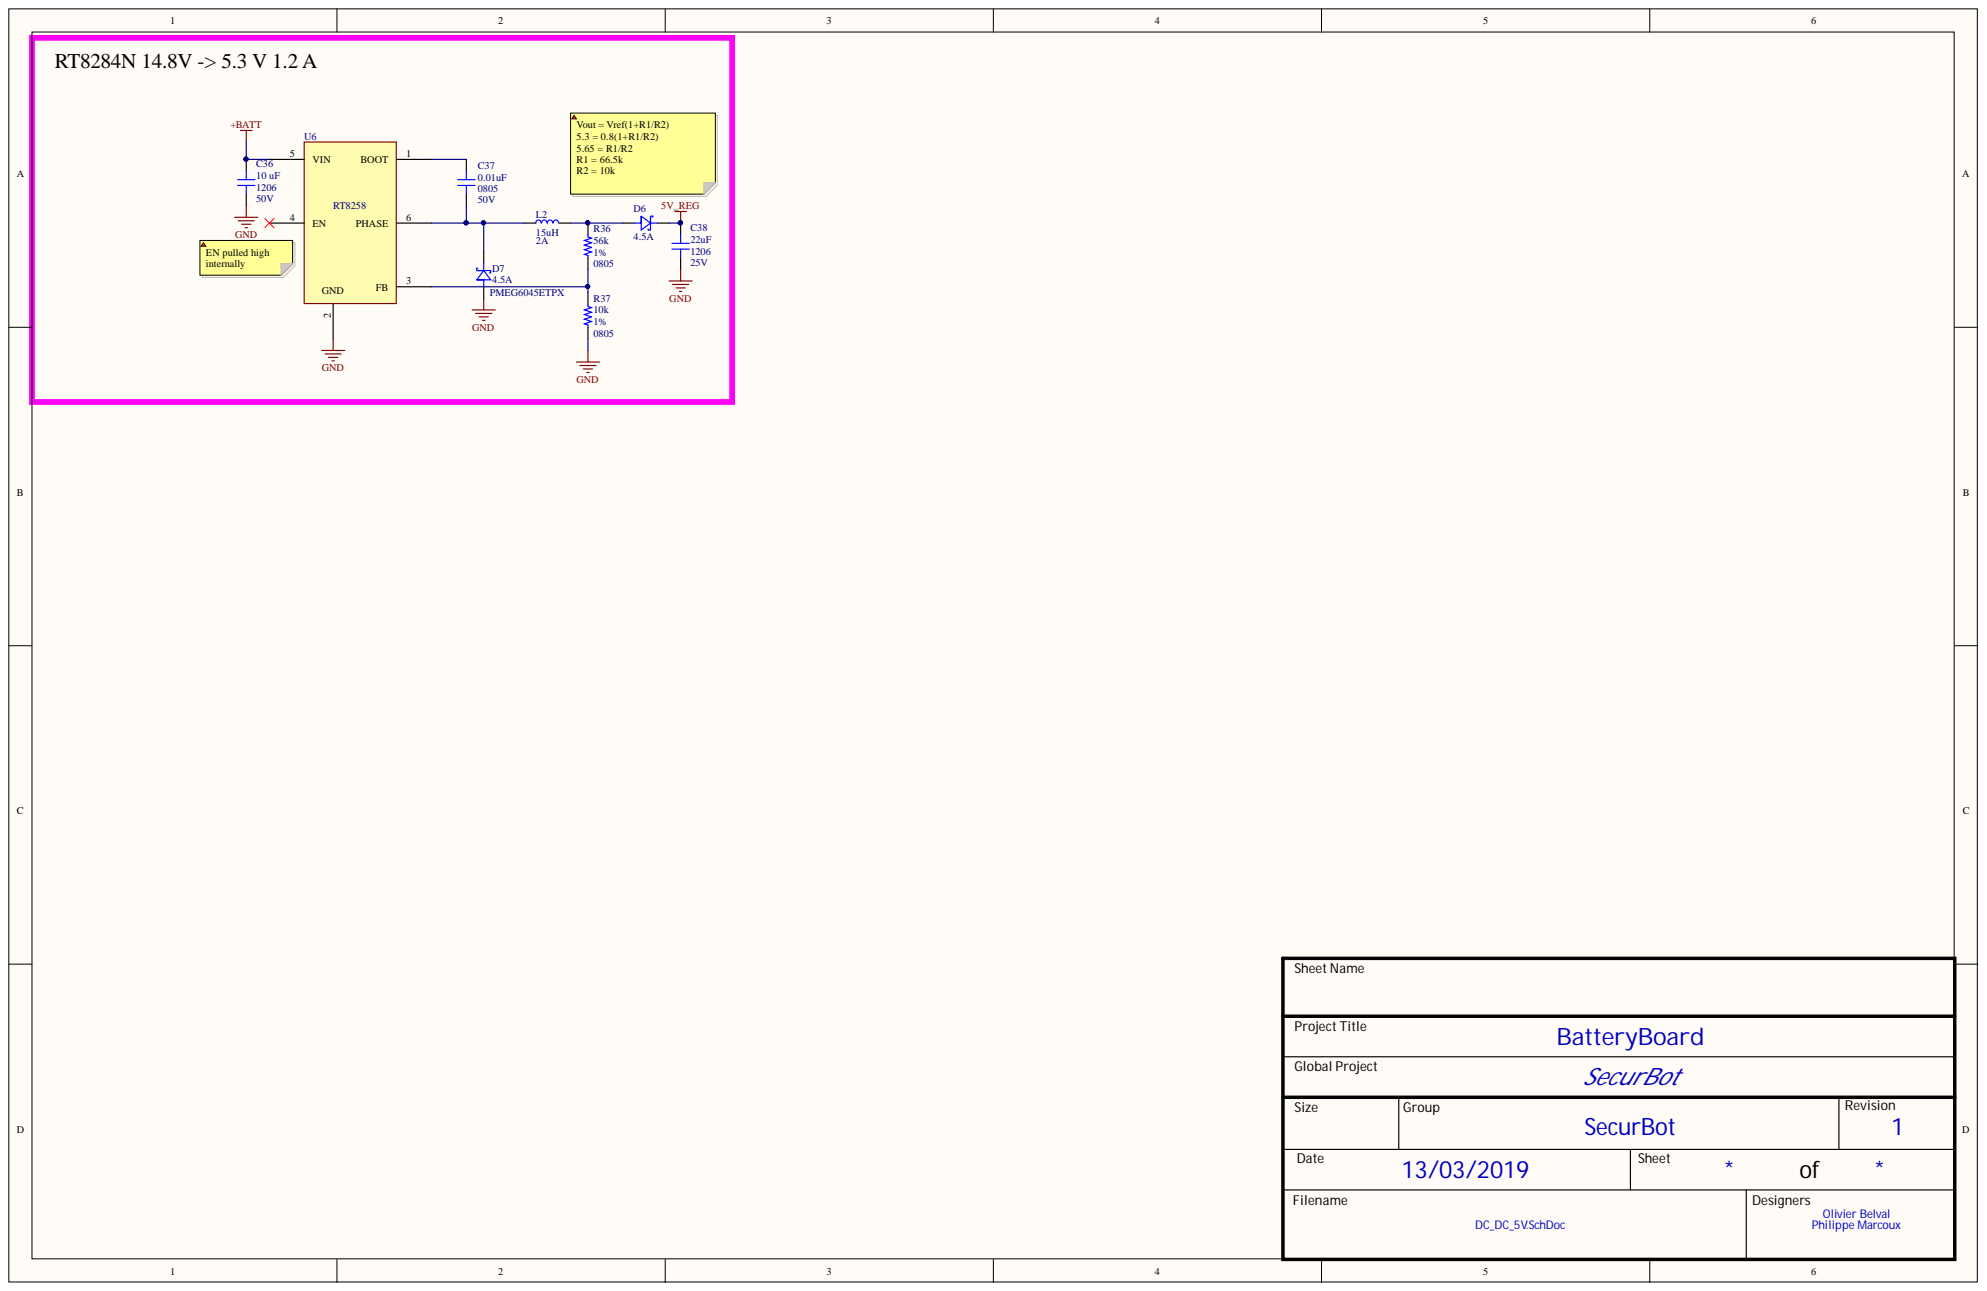
[picture p114: page 4]

Size | Group SecurBot | Revision 1

Date 13/03/2019 | Sheet * of *

Filename DC_DC_5V.SchDoc | Designers Olivier Belval Philippe Marcoux

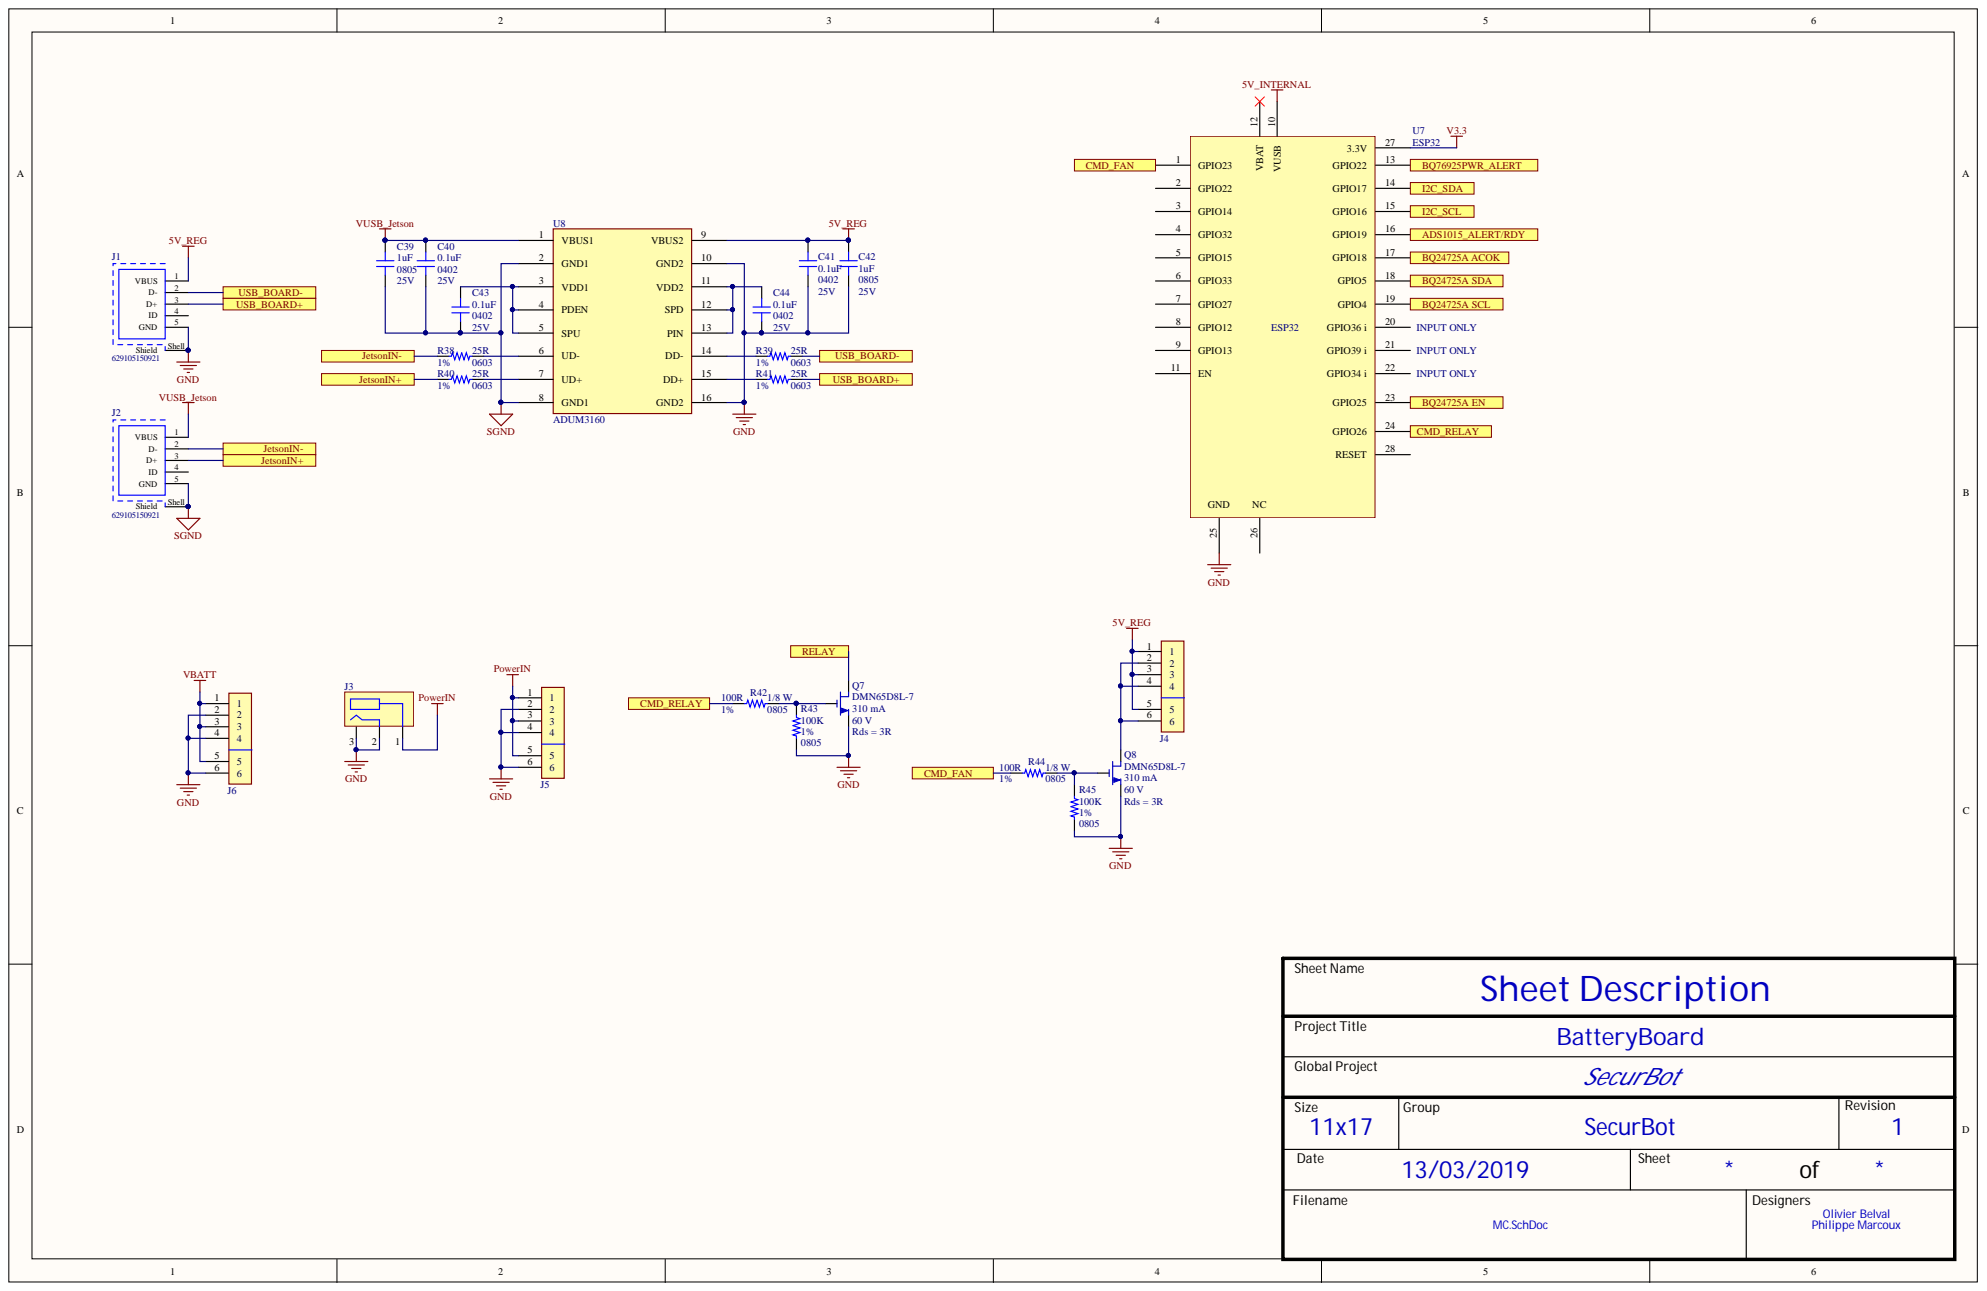
[picture p115: page 5]

CMD_FAN | GPIO22 2 | BQ76925PWR_ALERT

GPIO33 6 | BQ24725A ACOK

Size 11x17 | Group SecurBot | Revision 1

Date 13/03/2019 | Sheet * of *

Filename MC.SchDoc | Designers Olivier Belval Philippe Marcoux

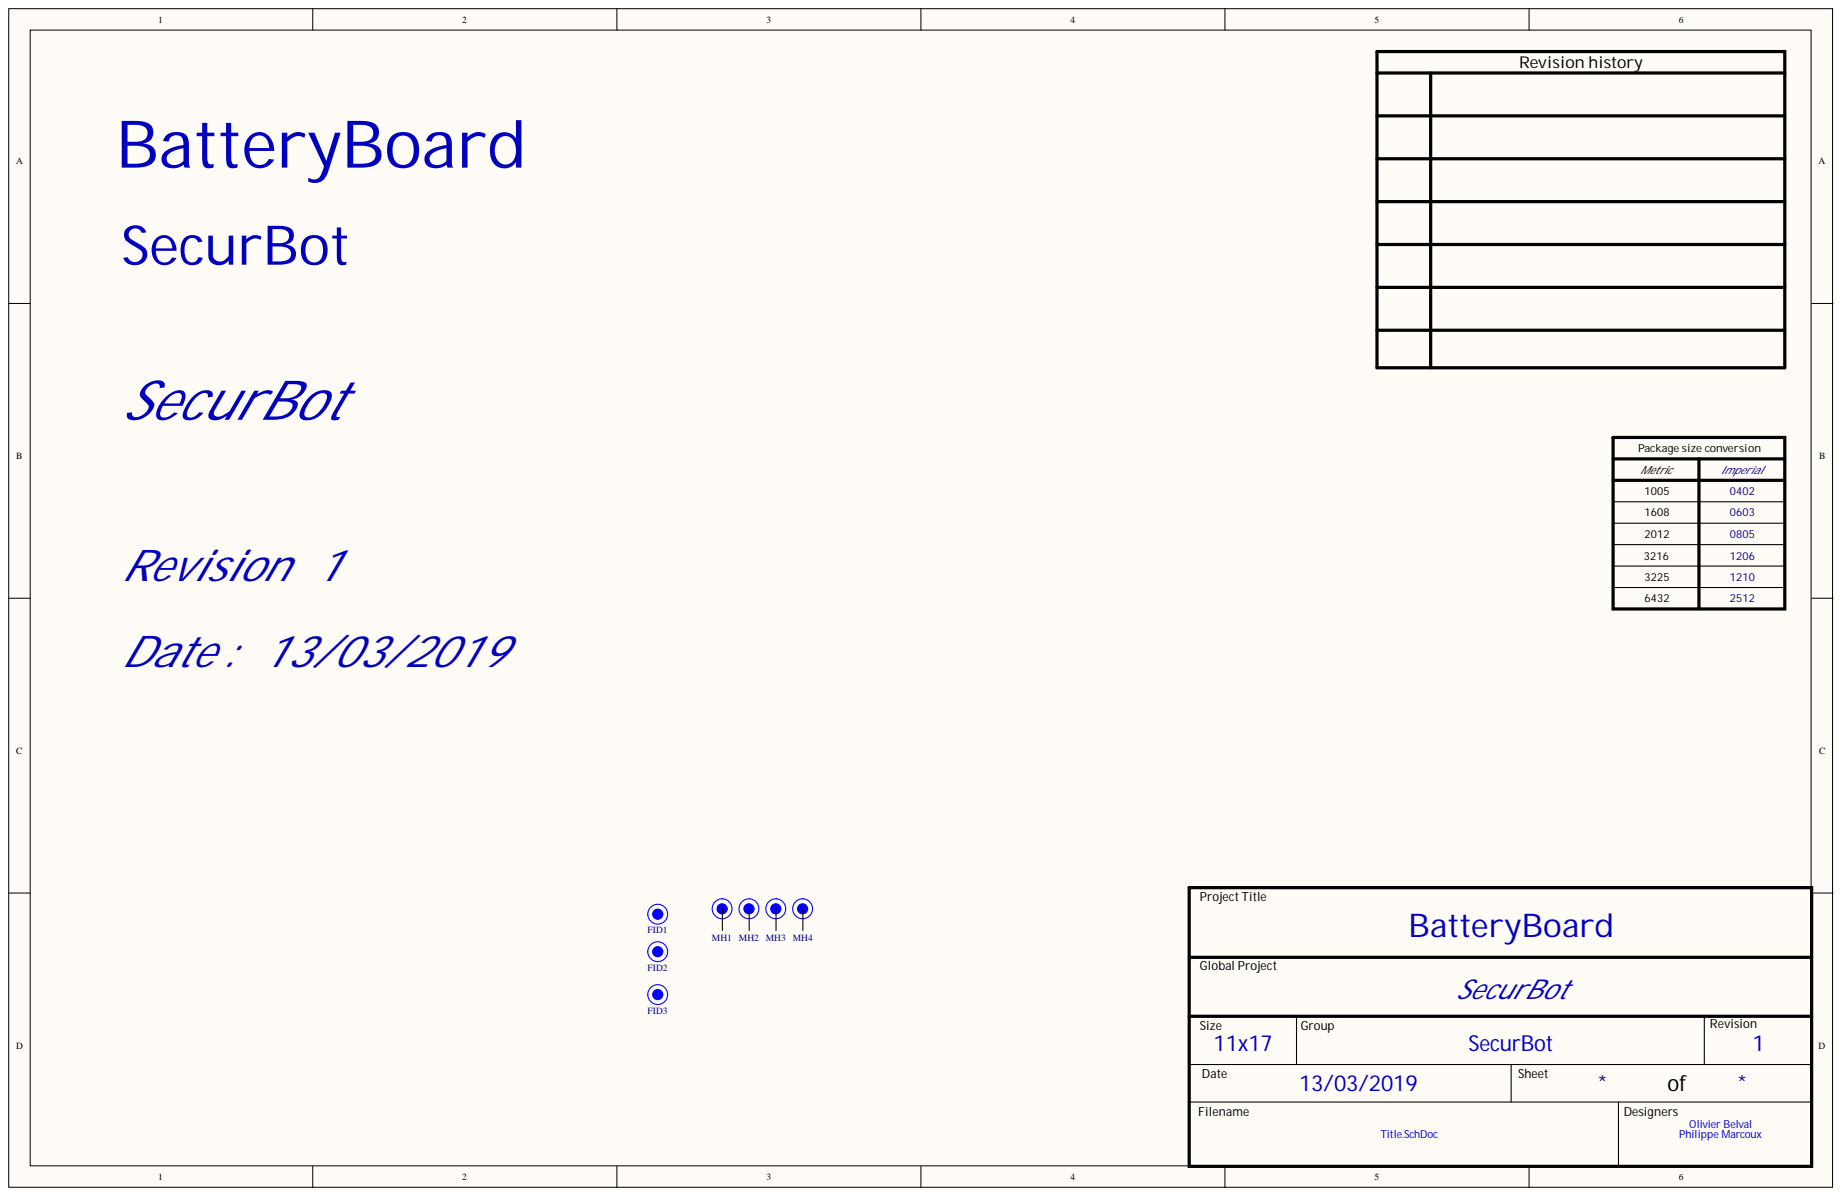
[picture p116: page 6]

Metric | Imperial

Size 11x17 | Group SecurBot | Revision 1

Date 13/03/2019 | Sheet * of *

Filename Title.SchDoc | Designers Olivier Belval Philippe Marcoux
