introlab/securbot/hardware/96 - Mechanical/RobotBases/Cutouts_robotBase/Pioneer/Cutout_Pioneer_1.pdf

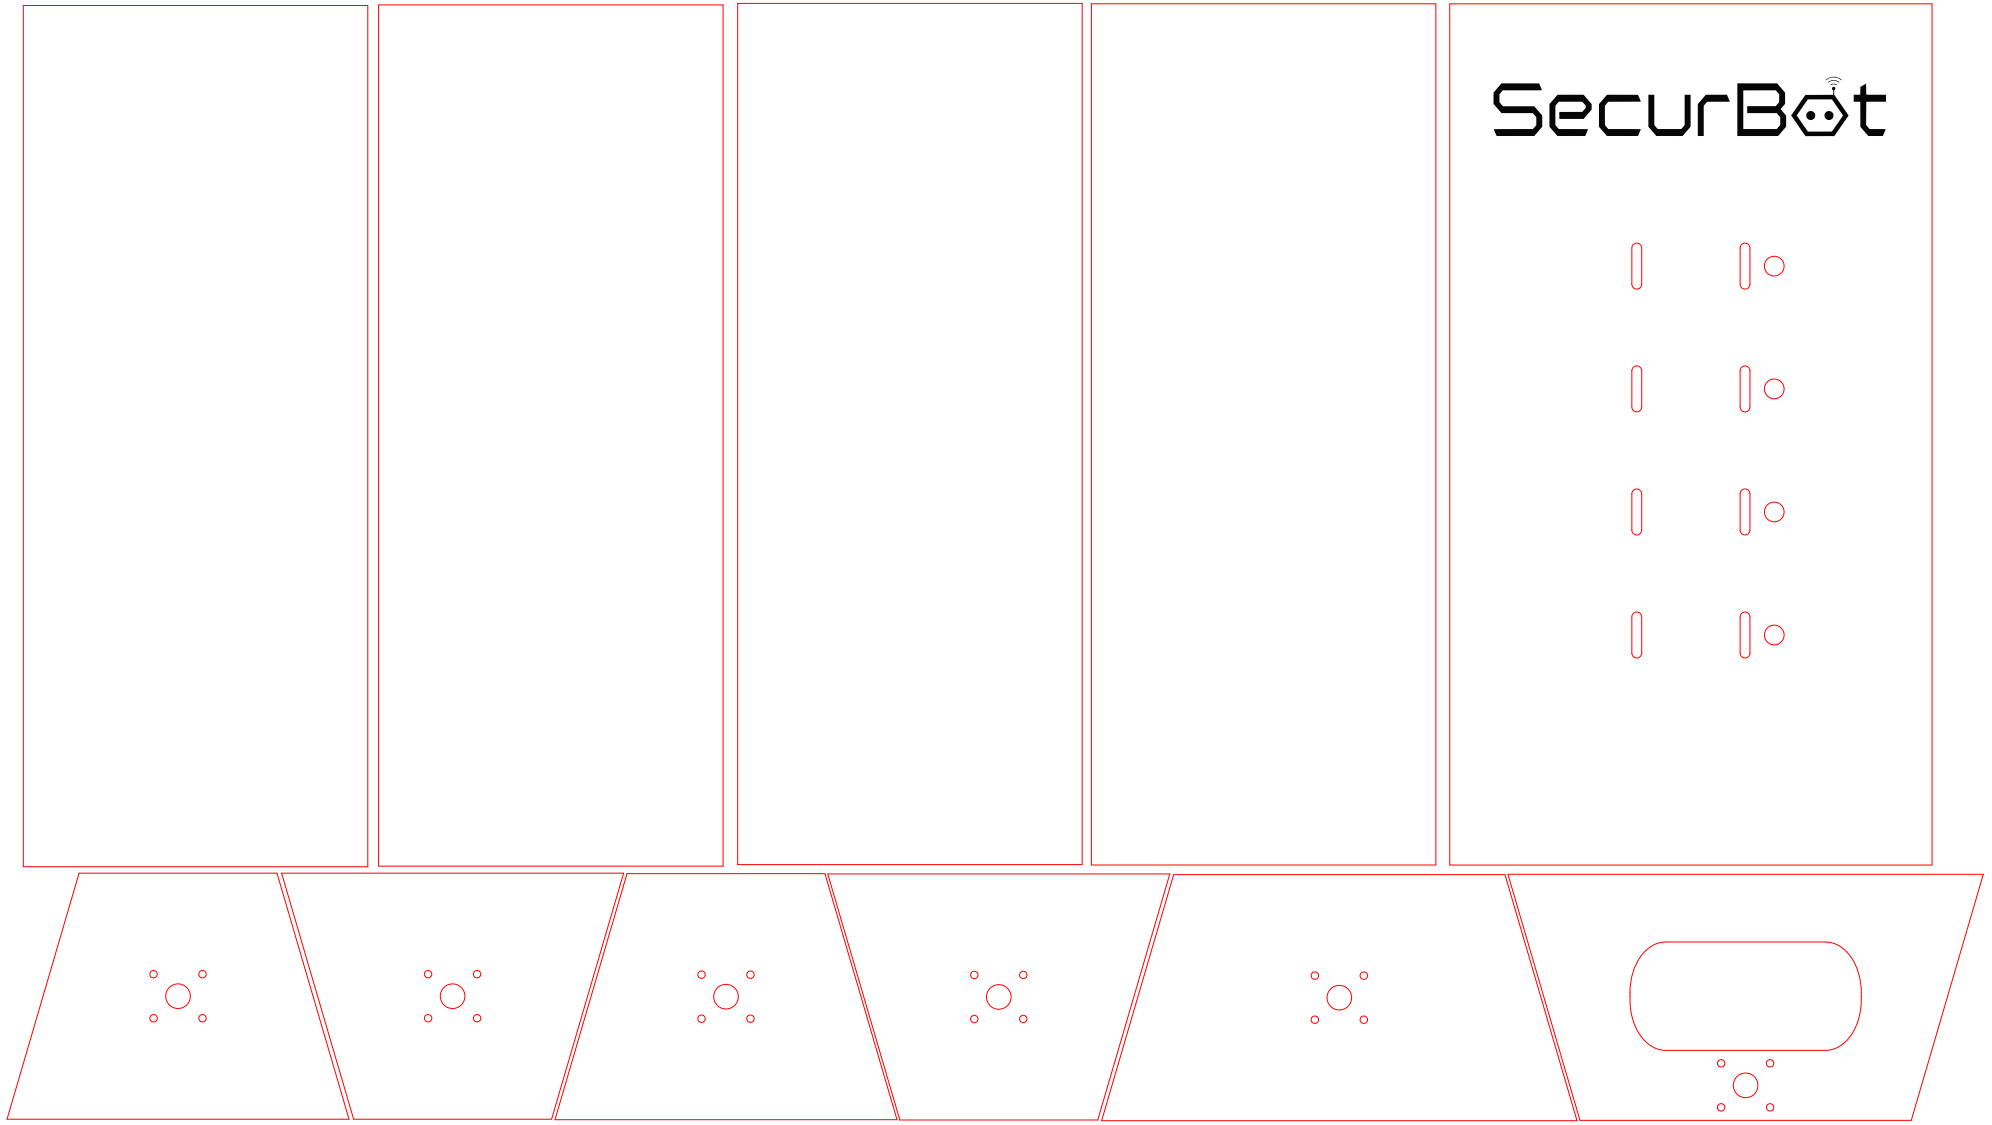
[picture p117: page 1]
