introlab/securbot/hardware/96 - Mechanical/RobotBases/Cutouts_robotBase/Pioneer/Cutout_Pioneer_2.pdf

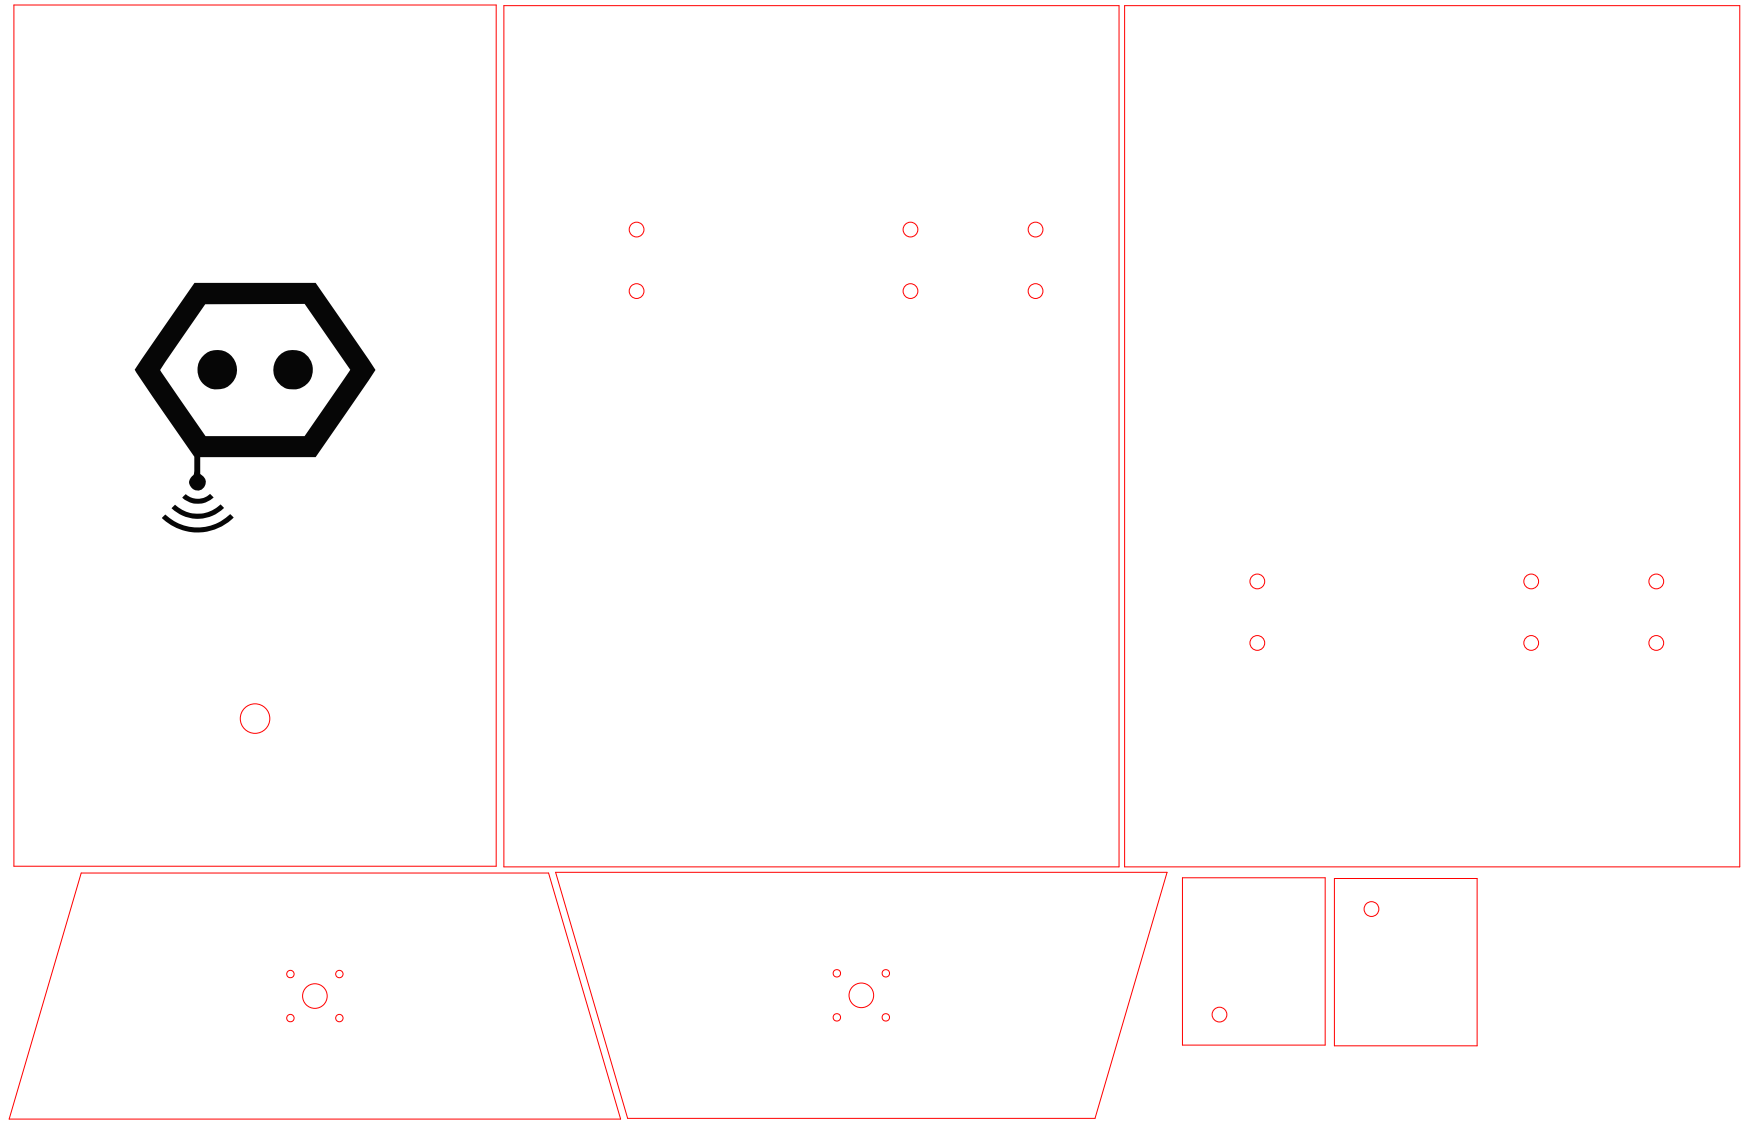
[picture p118: page 1]
