introlab/securbot/hardware/96 - Mechanical/RobotBases/Cutouts_robotBase/TurtleBot/Cutout_Turtle_1.pdf

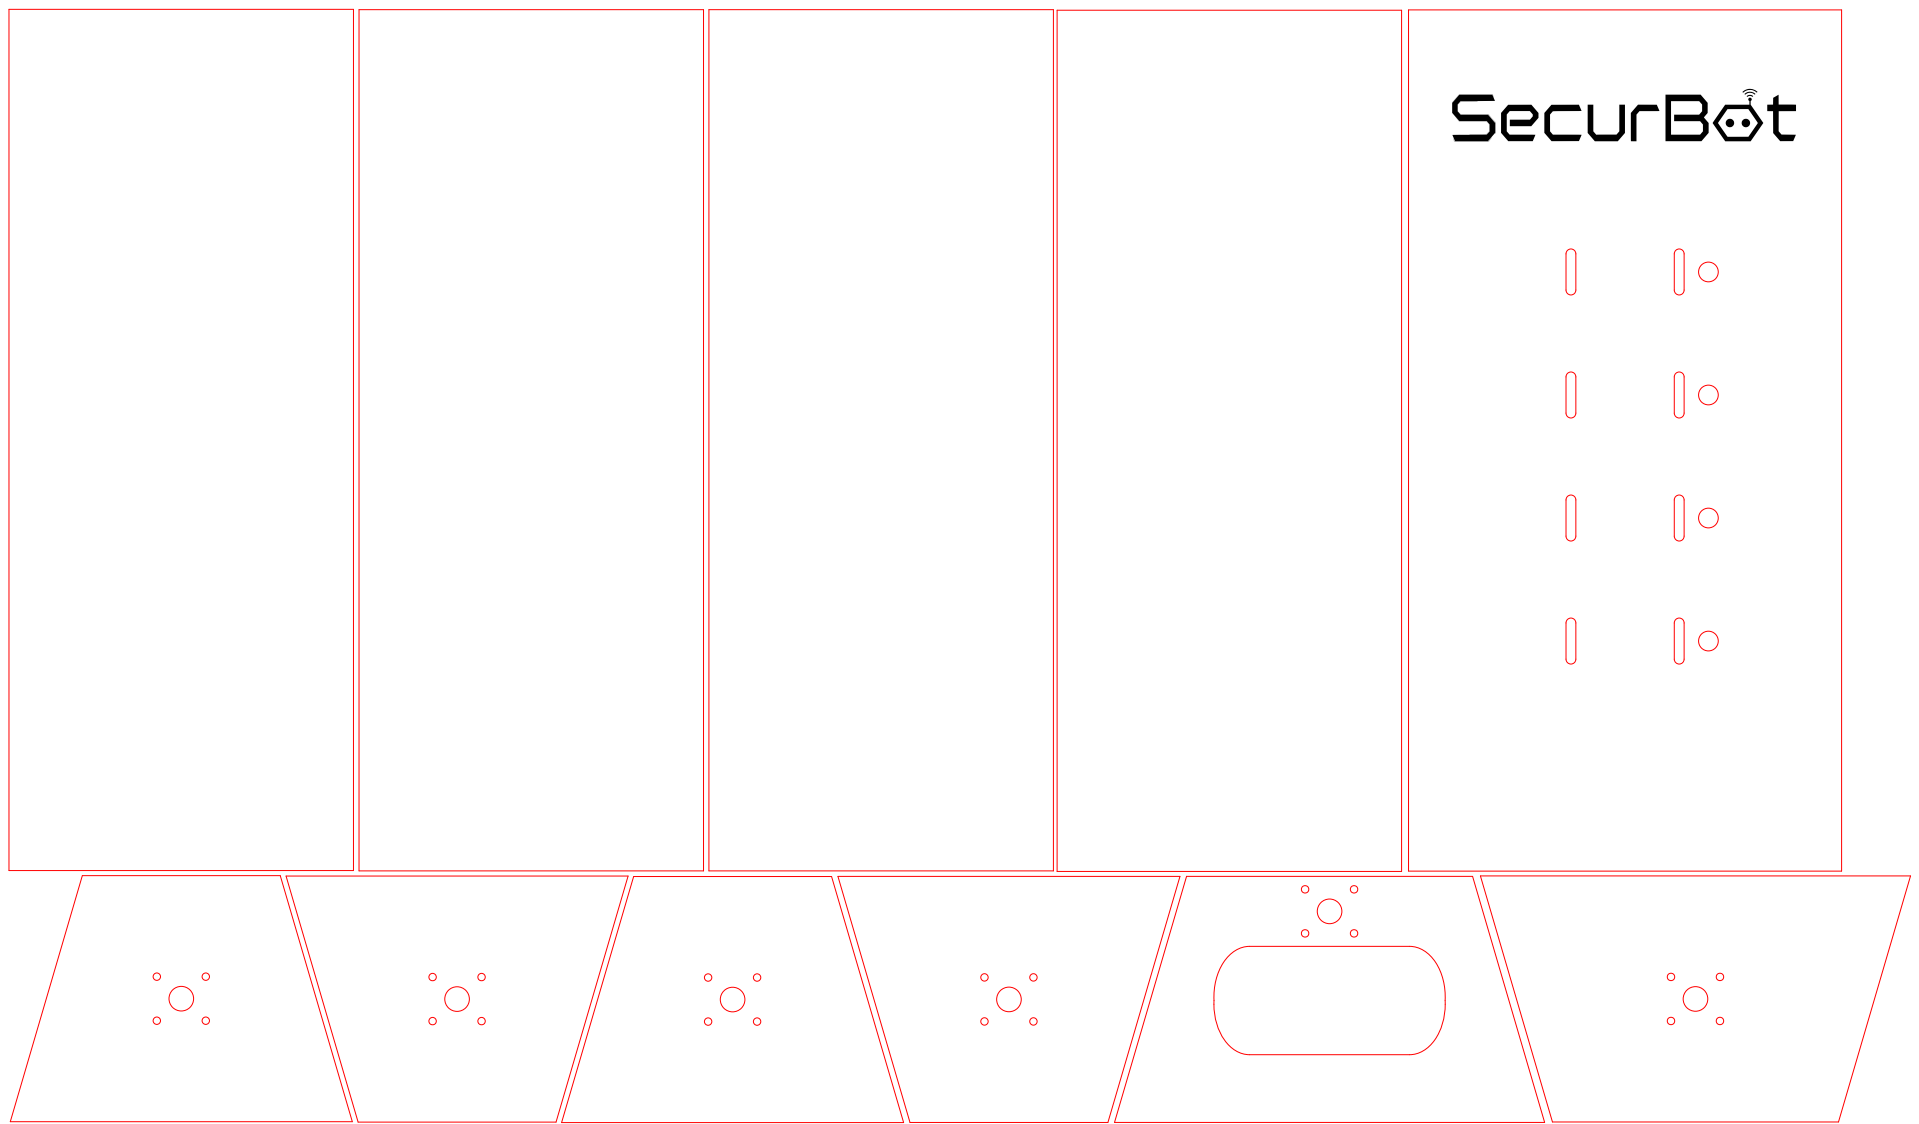
[picture p120: page 1]
