introlab/securbot/hardware/96 - Mechanical/RobotBases/Cutouts_robotBase/TurtleBot/Cutout_Turtle_2.pdf

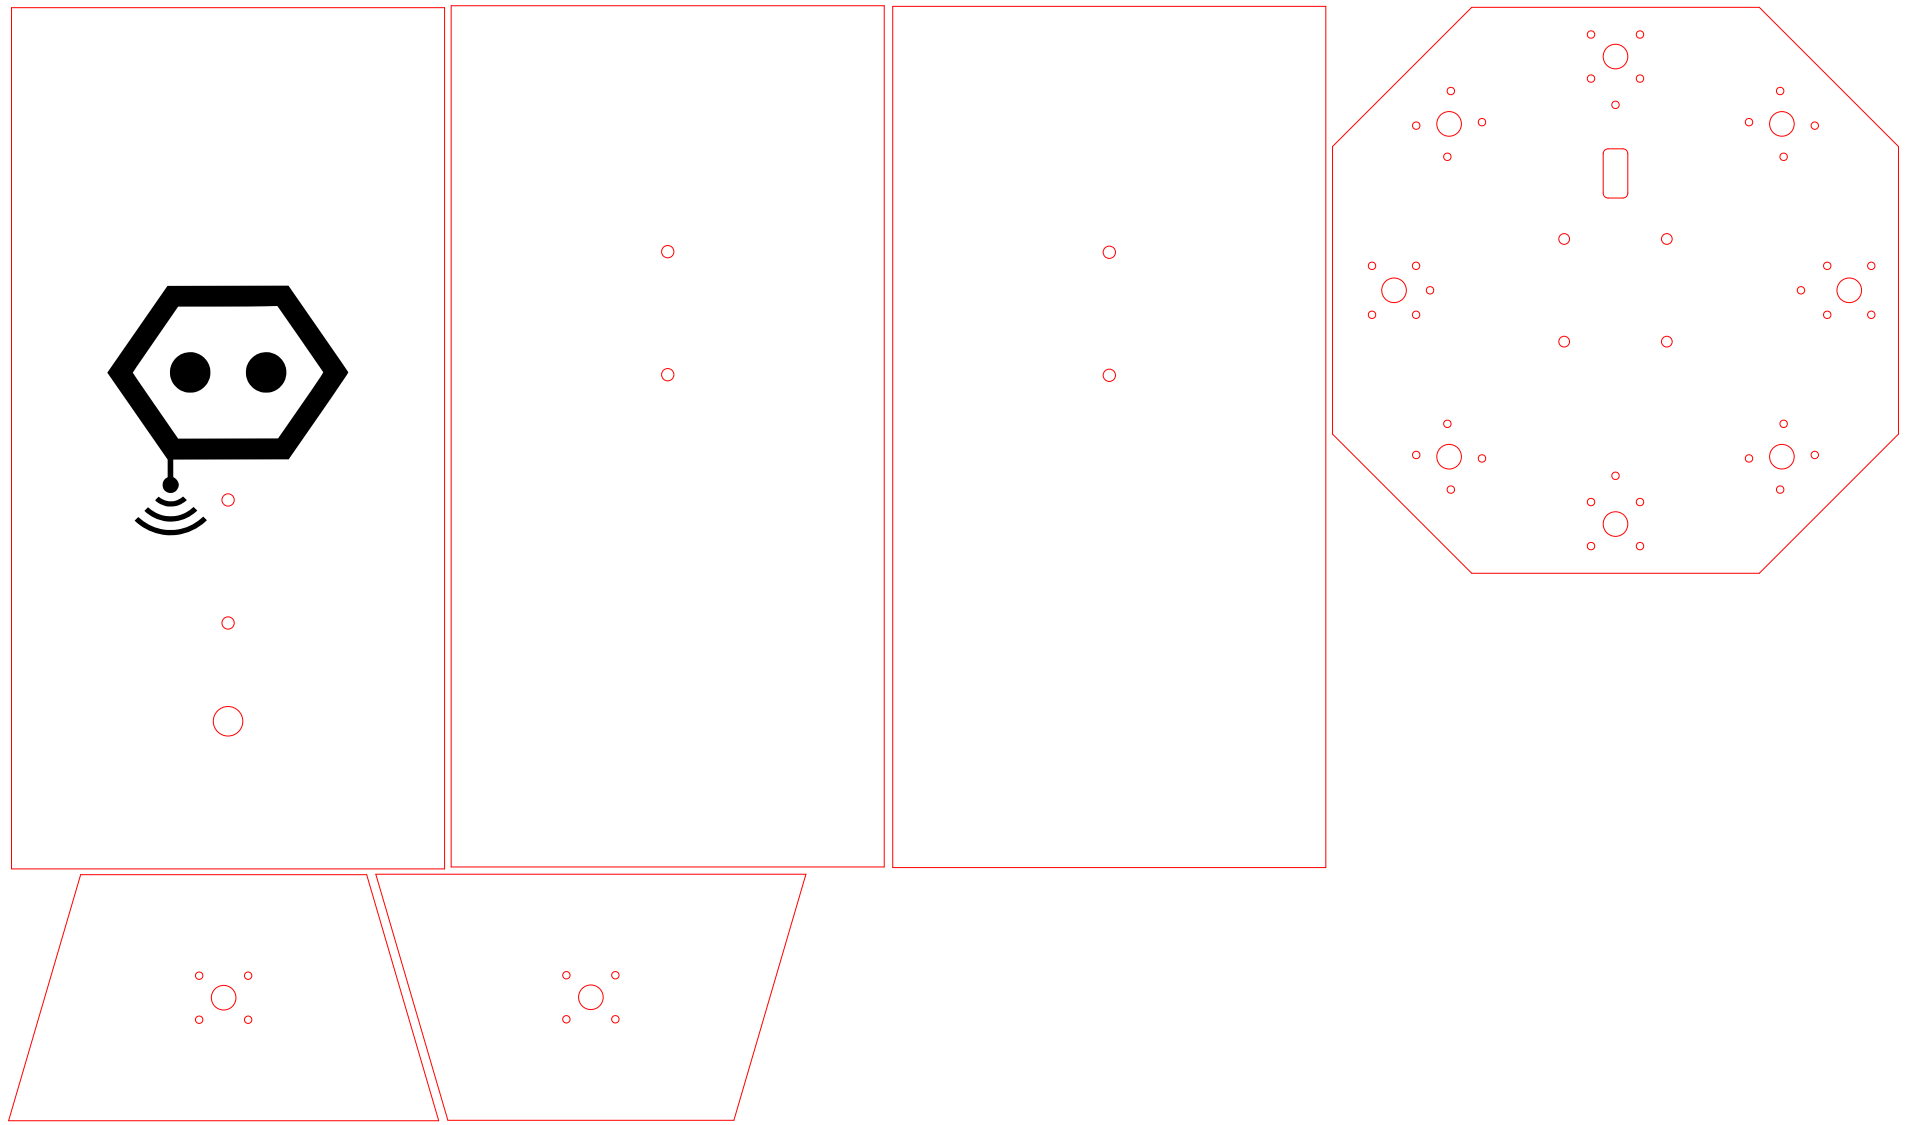
[picture p121: page 1]
