introlab/securbot/hardware/01 - PowerTree/01 - SCHEMAS ET PCB/01 - REVISION 1_000/02 - PDF/PowerTree.pdf

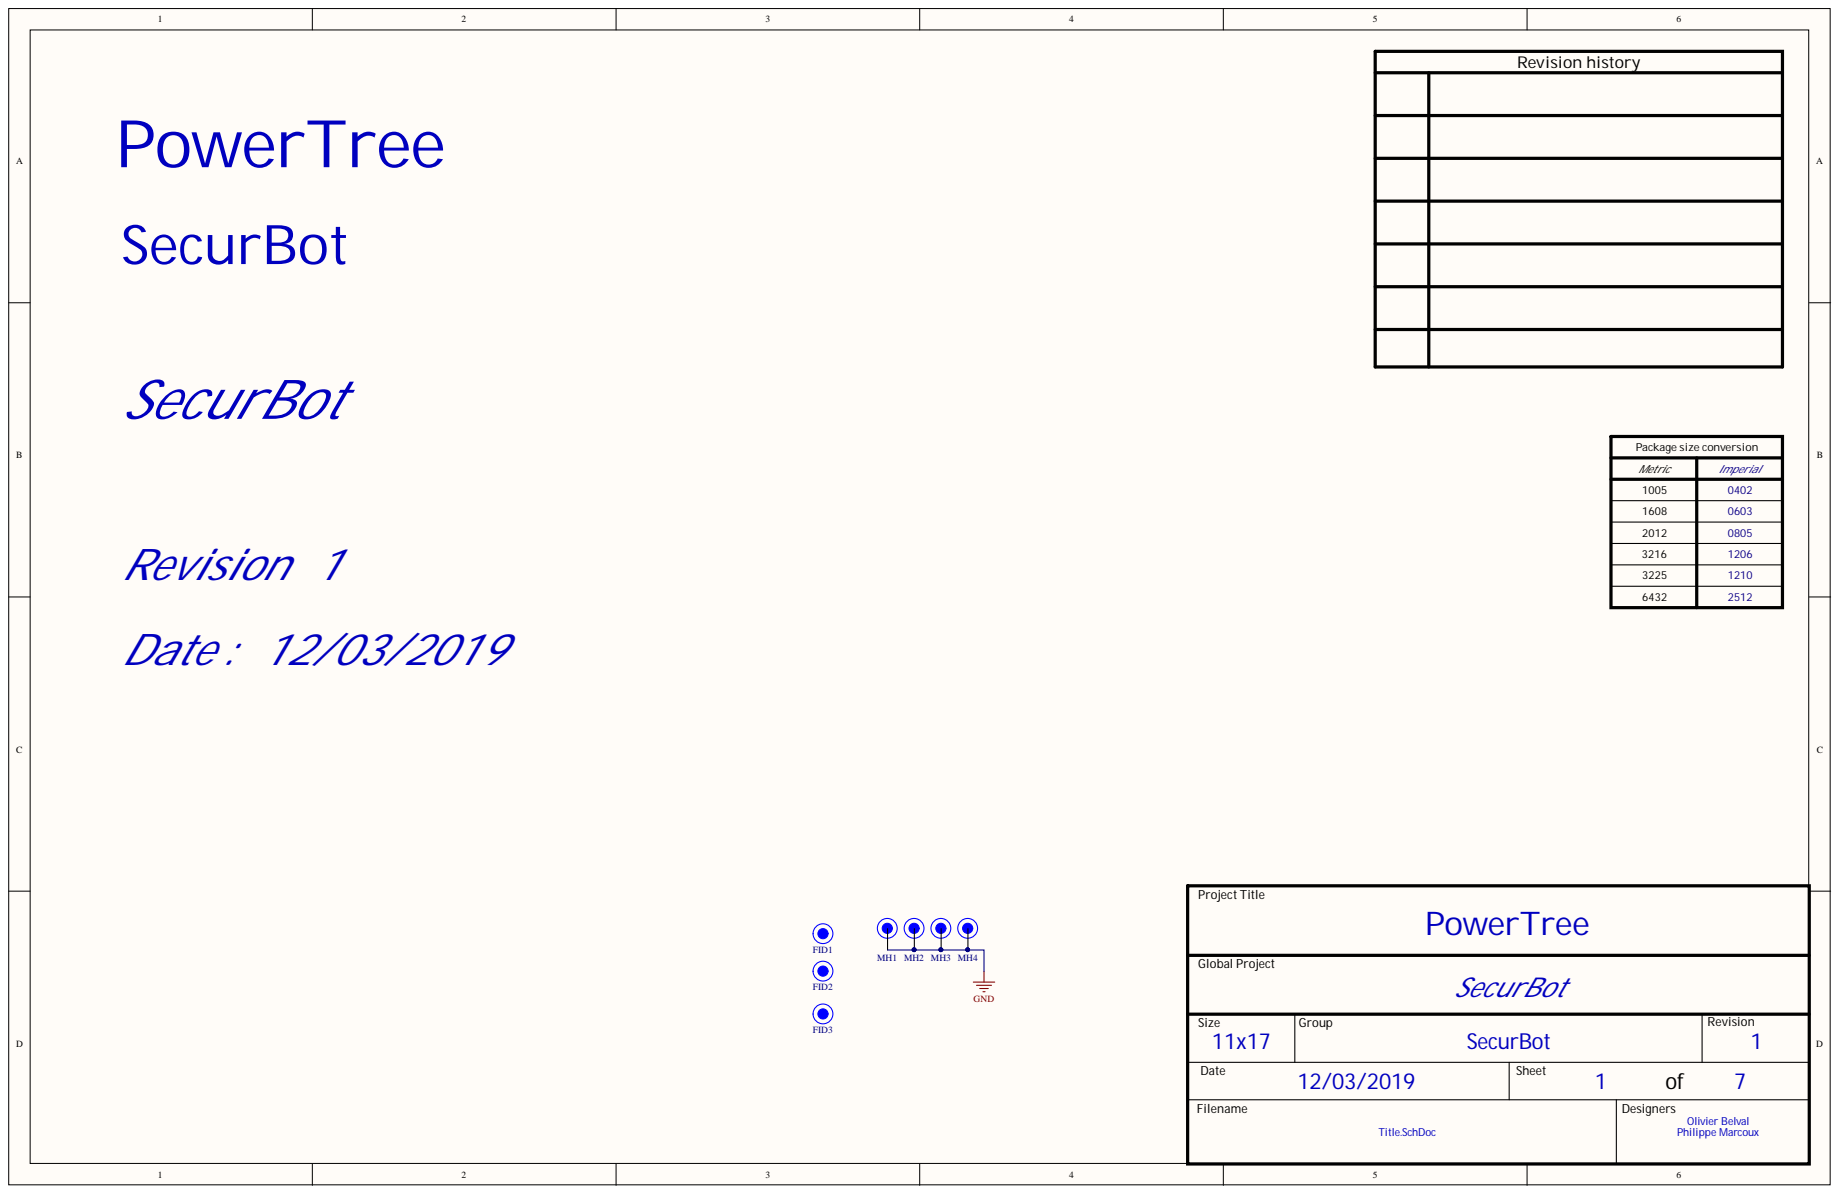
[picture p122: page 1]

Metric | Imperial

Size 11x17 | Group SecurBot | Revision 1

Date 12/03/2019 | Sheet 1 of 7

Filename Title.SchDoc | Designers Olivier Belval Philippe Marcoux

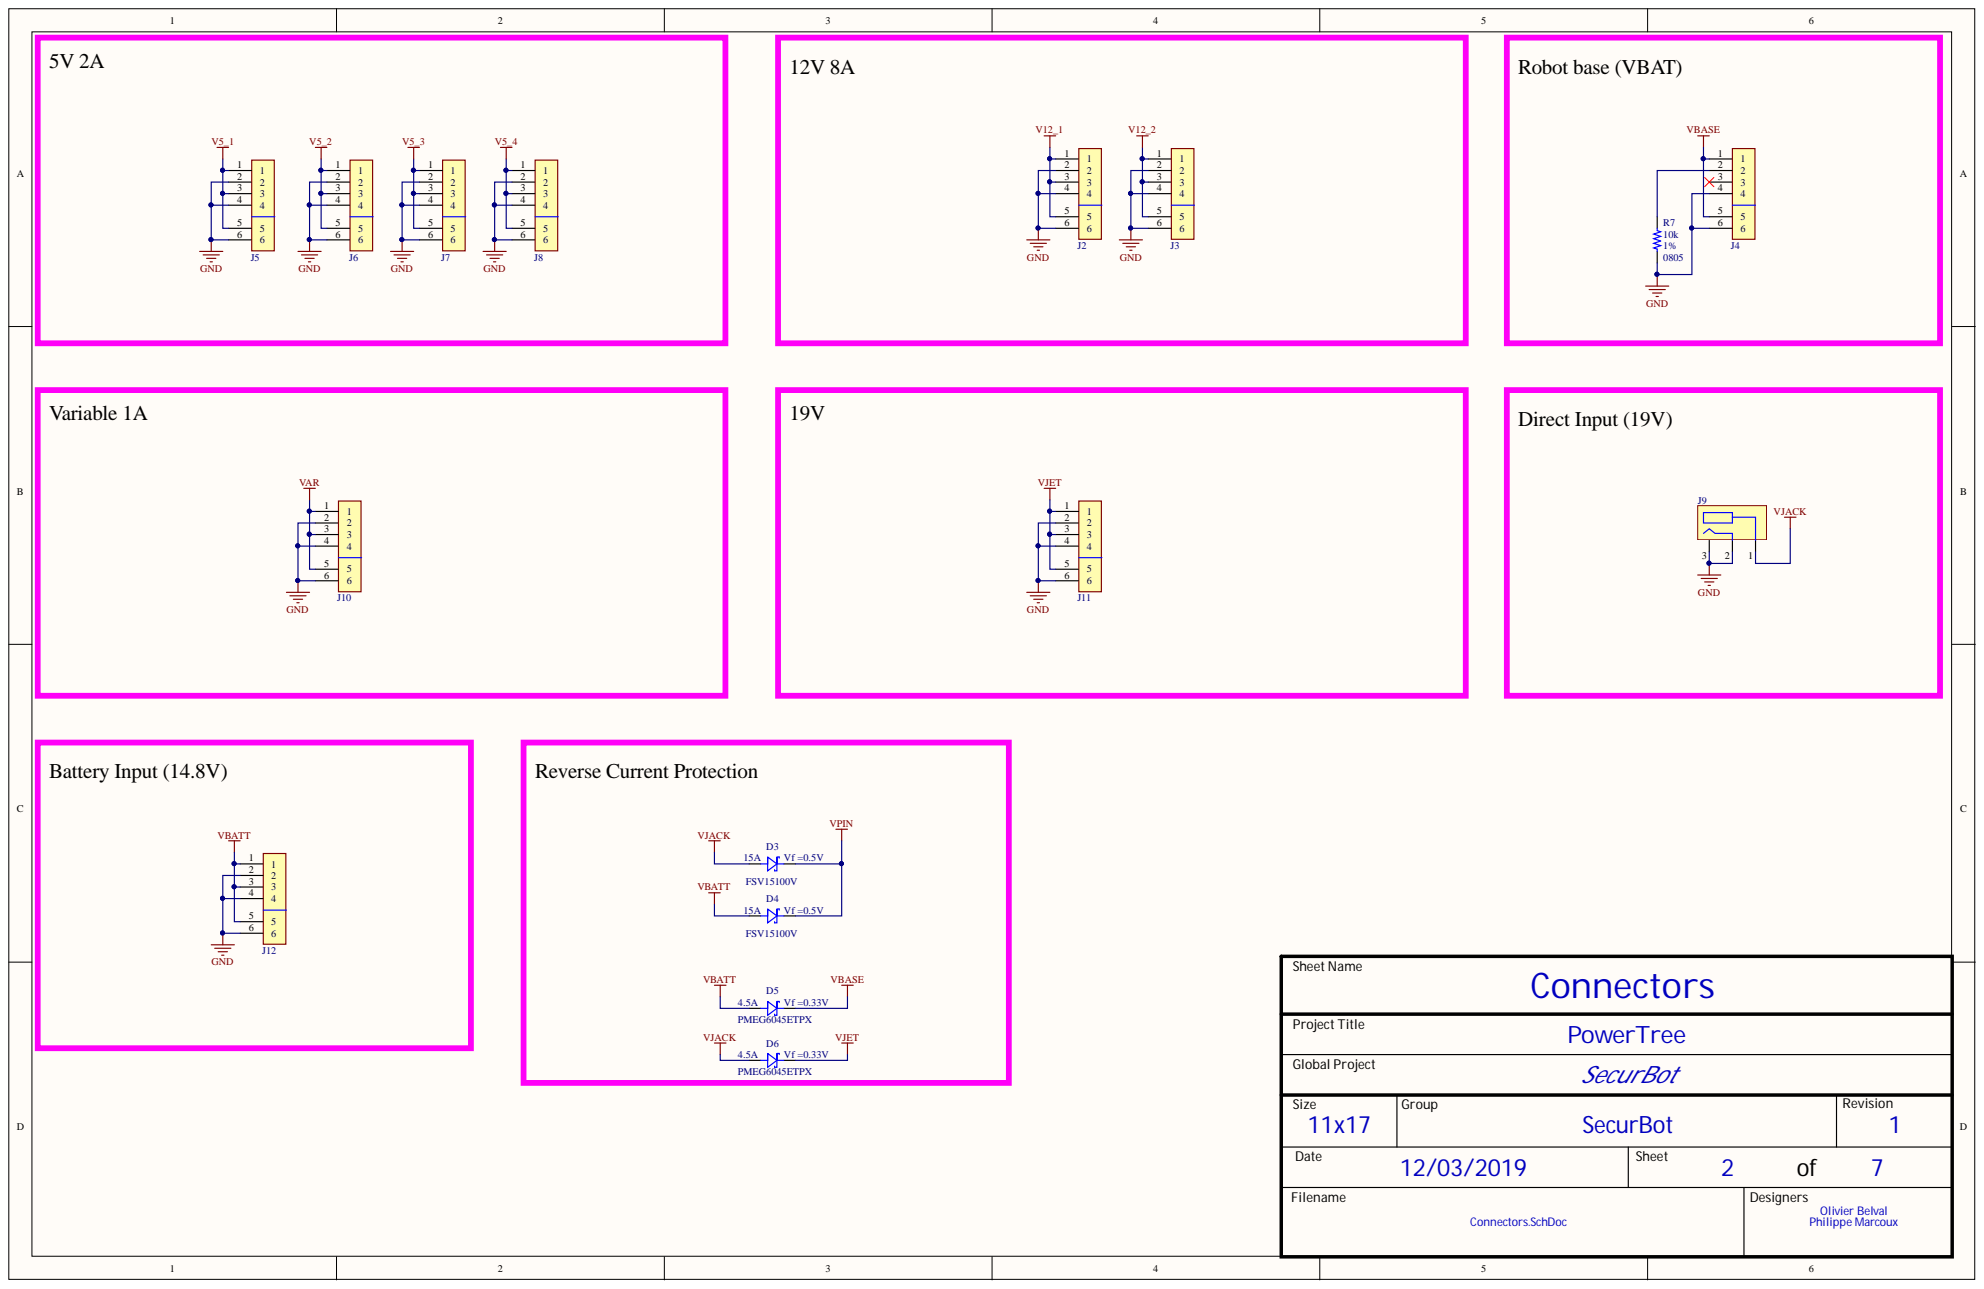
[picture p123: page 2]

Size 11x17 | Group SecurBot | Revision 1

Date 12/03/2019 | Sheet 2 of 7

Filename Connectors.SchDoc | Designers Olivier Belval Philippe Marcoux

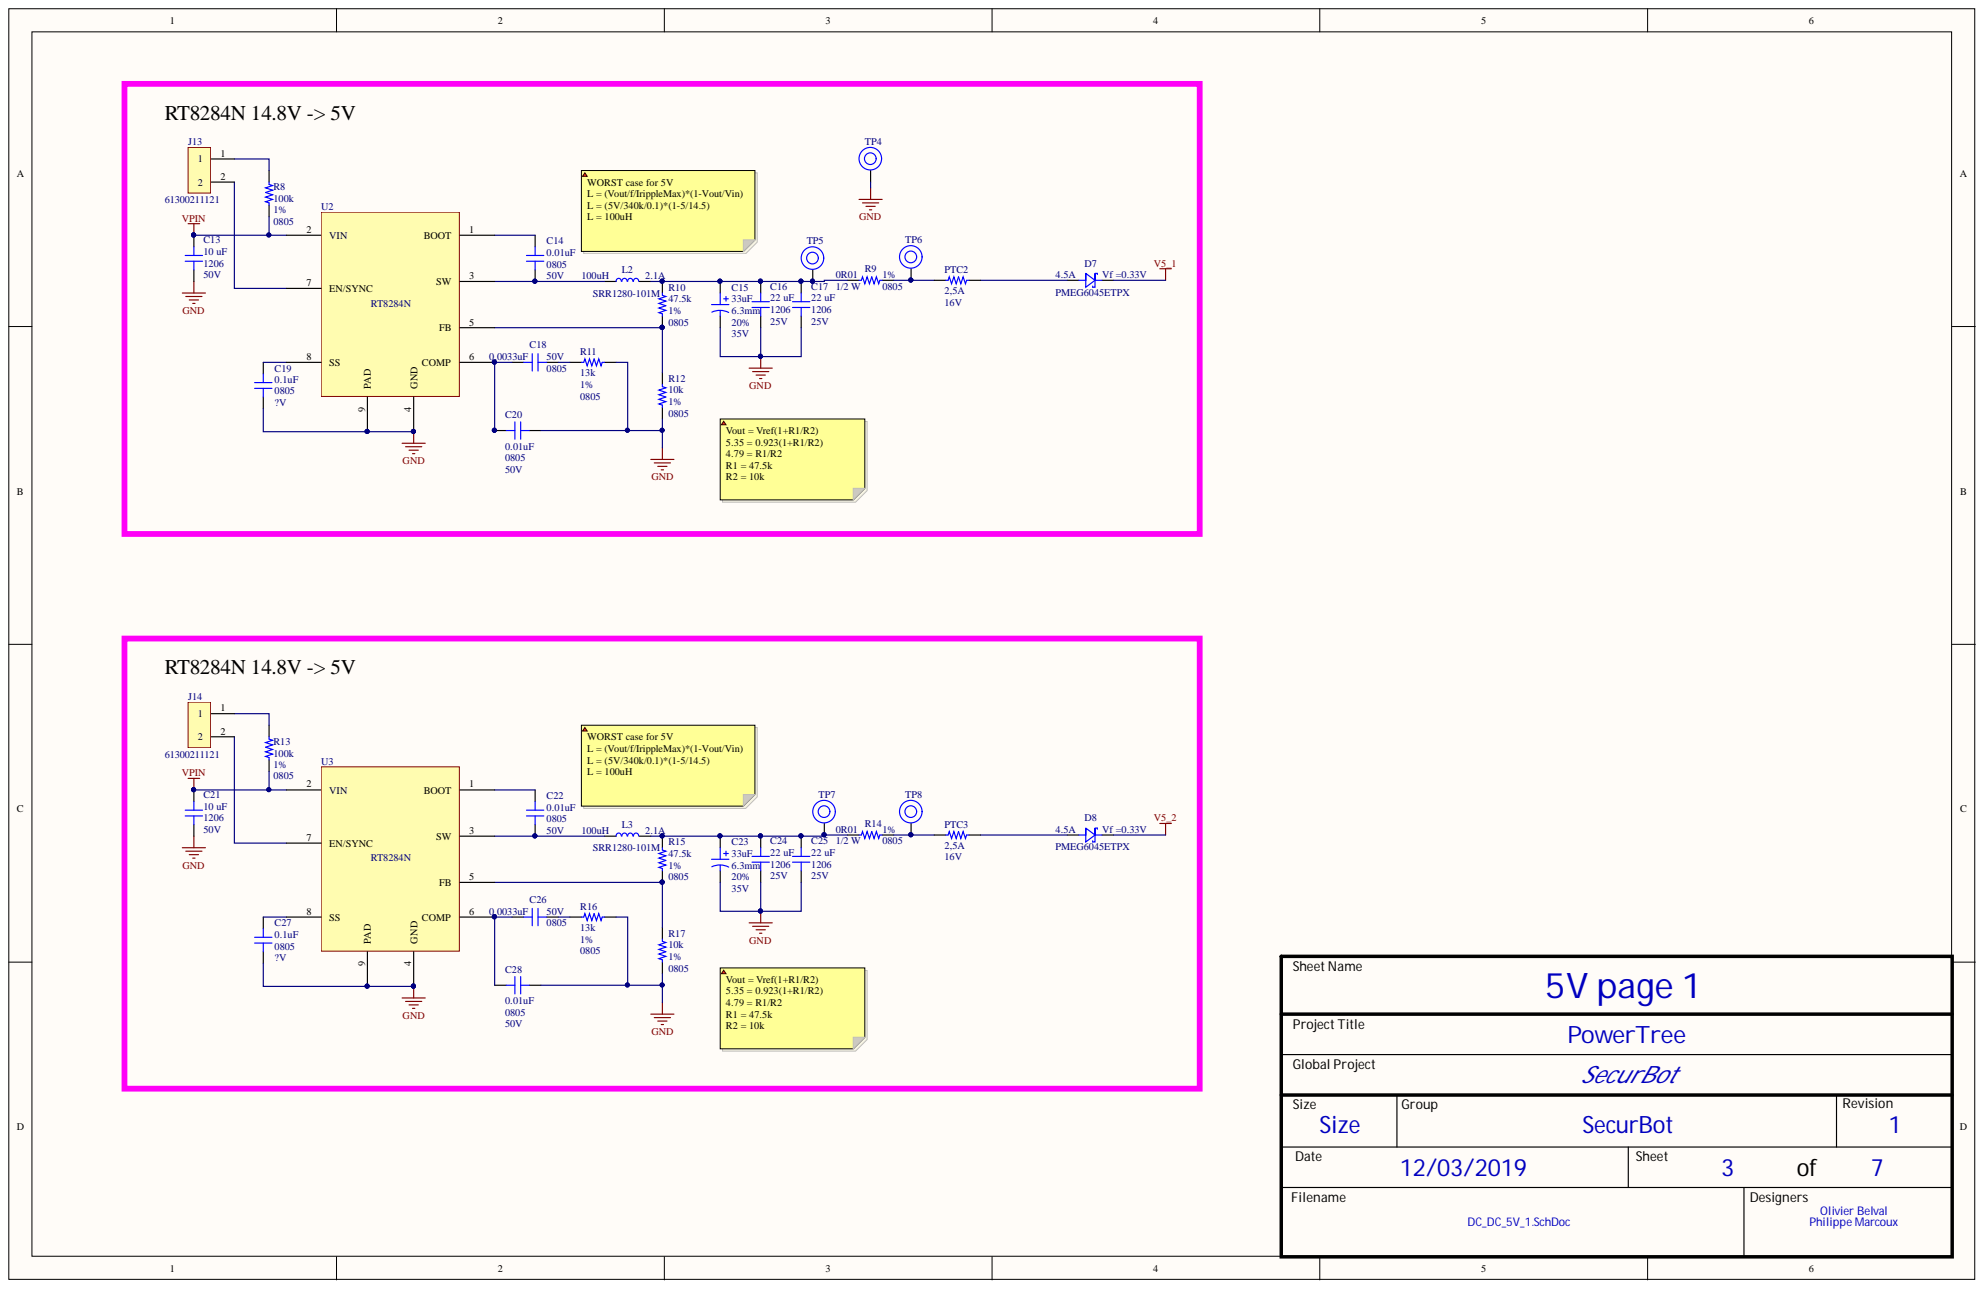
[picture p124: page 3]

Size | Group SecurBot | Revision 1

Date 12/03/2019 | Sheet 3 of 7

Filename DC_DC_5V_1.SchDoc | Designers Olivier Belval Philippe Marcoux

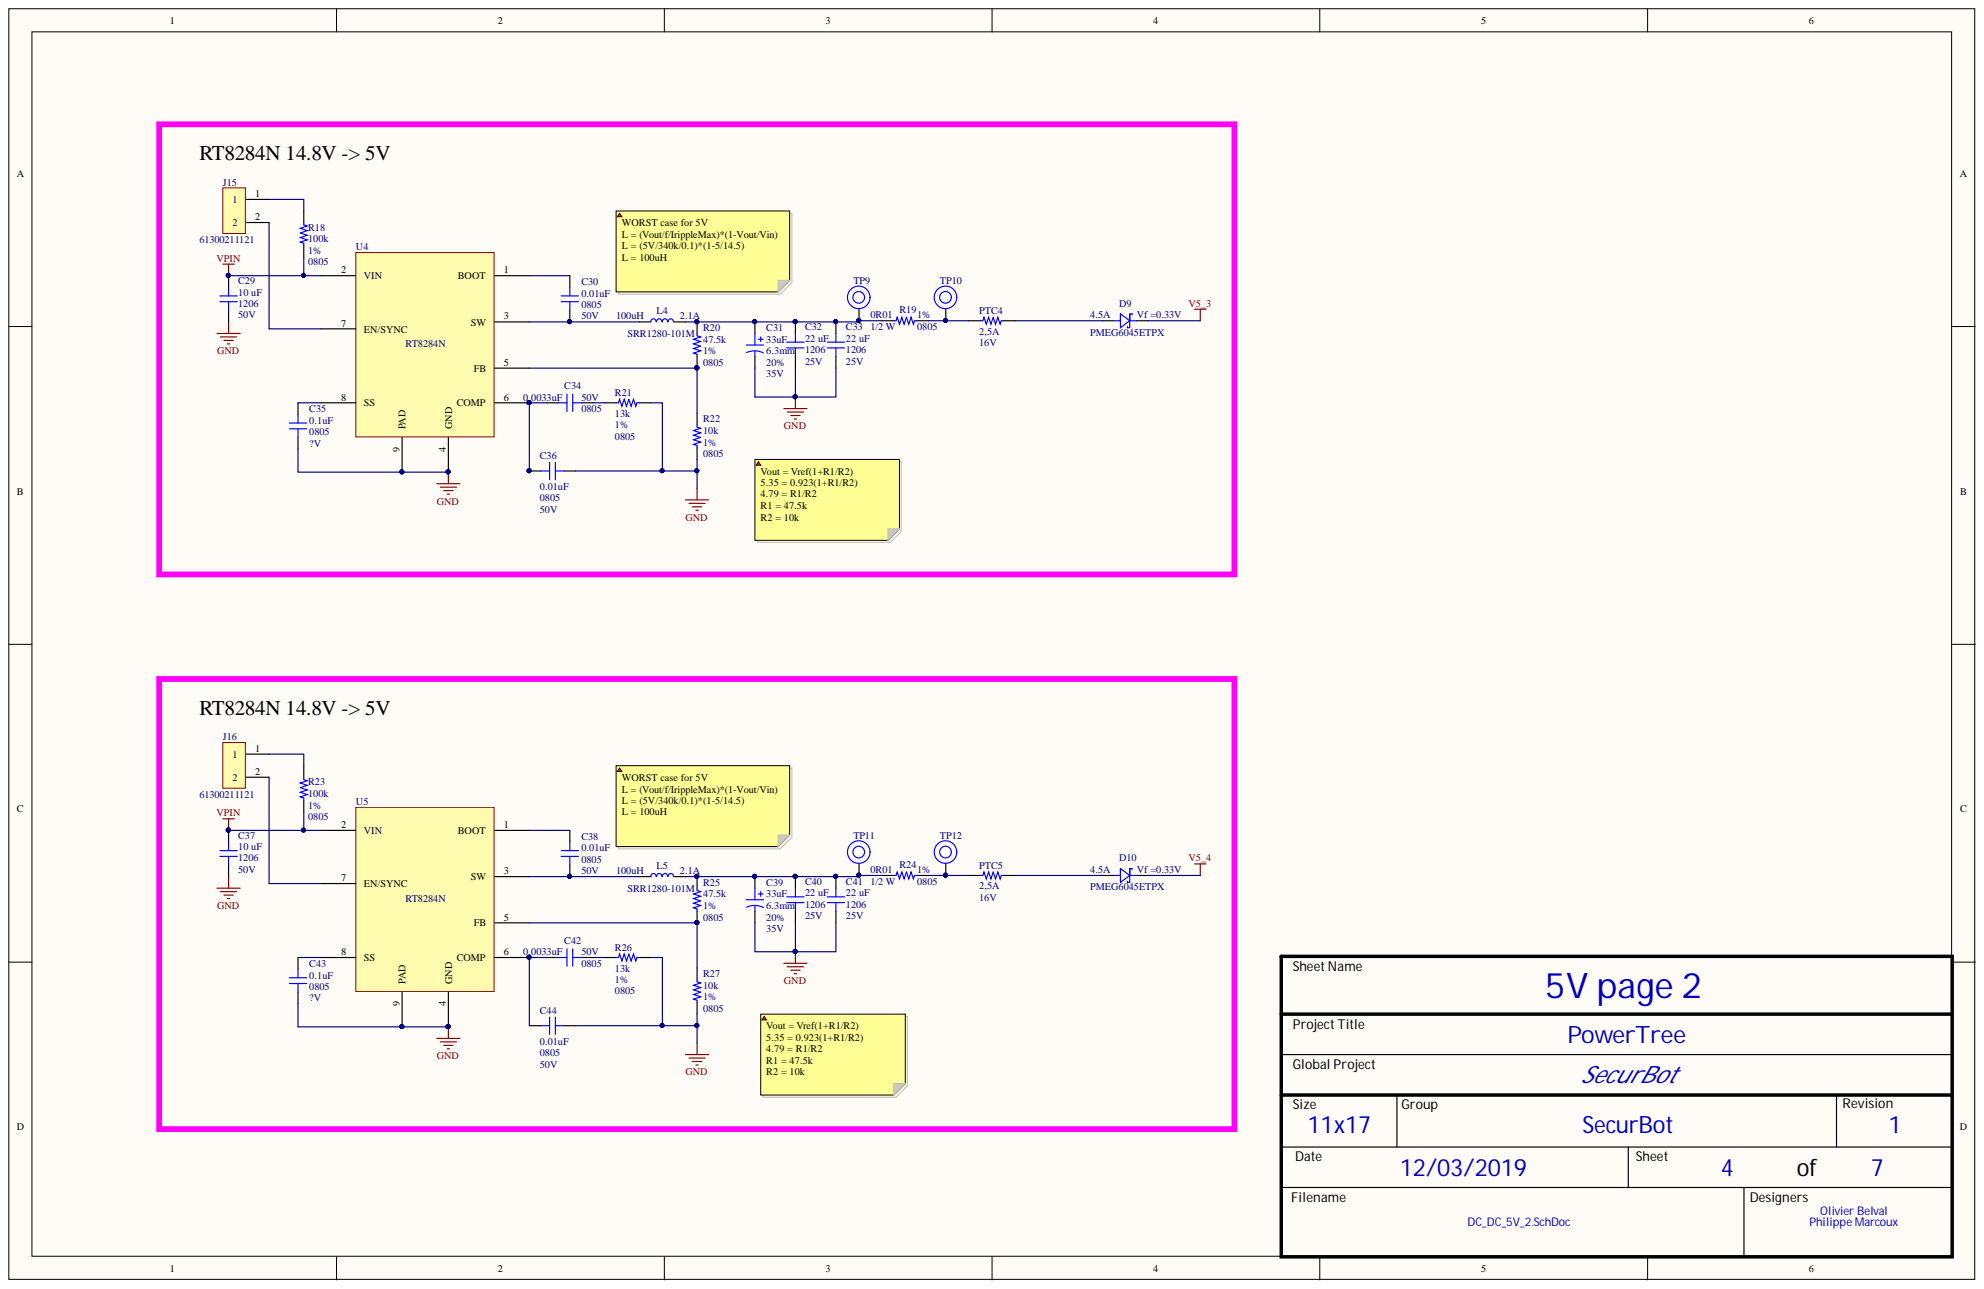
[picture p125: page 4]

Size 11x17 | Group SecurBot | Revision 1

Date 12/03/2019 | Sheet 4 of 7

Filename DC_DC_5V_2.SchDoc | Designers Olivier Belval Philippe Marcoux

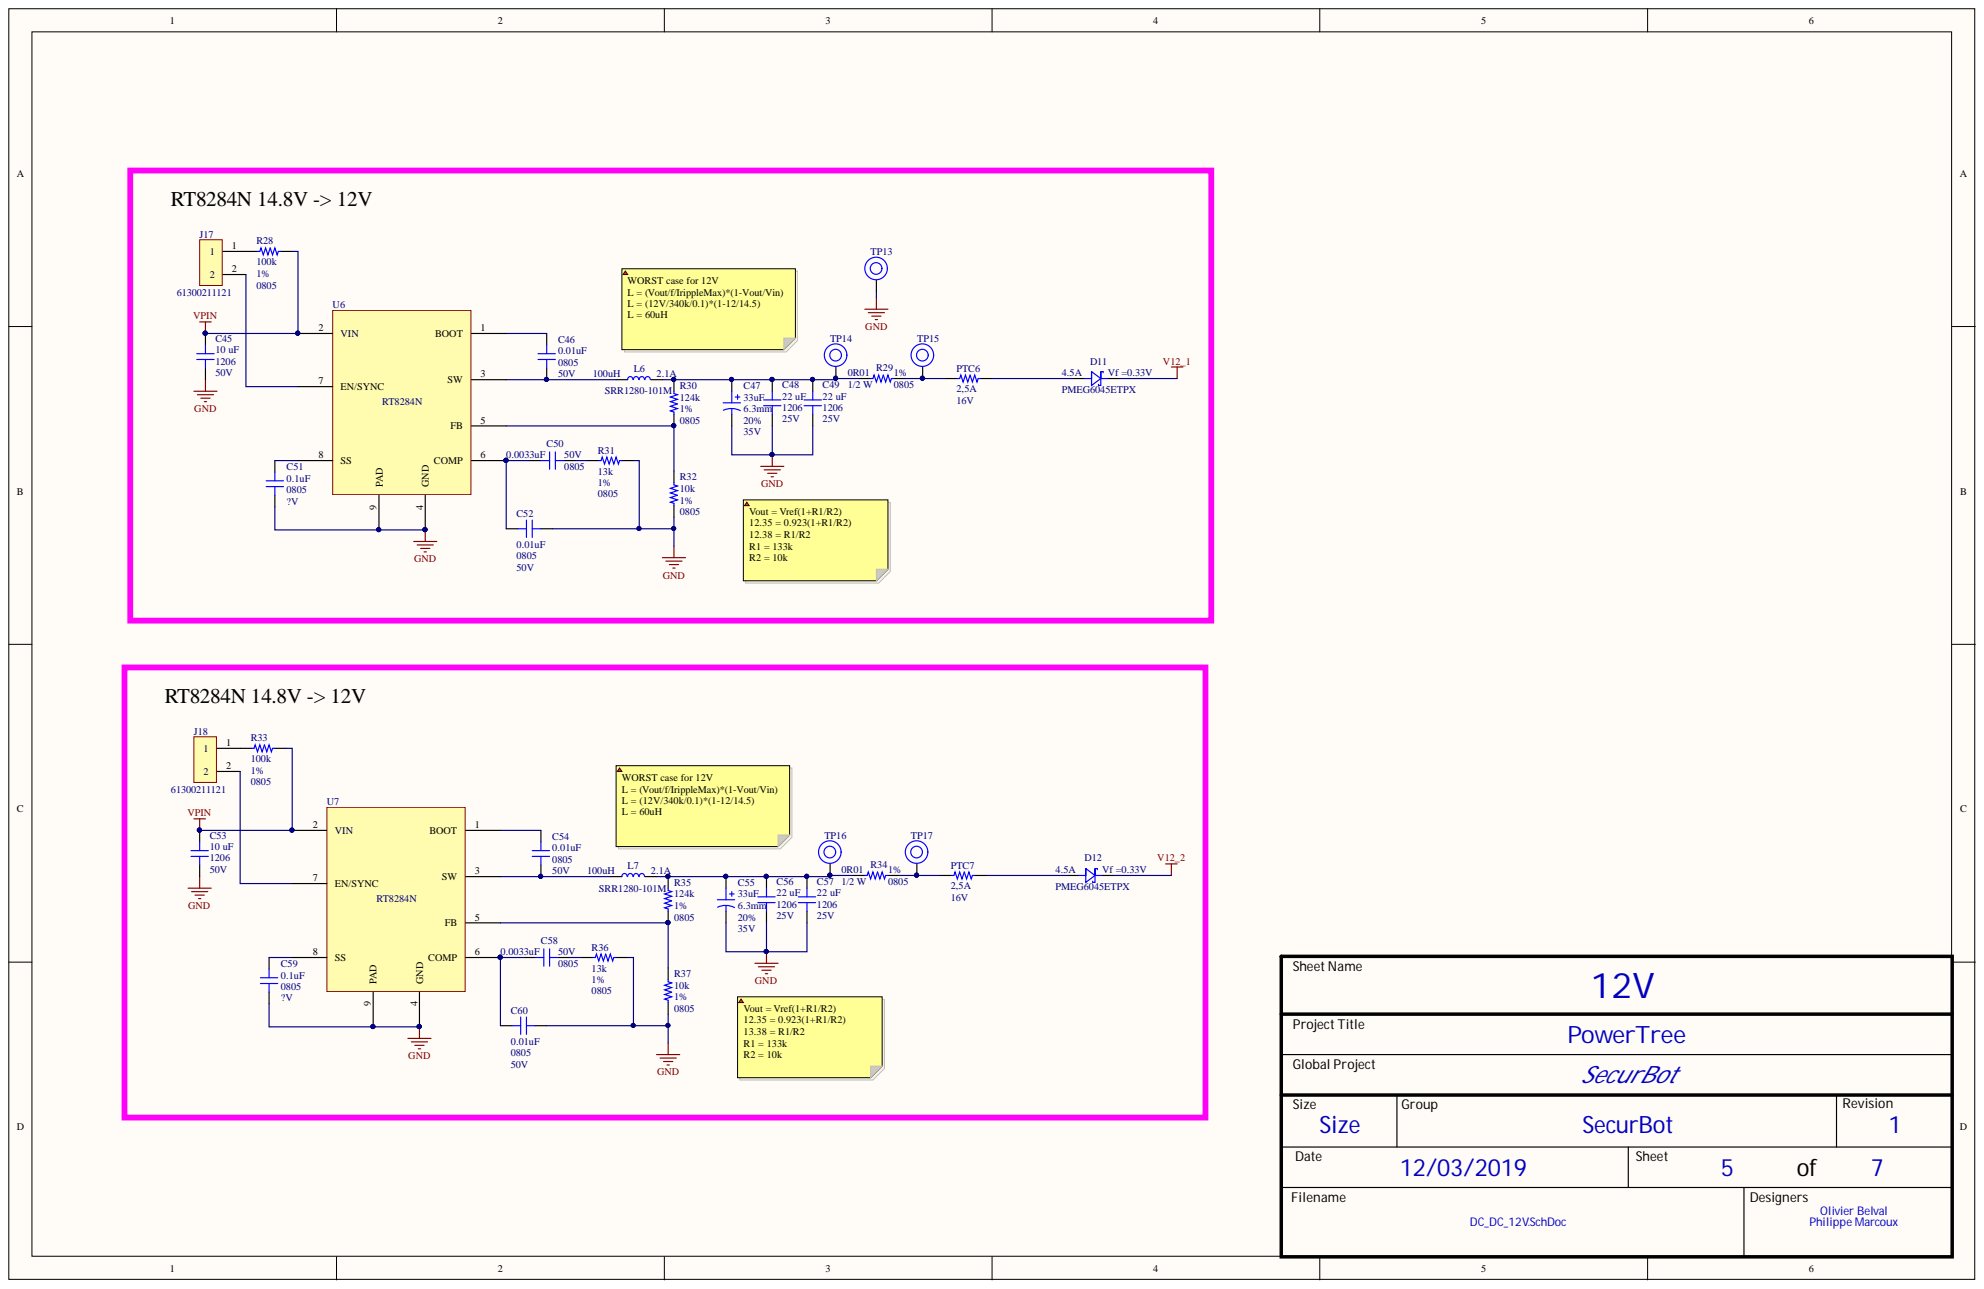
[picture p126: page 5]

Size | Group SecurBot | Revision 1

Date 12/03/2019 | Sheet 5 of 7

Filename DC_DC_12V.SchDoc | Designers Olivier Belval Philippe Marcoux

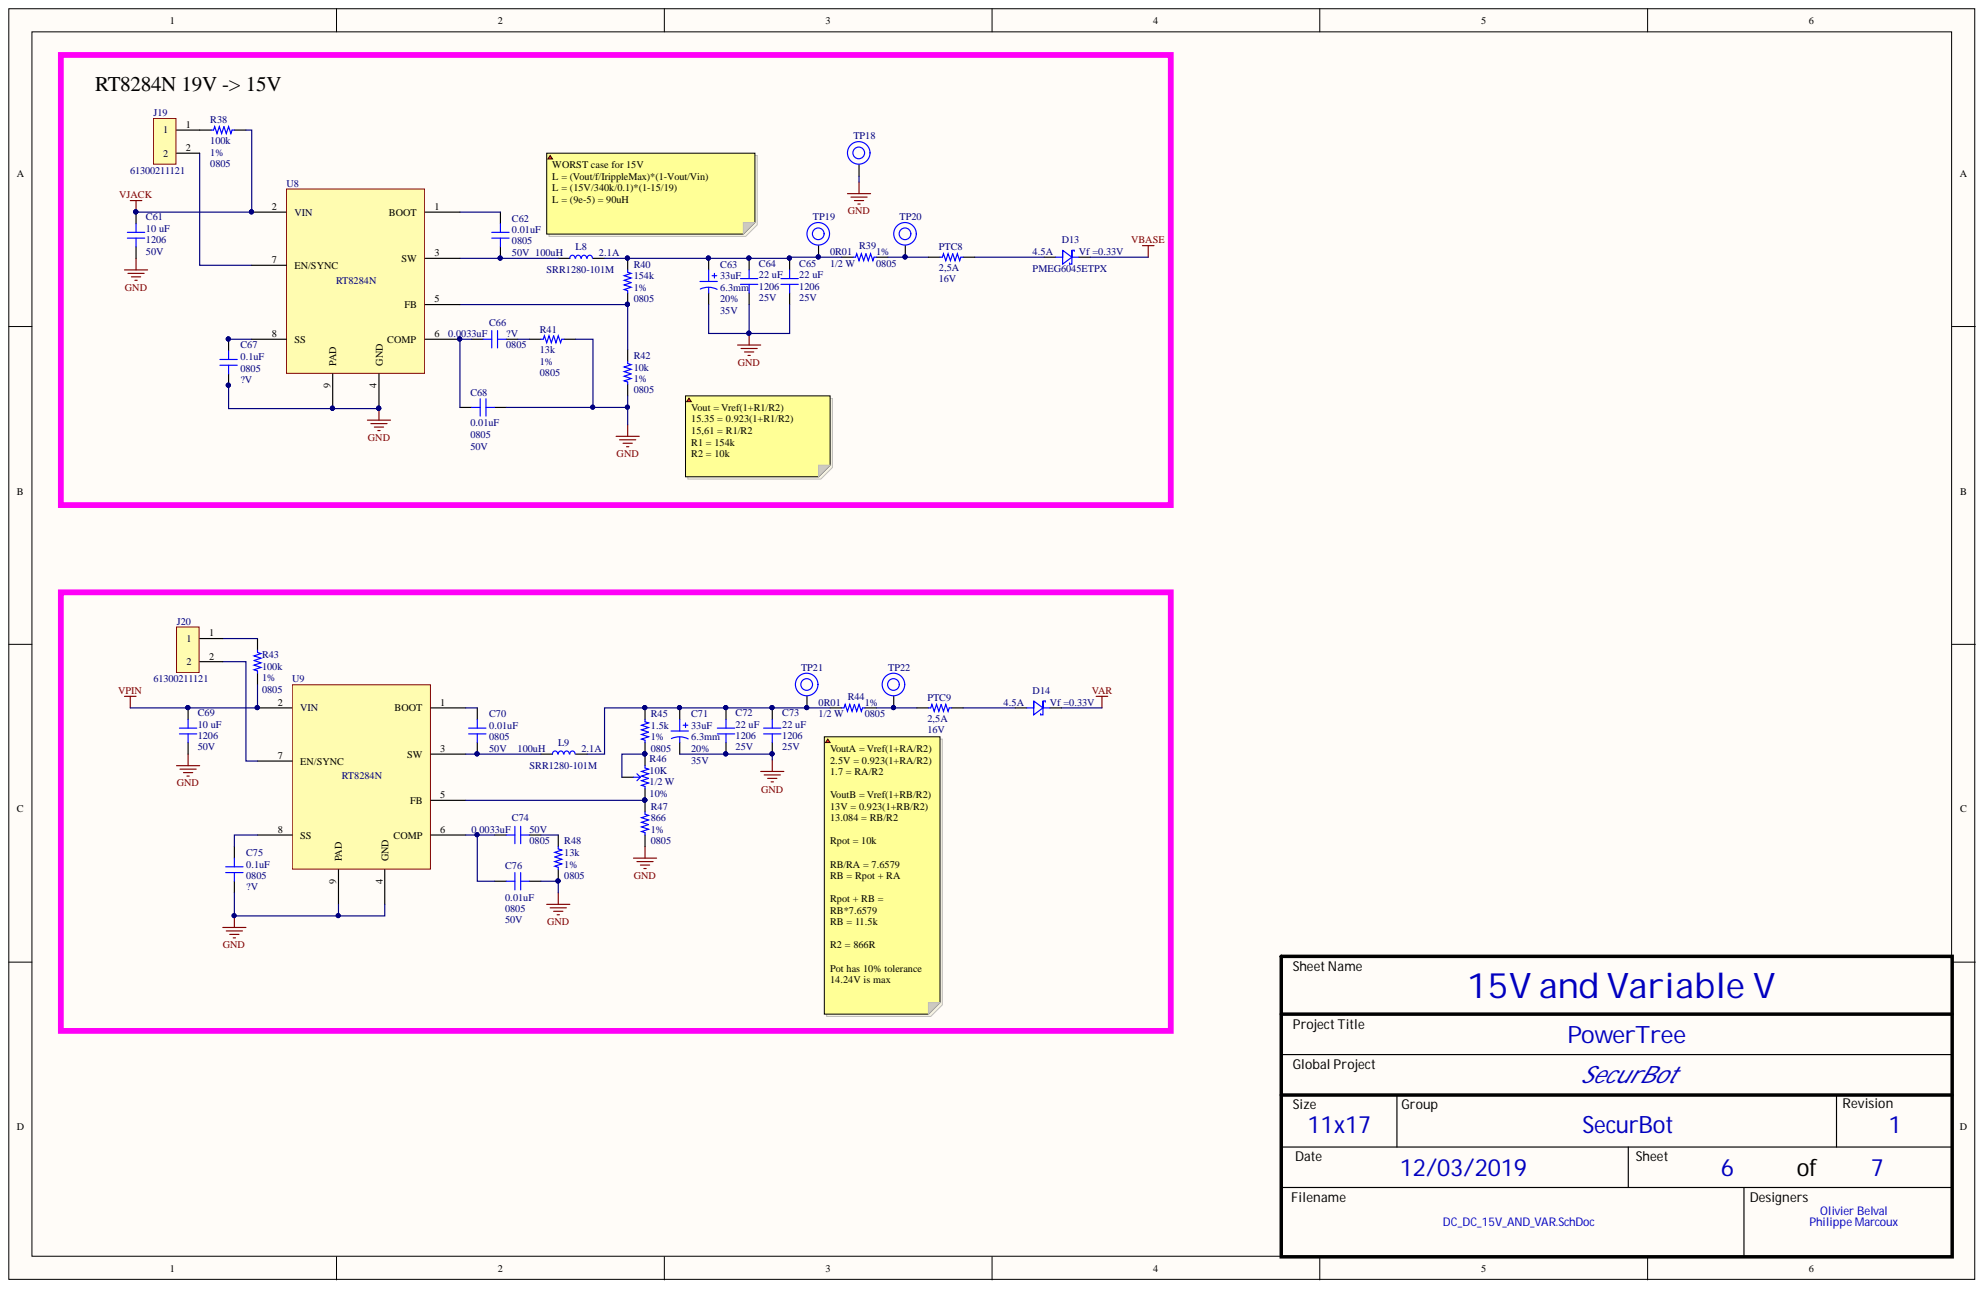
[picture p127: page 6]

Size 11x17 | Group SecurBot | Revision 1

Date 12/03/2019 | Sheet 6 of 7

Filename DC_DC_15V_AND_VAR.SchDoc | Designers Olivier Belval Philippe Marcoux

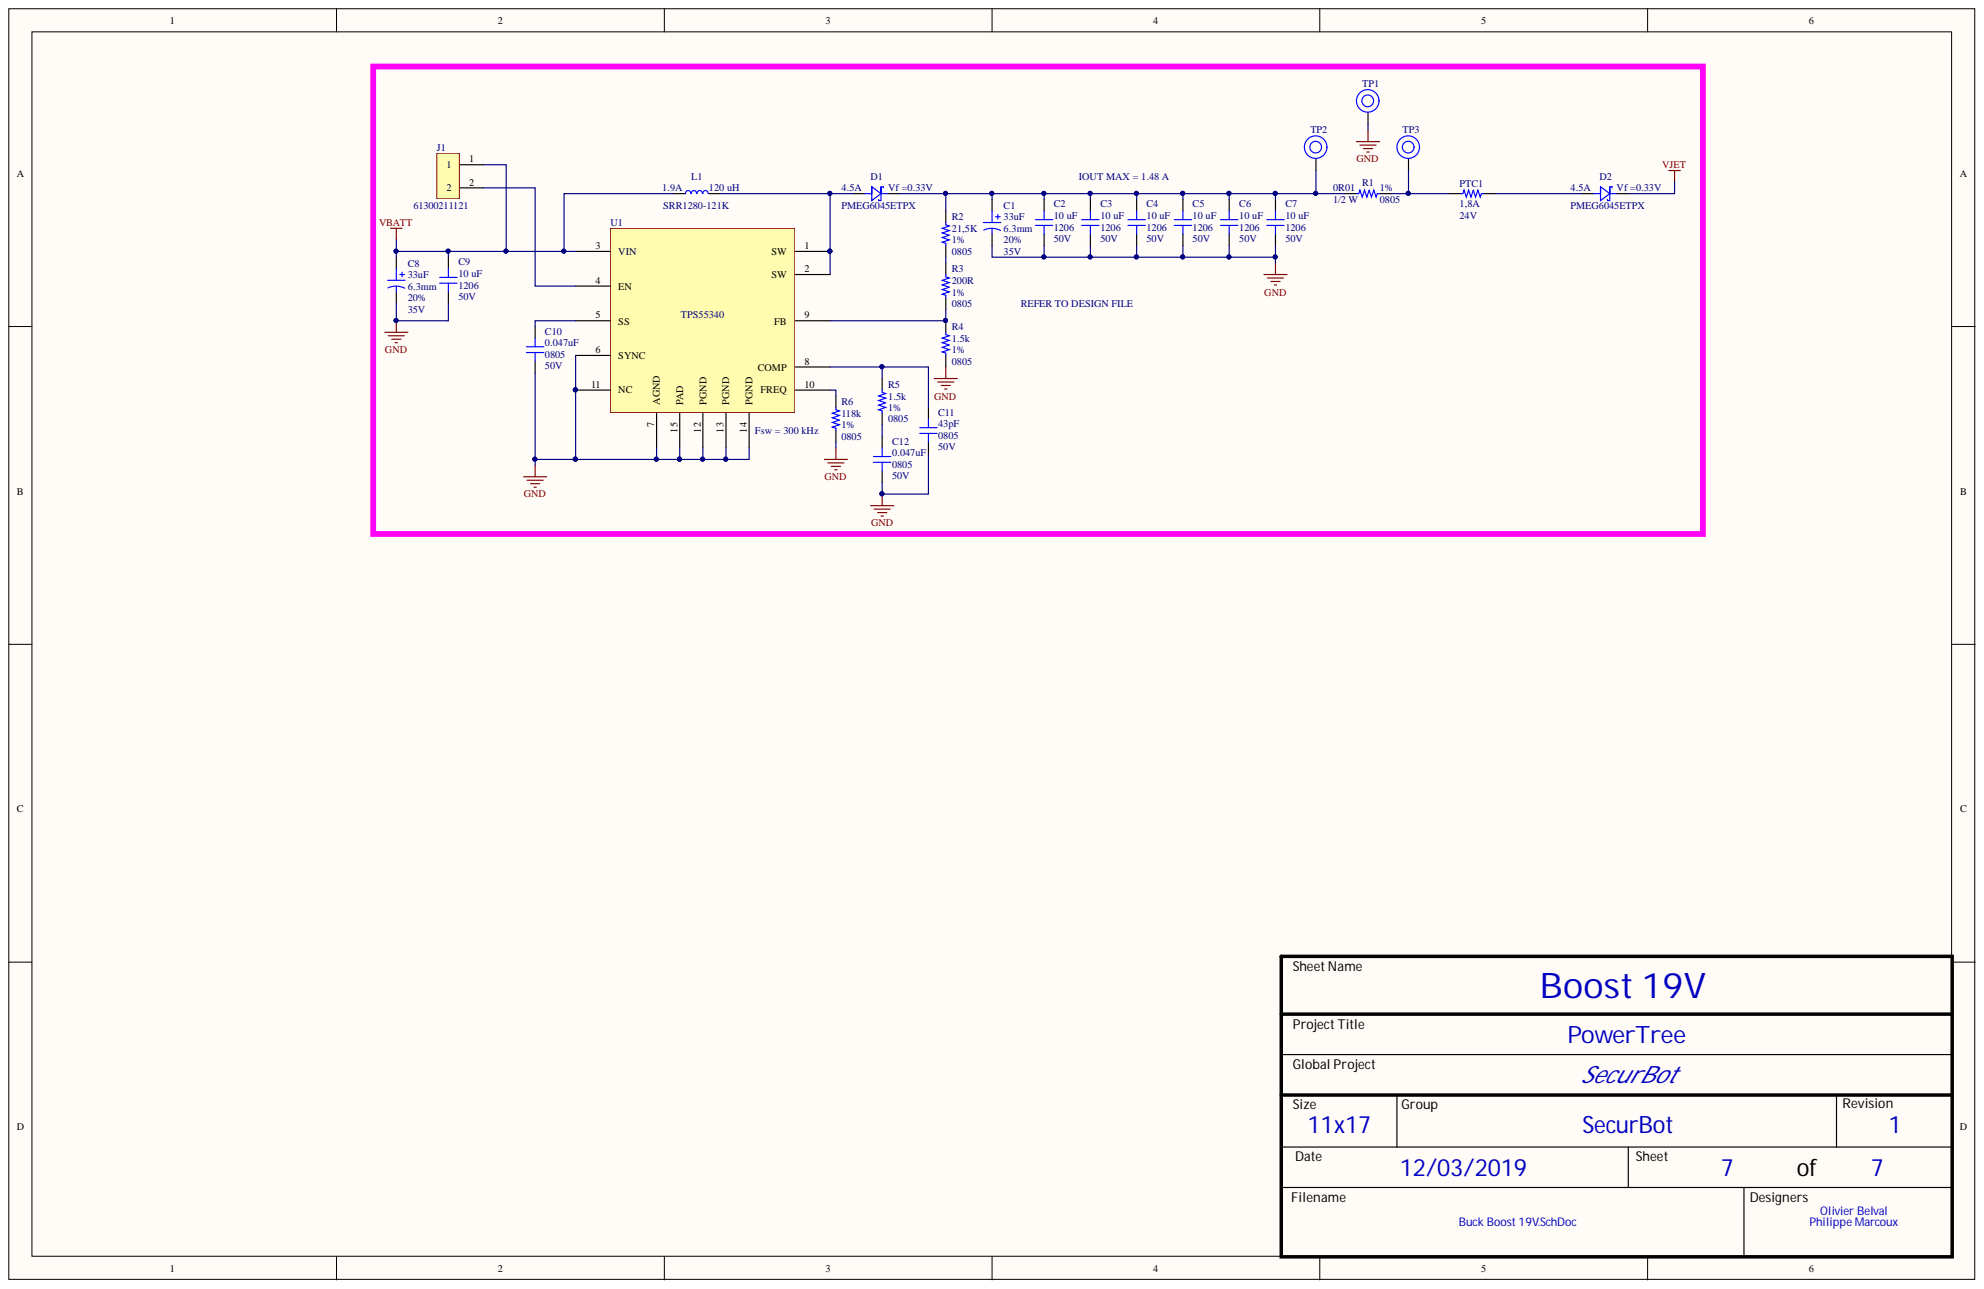
[picture p128: page 7]

REFER TO DESIGN FILE

Size 11x17 | Gro u p Se curBot | Revi s i o n 1

Date 12/03/2019 | Sh e e t 7 of 7

Fi l e n ame Bu ck Boost 1 9V. SchDoc | De s ign ers O l i vie r Be l v a l Philip p e Ma r cou x

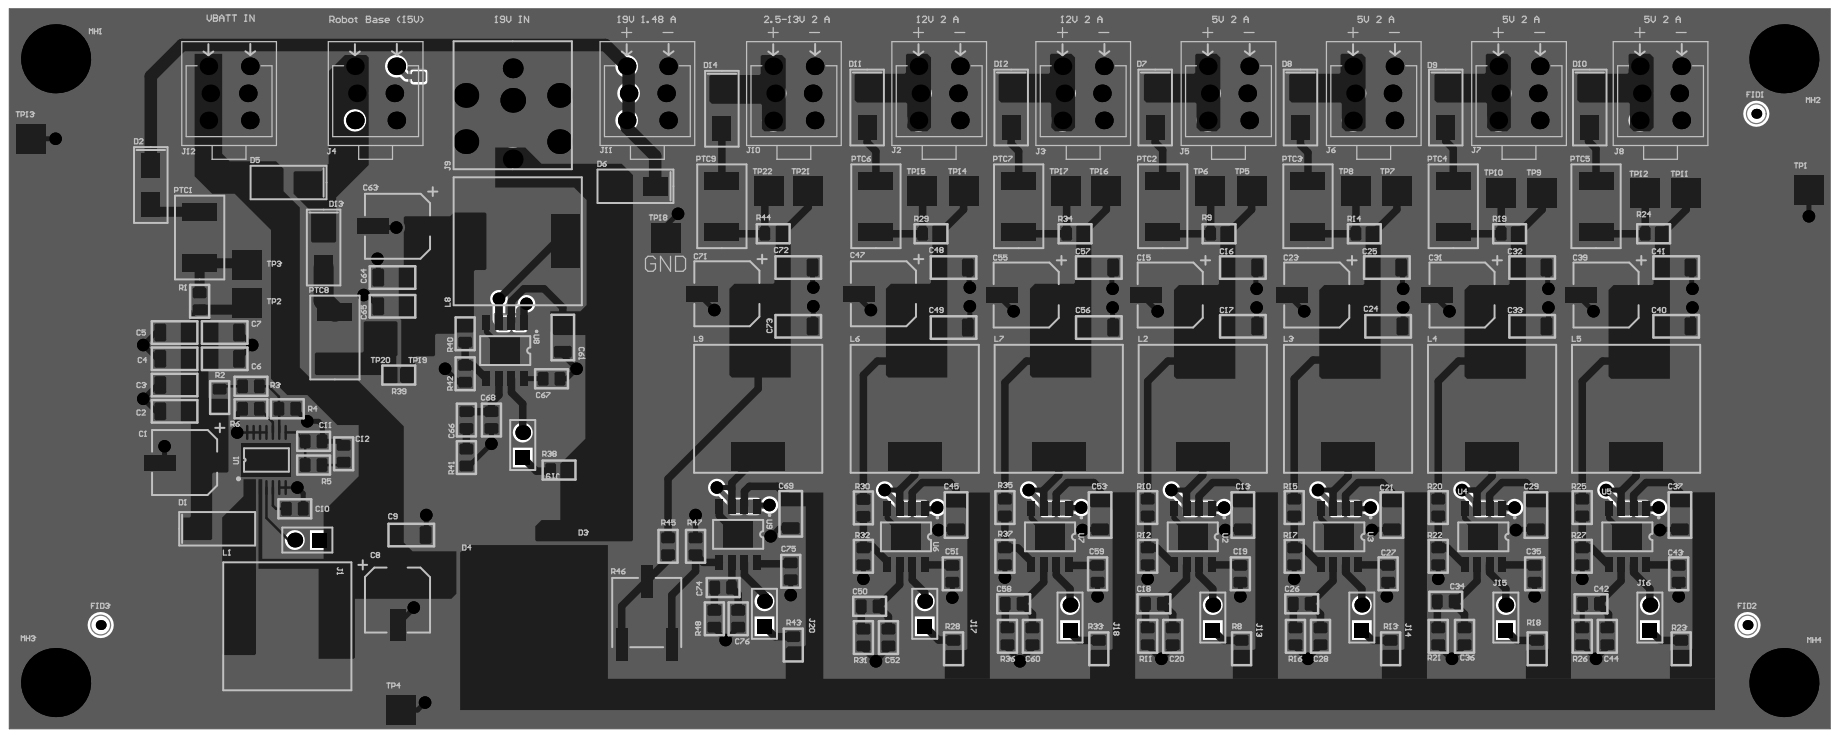
[picture p129: page 8]

# Board S
