introlab/securbot/(list of files, drawings)

Other design files:
hardware/01 - PowerTree/01 - SCHEMAS ET PCB/01 - REVISION 1_000/03 - PROJECT/Buck Boost 19V.SchDoc
hardware/01 - PowerTree/01 - SCHEMAS ET PCB/01 - REVISION 1_000/03 - PROJECT/Connectors.SchDoc
hardware/01 - PowerTree/01 - SCHEMAS ET PCB/01 - REVISION 1_000/03 - PROJECT/DC_DC_5V_1.SchDoc
hardware/01 - PowerTree/01 - SCHEMAS ET PCB/01 - REVISION 1_000/03 - PROJECT/DC_DC_5V_2.SchDoc
hardware/01 - PowerTree/01 - SCHEMAS ET PCB/01 - REVISION 1_000/03 - PROJECT/DC_DC_12V.SchDoc
hardware/01 - PowerTree/01 - SCHEMAS ET PCB/01 - REVISION 1_000/03 - PROJECT/DC_DC_15V_AND_VAR.SchDoc
hardware/01 - PowerTree/01 - SCHEMAS ET PCB/01 - REVISION 1_000/03 - PROJECT/PowerTree.PrjPcb
hardware/01 - PowerTree/01 - SCHEMAS ET PCB/01 - REVISION 1_000/03 - PROJECT/PowerTree/PowerTree.PcbDoc
hardware/01 - PowerTree/01 - SCHEMAS ET PCB/01 - REVISION 1_000/03 - PROJECT/PowerTree/PowerTree.PrjPcb
hardware/01 - PowerTree/01 - SCHEMAS ET PCB/01 - REVISION 1_000/03 - PROJECT/Title.SchDoc
hardware/02 - Battery Board/01 - SCHÉMAS ET PCB/01 - 00001 REVISION/01 - PROJECT/BatteryBoard/ADC.SchDoc
hardware/02 - Battery Board/01 - SCHÉMAS ET PCB/01 - 00001 REVISION/01 - PROJECT/BatteryBoard/Battery Front End.SchDoc
hardware/02 - Battery Board/01 - SCHÉMAS ET PCB/01 - 00001 REVISION/01 - PROJECT/BatteryBoard/BatteryBoard.PrjPcb
hardware/02 - Battery Board/01 - SCHÉMAS ET PCB/01 - 00001 REVISION/01 - PROJECT/BatteryBoard/BatteryBoardTEST.PcbDoc
hardware/02 - Battery Board/01 - SCHÉMAS ET PCB/01 - 00001 REVISION/01 - PROJECT/BatteryBoard/BatteryCharger.SchDoc
hardware/02 - Battery Board/01 - SCHÉMAS ET PCB/01 - 00001 REVISION/01 - PROJECT/BatteryBoard/DC_DC_5V.SchDoc
hardware/02 - Battery Board/01 - SCHÉMAS ET PCB/01 - 00001 REVISION/01 - PROJECT/BatteryBoard/MC.SchDoc
hardware/02 - Battery Board/01 - SCHÉMAS ET PCB/01 - 00001 REVISION/01 - PROJECT/BatteryBoard/Title.SchDoc
hardware/03 - Charge Station/01 - SCHEMAS ET PCB/01 - REVISION 1_000/03 - PROJECT/Charge Station.PcbDoc
hardware/03 - Charge Station/01 - SCHEMAS ET PCB/01 - REVISION 1_000/03 - PROJECT/Charge Station.PrjPcb
hardware/03 - Charge Station/01 - SCHEMAS ET PCB/01 - REVISION 1_000/03 - PROJECT/Charge Station.SchDoc
hardware/03 - Charge Station/01 - SCHEMAS ET PCB/01 - REVISION 1_000/03 - PROJECT/Title.SchDoc
hardware/97 - DEFAULTS/Altium_Librairie_PCB_Default.PcbLib
hardware/97 - DEFAULTS/Altium_Librairie_Schematic_Default.SchLib
hardware/97 - DEFAULTS/Altium_PCB_Default.PcbDoc
hardware/97 - DEFAULTS/Altium_PCB_Project_Default.PrjPCB
hardware/97 - DEFAULTS/Altium_Schematic_Default.SchDoc
hardware/99 - LIBRARY/SecureBot.PcbLib
hardware/99 - LIBRARY/SecureBot.SchLib
PCB design/02 - Battery Board/01 - SCHÉMAS ET PCB/01 - 00001 REVISION/01 - PROJECT/BatteryBoard/BatteryBoard.PcbDoc
