introlab/securbot/ros_pkg/roboclaw_node/nodes/roboclaw_node.py

#!/usr/bin/env python
from math import pi, cos, sin

import diagnostic_msgs
import diagnostic_updater
import roboclaw_driver.roboclaw_driver as roboclaw
import rospy
import tf
from geometry_msgs.msg import Quaternion, Twist
from nav_msgs.msg import Odometry
from threading import Lock

__author__ = "bwbazemore@uga.edu (Brad Bazemore)"

mutex = Lock()

class EncoderOdom:
    def __init__(self, ticks_per_meter, base_width):
        self.TICKS_PER_METER = ticks_per_meter
        self.BASE_WIDTH = base_width
        self.odom_pub = rospy.Publisher('/odom', Odometry, queue_size=10)
        self.cur_x = 0
        self.cur_y = 0
        self.cur_theta = 0.0
        self.last_enc_left = 0
        self.last_enc_right = 0
        self.last_enc_time = rospy.Time.now()

    @staticmethod
    def normalize_angle(angle):
        while angle > pi:
            angle -= 2.0 * pi
        while angle < -pi:
            angle += 2.0 * pi
        return angle

    def update(self, enc_left, enc_right):
        left_ticks = enc_left - self.last_enc_left
        right_ticks = enc_right - self.last_enc_right
        self.last_enc_left = enc_left
        self.last_enc_right = enc_right

        dist_left = left_ticks / self.TICKS_PER_METER
        dist_right = right_ticks / self.TICKS_PER_METER
        dist = (dist_right + dist_left) / 2.0

        current_time = rospy.Time.now()
        d_time = (current_time - self.last_enc_time).to_sec()
        self.last_enc_time = current_time

        # TODO find better what to determine going straight, this means slight deviation is accounted
        if left_ticks == right_ticks:
            d_theta = 0.0
            self.cur_x += dist * cos(self.cur_theta)
            self.cur_y += dist * sin(self.cur_theta)
        else:
            d_theta = (dist_right - dist_left) / self.BASE_WIDTH
            r = dist / d_theta
            self.cur_x += r * (sin(d_theta + self.cur_theta) - sin(self.cur_theta))
            self.cur_y += r * (cos(d_theta + self.cur_theta) - cos(self.cur_theta))
            self.cur_theta = self.normalize_angle(self.cur_theta + d_theta)

        if abs(d_time) < 0.000001:
            vel_x = 0.0
            vel_theta = 0.0
        else:
            vel_x = dist / d_time
            vel_theta = d_theta / d_time

        return vel_x, vel_theta

    def update_publish(self, enc_right, enc_left):
        # 22000 per 0.13 seconds is max speed
        if abs(enc_left - self.last_enc_left) > 30000:
            rospy.logwarn("Encoder jump: cur %d, last %d" % (enc_left, self.last_enc_left))
        if abs(enc_right - self.last_enc_right) > 30000:
            rospy.logwarn("Encoder jump: cur %d, last %d" % (enc_right, self.last_enc_right))
        vel_x, vel_theta = self.update(enc_left, enc_right)
        self.publish_odom(self.cur_x, self.cur_y, self.cur_theta, vel_x, vel_theta)

    def publish_odom(self, cur_x, cur_y, cur_theta, vx, vth):
        quat = tf.transformations.quaternion_from_euler(0, 0, cur_theta)
        current_time = rospy.Time.now()

        br = tf.TransformBroadcaster()
        br.sendTransform((cur_x, cur_y, 0),
                         tf.transformations.quaternion_from_euler(0, 0, -cur_theta),
                         current_time,
                         "base_footprint",
                         "odom")

        odom = Odometry()
        odom.header.stamp = current_time
        odom.header.frame_id = 'odom'

        odom.pose.pose.position.x = cur_x
        odom.pose.pose.position.y = cur_y
        odom.pose.pose.position.z = 0.0
        odom.pose.pose.orientation = Quaternion(*quat)

        odom.pose.covariance[0] = 0.009
        odom.pose.covariance[7] = 0.009
        odom.pose.covariance[14] = 99999
        odom.pose.covariance[21] = 99999
        odom.pose.covariance[28] = 99999
        odom.pose.covariance[35] = 0.009

        odom.child_frame_id = 'base_footprint'
        odom.twist.twist.linear.x = vx
        odom.twist.twist.linear.y = 0
        odom.twist.twist.angular.z = -vth
        odom.twist.covariance = odom.pose.covariance

        self.odom_pub.publish(odom)


class Node:
    def __init__(self):

        self.ERRORS = {0x0000: (diagnostic_msgs.msg.DiagnosticStatus.OK, "Normal"),
                       0x0001: (diagnostic_msgs.msg.DiagnosticStatus.WARN, "M1 over current"),
                       0x0002: (diagnostic_msgs.msg.DiagnosticStatus.WARN, "M2 over current"),
                       0x0004: (diagnostic_msgs.msg.DiagnosticStatus.ERROR, "Emergency Stop"),
                       0x0008: (diagnostic_msgs.msg.DiagnosticStatus.ERROR, "Temperature1"),
                       0x0010: (diagnostic_msgs.msg.DiagnosticStatus.ERROR, "Temperature2"),
                       0x0020: (diagnostic_msgs.msg.DiagnosticStatus.ERROR, "Main batt voltage high"),
                       0x0040: (diagnostic_msgs.msg.DiagnosticStatus.ERROR, "Logic batt voltage high"),
                       0x0080: (diagnostic_msgs.msg.DiagnosticStatus.ERROR, "Logic batt voltage low"),
                       0x0100: (diagnostic_msgs.msg.DiagnosticStatus.WARN, "M1 driver fault"),
                       0x0200: (diagnostic_msgs.msg.DiagnosticStatus.WARN, "M2 driver fault"),
                       0x0400: (diagnostic_msgs.msg.DiagnosticStatus.WARN, "Main batt voltage high"),
                       0x0800: (diagnostic_msgs.msg.DiagnosticStatus.WARN, "Main batt voltage low"),
                       0x1000: (diagnostic_msgs.msg.DiagnosticStatus.WARN, "Temperature1"),
                       0x2000: (diagnostic_msgs.msg.DiagnosticStatus.WARN, "Temperature2"),
                       0x4000: (diagnostic_msgs.msg.DiagnosticStatus.OK, "M1 home"),
                       0x8000: (diagnostic_msgs.msg.DiagnosticStatus.OK, "M2 home")}

        rospy.init_node("roboclaw_node")
        rospy.on_shutdown(self.shutdown)
        rospy.loginfo("Connecting to roboclaw")
        dev_name = rospy.get_param("~dev", "/dev/ttyACM0")
        baud_rate = int(rospy.get_param("~baud", "115200"))

        self.address = int(rospy.get_param("~address", "128"))
        if self.address > 0x87 or self.address < 0x80:
            rospy.logfatal("Address out of range")
            rospy.signal_shutdown("Address out of range")

        # TODO need someway to check if address is correct
        try:
	    mutex.acquire()
            roboclaw.Open(dev_name, baud_rate)
        except Exception as e:
            rospy.logfatal("Could not connect to Roboclaw")
            rospy.logdebug(e)
            rospy.signal_shutdown("Could not connect to Roboclaw")
	finally:
	    mutex.release()

        self.updater = diagnostic_updater.Updater()
        self.updater.setHardwareID("Roboclaw")
        self.updater.add(diagnostic_updater.
                         FunctionDiagnosticTask("Vitals", self.check_vitals))

        try:
	    mutex.acquire()
            version = roboclaw.ReadVersion(self.address)
        except Exception as e:
            rospy.logwarn("Problem getting roboclaw version")
            rospy.logdebug(e)
            pass
	finally:
	    mutex.release()


        if not version[0]:
            rospy.logwarn("Could not get version from roboclaw")
        else:
            rospy.logdebug(repr(version[1]))

        roboclaw.SpeedM1M2(self.address, 0, 0)
        roboclaw.ResetEncoders(self.address)

        self.MAX_SPEED = float(rospy.get_param("~max_speed", "2.0"))
        self.TICKS_PER_METER = float(rospy.get_param("~tick_per_meter", "4342.2"))
        self.BASE_WIDTH = float(rospy.get_param("~base_width", "0.315"))

        self.encodm = EncoderOdom(self.TICKS_PER_METER, self.BASE_WIDTH)
        self.last_set_speed_time = rospy.get_rostime()

        rospy.Subscriber("cmd_vel", Twist, self.cmd_vel_callback, queue_size=1, tcp_nodelay=True)

        rospy.sleep(1)

        rospy.logdebug("dev %s", dev_name)
        rospy.logdebug("baud %d", baud_rate)
        rospy.logdebug("address %d", self.address)
        rospy.logdebug("max_speed %f", self.MAX_SPEED)
        rospy.logdebug("ticks_per_meter %f", self.TICKS_PER_METER)
        rospy.logdebug("base_width %f", self.BASE_WIDTH)

    def run(self):
        rospy.loginfo("Starting motor drive")
        r_time = rospy.Rate(10)
        while not rospy.is_shutdown():

            if (rospy.get_rostime() - self.last_set_speed_time).to_sec() > 1:
                rospy.loginfo("Did not get command for 1 second, stopping")
                try:
		    mutex.acquire()
                    roboclaw.ForwardM1(self.address, 0)
                    roboclaw.ForwardM2(self.address, 0)
                except OSError as e:
                    rospy.logerr("Could not stop")
                    rospy.logdebug(e)
		finally:
	    	    mutex.release()


            # TODO need find solution to the OSError11 looks like sync problem with serial
            status1, enc1, crc1 = None, None, None
            status2, enc2, crc2 = None, None, None

            try:
		mutex.acquire()
                status1, enc1, crc1 = roboclaw.ReadEncM1(self.address)
            except ValueError:
		rospy.logwarn("Error in Enc1 value")
                pass
            except OSError as e:
                rospy.logwarn("ReadEncM1 OSError: %d", e.errno)
                rospy.logdebug(e)
	    finally:
	        mutex.release()

            try:
		mutex.acquire()
                status2, enc2, crc2 = roboclaw.ReadEncM2(self.address)
            except ValueError:
		rospy.logwarn("Error in Enc2 value")
                pass
            except OSError as e:
                rospy.logwarn("ReadEncM2 OSError: %d", e.errno)
                rospy.logdebug(e)
	    finally:
	        mutex.release()

            if (enc1 is not None) and (enc2 is not None):
                rospy.logdebug(" Encoders %d %d" % (enc1, enc2))
                self.encodm.update_publish(enc1, enc2)

                self.updater.update()
            r_time.sleep()

    def cmd_vel_callback(self, twist):
        self.last_set_speed_time = rospy.get_rostime()

        linear_x = twist.linear.x
        if linear_x > self.MAX_SPEED:
            linear_x = self.MAX_SPEED
        if linear_x < -self.MAX_SPEED:
            linear_x = -self.MAX_SPEED

        vr = linear_x + twist.angular.z * self.BASE_WIDTH / 2.0  # m/s
        vl = linear_x - twist.angular.z * self.BASE_WIDTH / 2.0

        vr_ticks = int(vr * self.TICKS_PER_METER)  # ticks/s
        vl_ticks = int(vl * self.TICKS_PER_METER)

        rospy.logdebug("vr_ticks:%d vl_ticks: %d", vr_ticks, vl_ticks)

        try:
	    mutex.acquire()
            # This is a hack way to keep a poorly tuned PID from making noise at speed 0
            if vr_ticks is 0 and vl_ticks is 0:
                roboclaw.ForwardM1(self.address, 0)
                roboclaw.ForwardM2(self.address, 0)
            else:
                roboclaw.SpeedM1M2(self.address, vl_ticks, vr_ticks)
        except OSError as e:
            rospy.logwarn("SpeedM1M2 OSError: %d", e.errno)
            rospy.logdebug(e)
	finally:
	    mutex.release()


    # TODO: Need to make this work when more than one error is raised
    def check_vitals(self, stat):
        try:
	    mutex.acquire()
            status = roboclaw.ReadError(self.address)[1]
        except OSError as e:
            rospy.logwarn("Diagnostics OSError: %d", e.errno)
            rospy.logdebug(e)
	    mutex.release()
            return

	mutex.release()
        state, message = self.ERRORS[status]
        stat.summary(state, message)
        try:
	    mutex.acquire()
            stat.add("Main Batt V:", float(roboclaw.ReadMainBatteryVoltage(self.address)[1] / 10))
            stat.add("Logic Batt V:", float(roboclaw.ReadLogicBatteryVoltage(self.address)[1] / 10))
            stat.add("Temp1 C:", float(roboclaw.ReadTemp(self.address)[1] / 10))
            stat.add("Temp2 C:", float(roboclaw.ReadTemp2(self.address)[1] / 10))
        except OSError as e:
            rospy.logwarn("Diagnostics OSError: %d", e.errno)
            rospy.logdebug(e)
	finally:
	    mutex.release()
        return stat


    # TODO: need clean shutdown so motors stop even if new msgs are arriving
    def shutdown(self):
        rospy.loginfo("Shutting down")
        try:
	    mutex.acquire()
            roboclaw.ForwardM1(self.address, 0)
            roboclaw.ForwardM2(self.address, 0)
        except OSError:
            rospy.logerr("Shutdown did not work trying again")
            try:
                roboclaw.ForwardM1(self.address, 0)
                roboclaw.ForwardM2(self.address, 0)
            except OSError as e:
                rospy.logerr("Could not shutdown motors!!!!")
                rospy.logdebug(e)
	finally:
	    mutex.release()


if __name__ == "__main__":
    try:
        node = Node()
        node.run()
    except rospy.ROSInterruptException:
        pass
    rospy.loginfo("Exiting")
