introlab/securbot/(commit log)

2019-02-23 Added URG Lidar to TurtleBot mapping demo
2019-02-26 SEC-268 Added easier to print landscape format
2019-03-01 sec-299 First Commit for PowerTree design
2019-03-02 SEC-299
    SEC-299 Started librairy and project for power tree
    [Altium_Librairie_PCB_Default.PcbLib, Altium_Librairie_Schematic_Default.SchLib, Altium_PCB_Default.PcbDoc, Altium_PCB_Project_Default.PrjPCB, Altium_Schematic_Default.SchDoc, Connectors.SchDoc, PowerTree.PrjPcb, SecureBot.PcbLib]
2019-03-02 SEC-299 Started librairy and project for power tree
    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
    [Altium_Librairie_PCB_Default.PcbLib, Altium_Librairie_Schematic_Default.SchLib, Altium_PCB_Default.PcbDoc, Altium_PCB_Project_Default.PrjPCB, Altium_Schematic_Default.SchDoc, Connectors.SchDoc, PowerTree.PrjPcb, SecureBot.PcbLib]
2019-03-02 SEC-299 Added Molex and Terminal block symbol
    [SecureBot.PcbLib, SecureBot.SchLib]
2019-03-04 DCDC 12V
    almost over missing R1 and R2 value
    [DC_DC_12V.SchDoc, PowerTree.PrjPcb, SecureBot.PcbLib]
2019-03-04 SEC-299 Added Buck-boost design file and diode footprint
    [BuckBoost_19V_DesignFile.xlsx, SecureBot.PcbLib]
2019-03-05 SEC-299 DC-DC 5V and connector schematics
    [Connectors.SchDoc, DC_DC_12V.SchDoc, DC_DC_5V.SchDoc, PowerTree.PrjPcb, SecureBot.PcbLib, SecureBot.SchLib]
2019-03-05 SEC-299 Buck-boost design completed and schematic to be finished
    [Buck Boost 19V.SchDoc, BuckBoost_19V_DesignFile.xlsx, DC_DC_12V.SchDoc, DC_DC_5V.SchDoc, PowerTree.PrjPcb, SecureBot.PcbLib, SecureBot.SchLib]
2019-03-06 SEC-299 DCDC 12V modif
    [DC_DC_12V.SchDoc, DC_DC_5V.SchDoc]
2019-03-06 SEC-299 Git ignore plus footprint modif
    [SecureBot.PcbLib]
2019-03-06 SEC-299 DC-DC 15V
    [DC_DC_12V.SchDoc, DC_DC_15V.SchDoc, DC_DC_5V.SchDoc, PowerTree.PrjPcb]
2019-03-06 SEC-299 Buckboost final touch and Variable DCDC done
    [Buck Boost 19V.SchDoc, DC_DC_VAR.SchDoc, PowerTree.PrjPcb, SecureBot.PcbLib, SecureBot.SchLib]
2019-03-06 SEC-299 Buck-boost tuning
    [Buck Boost 19V.SchDoc, BuckBoost_19V_DesignFile.xlsx]
2019-03-07 SEC-299 DC Converter Update + barrel plug footprint
    [Connectors.SchDoc, DC_DC_12V.SchDoc, DC_DC_15V.SchDoc, DC_DC_5V.SchDoc, DC_DC_VAR.SchDoc, SecureBot.PcbLib]
2019-03-07 SEC-299 Resistor changement + molex footprint tuning
    [Buck Boost 19V.SchDoc, DC_DC_VAR.SchDoc, SecureBot.PcbLib]
2019-03-07 SEC-299 reverse current protection added
    [DC_DC_12V.SchDoc, DC_DC_15V.SchDoc, DC_DC_5V.SchDoc]
2019-03-07 SEC-299 Part numbers
    [Buck Boost 19V.SchDoc]
2019-03-07 SEC-299 Part Nbrs
    [Connectors.SchDoc, DC_DC_12V.SchDoc, DC_DC_15V.SchDoc, DC_DC_5V.SchDoc, DC_DC_VAR.SchDoc, PowerTree.PrjPcb]
2019-03-07 SEC-299 Part numbers and connectors
    [Buck Boost 19V.SchDoc, Connectors.SchDoc, SecureBot.PcbLib, SecureBot.SchLib, Title.SchDoc]
2019-03-07 SEC-299 BOM, final touches for the schematic and PCB generation
    [Buck Boost 19V.SchDoc, Connectors.SchDoc, DC_DC_12V.SchDoc, DC_DC_15V.SchDoc, DC_DC_15V_AND_VAR.SchDoc, DC_DC_5V.SchDoc, DC_DC_5V_1.SchDoc, DC_DC_5V_2.SchDoc]
2019-03-07 SEC-335 Added mutex to Roboclaw node so it would stop crashing
    [roboclaw_node.py]
2019-03-08 SEC-301 Board creation and preplacement
    [Connectors.SchDoc, PowerTree.PcbDoc]
2019-03-08 SEC-301 Layout and routing
    [DC_DC_12V.SchDoc, PowerTree.PcbDoc, SecureBot.PcbLib]
2019-03-11 SEC-299 Finishing layout
    [Connectors.SchDoc, DC_DC_12V.SchDoc, DC_DC_15V_AND_VAR.SchDoc, DC_DC_5V_1.SchDoc, DC_DC_5V_2.SchDoc, PowerTree.PcbDoc, SecureBot.PcbLib]
2019-03-11 SEC-306 Pinout document
    [PinCount.xlsx]
2019-03-12 SEC-301 Output files for fab
    [BOM_PowerTree.xls, Connectors.SchDoc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]
2019-03-12 SEC-301 Fab files
    [PowerTree.PrjPcb]
2019-03-12 SEC-301 final fab touches
    [PowerTree.GBL, PowerTree.GBO, PowerTree.GBP, PowerTree.GBS, PowerTree.GKO, PowerTree.GM1, PowerTree.GTL, PowerTree.GTO]
2019-03-12 SEC-335 ran ros on pioneer. sensors and base working except for base odometry reference.
2019-03-13 SEC-299 Updated file parameters and exported PDF
    [Battery Front End.SchDoc, BatteryBoard.PrjPcb, Buck Boost 19V.SchDoc, Connectors.SchDoc, DC_DC_12V.SchDoc, DC_DC_15V_AND_VAR.SchDoc, DC_DC_5V_1.SchDoc, DC_DC_5V_2.SchDoc]
2019-03-13 SEC-306 Starting Project
    [Battery Front End.SchDoc, BatteryBoard.PrjPcb]
2019-03-13 SEC-306 Preminilairy PCB and placement
    [Battery Front End.SchDoc, BatteryBoard.PcbDoc, BatteryBoard.PrjPcb, SecureBot.PcbLib, SecureBot.SchLib]
2019-03-15 Added sensor launchfile for rplidar
2019-03-18 sec-335 Fixed roboclaw odom reversed Y
    [roboclaw_node.py]
2019-03-18 SEC-335 Mapping and odometry working on claw, gtsam warning present.
2019-03-18 Test file for odometry
2019-03-18 SEC-349 Made test file and generated pdf for PowerTree board
2019-03-19 sec-335 fixed roboclaw node left right speed output
    [roboclaw_node.py]
2019-03-22 SEC360 Charger Schematic start
    [Battery Front End.SchDoc, BatteryBoard.PrjPcb, BatteryCharger.SchDoc, DC_DC_3.3V.SchDoc, SecureBot.PcbLib, SecureBot.SchLib]
2019-03-22 SEC_334 Improved move_base panner settings and added velocity smoother
2019-03-23 SEC-360 Charger placement done
    Still some configuration left
    [BatteryBoard.PrjPcb, BatteryCharger.SchDoc, SecureBot.PcbLib, SecureBot.SchLib]
2019-03-25 SEC-360 correction charger
    [BatteryCharger.SchDoc]
2019-03-25 SEC-360 BMS
    [Battery Front End.SchDoc, BatteryBoard.PrjPcb, SecureBot.SchLib]
2019-03-27 SEC-360 Part numbers for the charger
    [BatteryCharger.SchDoc, DC_DC_3.3V.SchDoc, SecureBot.PcbLib, SecureBot.SchLib]
2019-03-28 SEC-364-365 - Rework has been done, trying to test with a dummy page with multiple stream, currently not working
2019-03-28 SEC-360 ESP32 model started
    [Battery Front End.SchDoc, BatteryCharger.SchDoc, SecureBot.PcbLib, SecureBot.SchLib]
2019-03-29 SEC-384 Fixed bug in RoboClaw node odom twist and parameters tuning
    [roboclaw_node.py, smoother.yaml]
2019-03-31 SEC-360 BMS and MC
    [Battery Front End.SchDoc, BatteryBoard.PrjPcb, MC.SchDoc, SecureBot.PcbLib, SecureBot.SchLib]
2019-04-01 SEC-360 New 4V regulator, MCU and ADC
    [ADC.SchDoc, Battery Front End.SchDoc, BatteryBoard.PrjPcb, BatteryCharger.SchDoc, DC_DC_3.3V.SchDoc, DC_DC_4V.SchDoc, MC.SchDoc, SecureBot.PcbLib]
2019-04-02 SEC-360 Isolation and new USB configuration
    [ADC.SchDoc, Battery Front End.SchDoc, DC_DC_4V.SchDoc, MC.SchDoc, SecureBot.PcbLib, SecureBot.SchLib]
2019-04-03 SEC-387 envoi de waypoint dans le planner
2019-04-04 SEC-360 BMS, Relay and protection
    [Battery Front End.SchDoc, SecureBot.PcbLib, SecureBot.SchLib]
2019-04-04 SEC-360 last MCU changes and usb
    [ADC.SchDoc, Battery Front End.SchDoc, DC_DC_4V.SchDoc, MC.SchDoc, Title.SchDoc]
2019-04-05 SEC-360 Annotation and connectors
    [ADC.SchDoc, Battery Front End.SchDoc, BatteryBoard.PrjPcb, BatteryCharger.SchDoc, DC_DC_4V.SchDoc, MC.SchDoc, PowerTree.PrjPcb, SecureBot.SchLib]
2019-04-05 SEC-360 BMS last touch
    [ADC.SchDoc, Battery Front End.SchDoc, BatteryBoard.PrjPcb, BatteryCharger.SchDoc, DC_DC_4V.SchDoc, DC_DC_5V.SchDoc, MC.SchDoc, SecureBot.PcbLib]
2019-04-05 SEC-383 Preplacing started
    [ADC.SchDoc, Battery Front End.SchDoc, BatteryBoard.PcbDoc, BatteryBoard.PrjPcb, BatteryCharger.SchDoc, DC_DC_5V.SchDoc, MC.SchDoc, SecureBot.SchLib]
2019-04-05 SEC-383 Charger board preplacing
    [BatteryBoard.PcbDoc]
2019-04-06 SEC-401 fixed loopback devices not showing under electron app
2019-04-09 SEC-351 basic ros test case
2019-04-09 SEC-383 Routing started
    Missing adc, power planes and i2c
    [ADC.SchDoc, BatteryBoard.PcbDoc, MC.SchDoc, SecureBot.PcbLib]
2019-04-10 SEC-351 Added test case to MakeLists
2019-04-10 commenting patrol interrupt callback for now, for testing purposes
2019-04-10 SEC-383 Digital signal routing
    [ADC.SchDoc, BatteryBoard.PcbDoc, BatteryBoard.PrjPcb, BatteryBoardTEST.PcbDoc, BatteryCharger.SchDoc, MC.SchDoc]
2019-04-10 SEC-260 - teleop working, still need a launch file and maybe a enable switch on ui
2019-04-11 Interrupt receiver callback function fully implemented
2019-04-12 SEC-260 - camera setup
2019-04-12 SEC-260 - edited some camera settings
2019-04-12 SEC-260 - Created a launch file that creates both virtual devices
2019-04-12 SEC-260 - edited teleop launch file to start both camera
2019-04-12 SEC-404 switch save button and textbox in Patrol planner
2019-04-12 SEC-260 - corrected the device acquisition on electron
2019-04-12 SEC-260 - set the request-stream data channel event in case firefox have getting the stream | SEC-452 - set the accept checker callback
2019-04-14 SEC-309 test results 1
    [SEC-349_RESULTS_1.xlsx]
2019-04-14 SEC-435 - Implemented JSDoc in frontend, documented Teleop.vue as an example, currently using jsdoc-vuejs as plugin for vue file but might modify it or use jsdoc-vue since it is missing options
2019-04-14 SEC-433-qualityOfLife
    BootStraped the buttons and text input for the teleop tab
2019-04-15 FIxes GND plane
2019-04-17 SEC-419 schematic fix and layout changes
    [BatteryCharger.SchDoc]
2019-04-18 sec-309 Minor corrections for 5v Reg
    [ADC.SchDoc, DC_DC_5V.SchDoc]
2019-04-18 SEC-455-YawInWP
    Added the arrow to control the yaw but waypoint and arrow only visible on Mouse up (when its set)
2019-04-18 SEC-455-YawInWP
    The waypoints now appear on click, the value in the wp table for the yaw is now the yaw and not the date still missing the dynamic display of the arrow
2019-04-18 SEC-455-YawInWP
    The arrow is now visible dynamically
2019-04-18 SEC-419 Schematic correction and layout correction
    [BatteryBoard.PrjPcb, BatteryCharger.SchDoc, MC.SchDoc]
2019-04-19 SEC-433 - added enable switch fir joystick
2019-04-20 SEC-465 - the number are now bigger and a bit off on the right of a waypoint, fixed joystick state not updating on page change and fixed sizing/position for joystick and its switch
2019-04-20 SEC-419 PowerTree Update
    [Buck Boost 19V.SchDoc, Connectors.SchDoc, DC_DC_12V.SchDoc, DC_DC_15V_AND_VAR.SchDoc, DC_DC_5V_1.SchDoc, DC_DC_5V_2.SchDoc, PowerTree.PcbDoc]
2019-04-20 SEC-419 Added fan in layout
    [BatteryBoard.PrjPcb, MC.SchDoc]
2019-04-22 SEC-419 PowerTree Update and generate outputs
    [BOM_PowerTree.xls, DC_DC_15V.SchDoc, DC_DC_15V_AND_VAR.SchDoc, DC_DC_5V.SchDoc, DC_DC_VAR.SchDoc, PowerTree.PrjPcb]
2019-04-26 SEC-457 Final modifications for power tree board for release
    [BOM_PowerTree.xls, Buck Boost 19V.SchDoc, BuckBoost_19V_DesignFile.xlsx, DC_DC_12V.SchDoc, DC_DC_15V_AND_VAR.SchDoc, DC_DC_5V_1.SchDoc, DC_DC_5V_2.SchDoc, PowerTree.PcbDoc]
2019-05-11 SEC-426 renamed pcb design directory to "hardware"
    [ADC.SchDoc, Altium_Librairie_PCB_Default.PcbLib, Altium_Librairie_Schematic_Default.SchLib, Altium_PCB_Default.PcbDoc, Altium_PCB_Project_Default.PrjPCB, Altium_Schematic_Default.SchDoc, BOM_PowerTree.xls, Battery Front End.SchDoc]
2019-08-28 SEC - 474 Creation of Charge Station project
    [PowerTree.GBL, PowerTree.GBO, PowerTree.GBP, PowerTree.GBS, PowerTree.GKO, PowerTree.GM1, PowerTree.GTL, PowerTree.GTO]
2019-08-28 Misunderstanding of summer modification
    [Charge Station.PrjPcb, Charge Station.SchDoc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]
2019-08-28 SEC-474 Added relay and interface, missing 5V LDO
    [Charge Station.SchDoc, SecureBot.PcbLib, SecureBot.SchLib]
2019-08-29 SEC-474 Finished layout and design
    [Charge Station.PcbDoc, Charge Station.PrjPcb, Charge Station.SchDoc, SecureBot.PcbLib, SecureBot.SchLib, Title.SchDoc]
2019-08-29 Library, Planes correction
    [Battery Front End.SchDoc, BatteryBoard.PrjPcb, BatteryBoardTEST.PcbDoc, BatteryCharger.SchDoc, SecureBot.SchLib]
2019-08-29 USB isolation correction
    [BatteryCharger.SchDoc, MC.SchDoc]
2019-09-02 Added fuse and relay for ground
    [Charge Station.PcbDoc, Charge Station.PrjPcb, Charge Station.SchDoc]
2019-09-03 Contact for charge station
2019-09-03 Generated Bom and added Silkscreen version
    [BOM_Charge_Station.xls, Charge Station.PcbDoc, Charge Station.PrjPcb, Charge Station.SchDoc]
2019-09-03 SEC-483 Replaced file for contact of charge station
2019-09-03 Width of traces corrected, polygon adjust
    [MC.SchDoc]
2019-09-04 SEC-474 finished board and output gerber file
    [Charge Station.PcbDoc, Charge Station.PrjPcb]
2019-09-04 Width correction of 5v and Leaving mounting holes floating
    [Title.SchDoc]
2019-09-06 Started charge station
2019-09-06 SEC-477 Final Correction
    [BatteryBoard.PrjPcb, BatteryCharger.SchDoc, SecureBot.PcbLib, SecureBot.SchLib]
2019-09-06 SEC-477 battery board gerber
2019-09-06 SEC-477 Via Correction
    [SecureBot.PcbLib]
2019-09-06 SEC-477 Gerber update
2019-09-08 SEC-482 Finished vuex props/data implementation, need testing before continuing
2019-09-09 SEC-490 Add scan of top plate of Pioneer
2019-09-10 SEC-490 Add solidwork file of Pioneer, Assembly of comparison between scanned top plate and previously cadded top plate
    [CasterWheelBody.SLDPRT, CasterWheelClamp.SLDPRT, Part1.SLDPRT, Pioneer.dxf, Pioneer3DXAssembly.SLDASM, PioneerBody.SLDPRT, Pioneer_Compare_Plates-TOP PLATE-1.SLDPRT, Pioneer_Compare_Plates.SLDASM]
2019-09-10 Charge station
2019-09-12 SEC-477 Output file ready
    [Charge Station.PrjPcb]
2019-09-12 SEC-483 Charge station design
2019-09-17 SEC-494 Made the testing2 page work with multi-stream the same way the electron works, linted the electron files, removed the package-lock of the electron package, switch electron to dependencies fro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
2019-09-17 Removed Roboclaw node to replace with another one
    [roboclaw_node.py]
2019-09-17 3D model of contact
    [90592A095_STEEL HEX NUT.SLDPRT, 90965A160_TYPE 316 STAINLESS STEEL FLAT WASHER.SLDPRT, 92010A346_METRIC 18-8 SS FLAT HEAD PHIL MACHINE SCREW.SLDPRT, 9434K790_MUSIC-WIRE STEEL COMPRESSION SPRINGS.SLDPRT, Aimant.SLDPRT, Assemblage1.SLDASM, Morceau_plexi.SLDPRT, Slider.SLDPRT]
2019-09-18 SEC-490 Adding cutouts and drawings of links for pioneer body
    [BodySides_135_halfbod1.sldprt, CoinBas_135deg.SLDPRT, CoinButtom_Bas.SLDPRT, CoinHaut_135deg.SLDPRT, CoinTopBas_135deg.SLDPRT, CoinTop_Bas.SLDPRT, CoinTop_haut.SLDPRT, Coinlift.SLDPRT]
2019-09-18 SEC-483 contact box
    [90592A095_STEEL HEX NUT.SLDPRT, 90965A160_TYPE 316 STAINLESS STEEL FLAT WASHER.SLDPRT, 92010A346_METRIC 18-8 SS FLAT HEAD PHIL MACHINE SCREW.SLDPRT, 9434K790_MUSIC-WIRE STEEL COMPRESSION SPRINGS.SLDPRT, Aimant.SLDPRT, Assemblage1.SLDASM, Morceau_plexi.SLDPRT, Slider.SLDPRT]
2019-09-18 Modified roboclaw node to fiz lag issues
    [roboclaw_node.py]
2019-09-19 SEC-483 contact bloc
    [Assemblage1.SLDASM, Morceau_plexi_simple.SLDPRT, Slider_simple.SLDPRT, base_grand.SLDPRT]
2019-09-19 SEC-531 renamed files and finished first draft of contact bloc
    [Assemblage1.SLDASM, Base_of_box.SLDPRT, Double_mid_piece.SLDPRT, Magnet.SLDPRT, Simple_mid_piece.SLDPRT, Slider_double.SLDPRT, base_grand.SLDPRT, complete_box.SLDASM]
2019-09-19 SEC-531 removed hanging part
    [Base_of_box.SLDPRT, complete_box.SLDASM, half_contact_box.SLDASM]
2019-09-19 SEC-530 Assembly and fix links for pioneer base
    [Assem1.SLDASM, Assem2.SLDASM, Assem3.SLDASM, Assem4.SLDASM, CoinButtom_Bas.SLDPRT, CoinHaut_135deg.SLDPRT, CoinTop_Bas.SLDPRT, CoinTop_haut.SLDPRT]
2019-09-20 SEC-533 Fuse holder error
    [BatteryBoard.PrjPcb, Charge Station.PcbDoc, SecureBot.PcbLib]
2019-09-23 Move camera to front of TurtleBot
2019-09-23 Adjust footprint radius
2019-09-25 Store is now splitted into multiple files and into namespaced modules (currently there is only one module, the easyrtc client)
2019-09-30 SEC-532 Link created and started charge station
    [Bottom.SLDPRT, ChargeStation.SLDASM, Link_corner.SLDPRT]
2019-10-01 Add PDF schematic and test firmware
2019-10-02 Add i2c driver and readme
2019-10-02 Add main and i2c source doc
2019-10-03 Added waypoint overlay, switch patrol map to it and added it as a demo to the teleop page
2019-10-04 SEC-548 V2 of charge block
    [Base_of_box_V2.SLDPRT, Base_of_box_V2.STL, Slider_double_V2.SLDPRT, Slider_double_V2.STL, Slider_double_V2_custom.STL, half_contact_box_V2.SLDASM]
2019-10-04 SEC-547 Started charge station design
    [Bottom.SLDPRT, ChargeStation.SLDASM, Front.SLDPRT, Link_corner.SLDPRT]
2019-10-04 SEC-548 Charge station design
    [Bottom.SLDPRT, Charge Station Board.SLDASM, ChargeStation.SLDASM, Link_corner.SLDPRT, Power_supply.SLDPRT]
2019-10-07 SEC-490 V2 links pioneer
    [Assem2.SLDASM, Assem_linksV2.SLDASM, CoinHaut_135deg.SLDPRT, Side_angle.SLDPRT, Side_court_v.SLDPRT, Sides_long_h.SLDPRT, Top_angle.SLDPRT, Top_court.SLDPRT]
2019-10-07 SEC-547 Charge Station design
    [90592A095_STEEL HEX NUT.SLDPRT, 90965A160_TYPE 316 STAINLESS STEEL FLAT WASHER.SLDPRT, 92010A793_PASSIVATED 18-8 SS PHILLIPS FLAT HEAD SCREW.SLDPRT, 98952A426_ALUM MALE-FEM THRDED HEX STANDOFF.SLDPRT, Back_Pannel_Restrictor_for_supply_cable.SLDPRT, Bottom_Back_Panel.SLDPRT, ChargeStation.SLDASM, Side_Panel_Bottom.SLDPRT]
2019-10-07 Add ADS1015 and analogInput driver
2019-10-08 Add error management to analog operations
    [ADS1015.cpp, analogInput.cpp, defines.hpp]
2019-10-08 SEC-544 change name of parts and assembly for Pioneer
    [Assem1.SLDASM, Assem2.SLDASM, Assem3.SLDASM, Assem_body.SLDASM, Assem_linksV2.SLDASM, Base_of_box_onpioneer.SLDPRT, CoinButtom_Bas.SLDPRT, CoinHaut_135deg.SLDPRT]
2019-10-08 SEC-509 Fixed prop name
2019-10-09 Add smbus read to i2c driver
2019-10-09 Add smbus write operation to i2c driver
2019-10-09 Add BQ24725A driver
2019-10-09 Fix typp in doxygen header
    [BQ24725A.cpp]
2019-10-09 fix input current register field type
    [BQ24725A.cpp]
2019-10-09 SEC-543 Renaming of file begin of design adaptation for turtlebot, adapt links after printing
    [Assem_Base_bodies.SLDASM, Assem_body.SLDASM, Assem_body_turtle.SLDASM, Assem_turtleBase.SLDASM, Base_of_box_onpioneer.SLDPRT, Links_ButtomOfCap.SLDPRT, Links_ButtomOfCap.STL, Links_TopOfBody.SLDPRT]
2019-10-10 SEC-547 Charge station design and links
    [98952A426_ALUM MALE-FEM THRDED HEX STANDOFF.SLDPRT, Bottom.SLDPRT, ChargeStation.SLDASM, Double_mid_piece.SLDPRT, Double_mid_piece.STL, Link_corner.SLDPRT, Link_corner.STL, Link_upper_corner.SLDPRT]
2019-10-10 SEC-524 add RPlidar to design and correct realsens plate
    [IntelSup - Copy.SLDPRT, IntelSup.SLDPRT, Sub_cornerOfCap.SLDASM, TopPlate_turtle.SLDPRT, Top_court_avant.SLDPRT, Top_court_avant_turtle.SLDPRT, Top_court_turtle.SLDPRT, Top_plate.SLDPRT]
2019-10-11 SEC-533 Cleaning folders and Charge station design
    [90592A095_STEEL HEX NUT.SLDPRT, 90965A160_TYPE 316 STAINLESS STEEL FLAT WASHER.SLDPRT, 92010A346_METRIC 18-8 SS FLAT HEAD PHIL MACHINE SCREW.SLDPRT, 92010A793_PASSIVATED 18-8 SS PHILLIPS FLAT HEAD SCREW.SLDPRT, 93505A114_ALUM MALE-FEM THRDED HEX STANDOFF.SLDPRT, 9434K790_MUSIC-WIRE STEEL COMPRESSION SPRINGS.SLDPRT, Back_Pannel.SLDPRT, Back_Pannel_Restrictor_for_supply_cable.SLDPRT]
2019-10-12 SEC-540 design links from pioneer to body, BodyAttach
    [Assem_Base_bodies.SLDASM, Assem_body.SLDASM, Assem_turtleBase.SLDASM, BodyAttach.SLDPRT, BodyAttachSecond.SLDPRT, Links_ButtomOfCap.SLDPRT, Pioneer3DXAssembly.SLDASM, PioneerBody.SLDPRT]
2019-10-13 SEC- 548 demonstration animation for audit
    [Assem_body.SLDASM, Assem_body_turtle.SLDASM, Assem_turtleBase.SLDASM, BodyAttach.SLDPRT, BodyAttach_back_turtle.SLDPRT, BodyAttach_side_turtle.SLDPRT, Contact.SLDASM, Part1_contact.SLDPRT]
2019-10-14 Add hardware abstraction for power switches
2019-10-14 Add battery charger hardware abstraction
2019-10-15 SEC-547 First iteration of charging station
    [90592A095_STEEL HEX NUT.SLDPRT, 90604A148_PAN HEAD COMBINATION DRIVE MACHINE SCREW.SLDPRT, 91780A133_ALUM FEM THRDED HEX STANDOFF.SLDPRT, 93505A114_ALUM MALE-FEM THRDED HEX STANDOFF.SLDPRT, 9434K730_MUSIC-WIRE STEEL COMPRESSION SPRINGS.SLDPRT, 9434K790_MUSIC-WIRE STEEL COMPRESSION SPRINGS.SLDPRT, Back_Pannel.SLDPRT, Base_of_box.SLDPRT]
2019-10-15 SEC-547 Adjustment of corner link for printing
    [Link_corner.SLDPRT, Link_corner.STL]
2019-10-15 SEC-570 Output files for lasercut
    [Bottom_Pannel.DXF, Front_Pannel.DXF, Side_Panel.DXF, Upper_Pannel.DXF]
2019-10-16 SEC-547 Modification for fortification of contact box base
    [Base_of_box.SLDPRT, Base_of_box.STL, Contact_box.SLDASM]
2019-10-16 SEC-544 Modification of turtlebot BodyAttach SEC-571 add cutouts for panels of both robots
    [Assem_body.SLDASM, Assem_body_turtle.SLDASM, Assem_turtleBase.SLDASM, BodyAttach_back_turtle.SLDPRT, BodyAttach_side_turtle.SLDPRT, CasterWheelBody.SLDPRT, CasterWheelClamp.SLDPRT, ConnecteurAAnneau.SLDPRT]
2019-10-17 Add error management to main and analog input
    [analogInput.cpp, main.cpp]
2019-10-17 Fix frontend i2c bus number and speed
    [defines.hpp]
2019-10-18 SEC-607 intergrate ODAS materials on pioneer and turtlebot armors
    [91290A110_BLACK-OXIDE CLASS 12.9 SOCKET HEAD CAP SCREW.SLDPRT, 95610A330_NYLON FLAT WASHER.SLDPRT, 98952A120_ALUM MALE-FEM THRDED HEX STANDOFF.SLDPRT, Board.SLDPRT, Board_withSpacers.SLDASM, Contact_barreAlu.SLDPRT, Contact_barreFer.SLDPRT, Links_ButtomOfBody.SLDPRT]
2019-10-19 Test and PCB updates
    [ADC.SchDoc, BOM_Charge_Station.xls, Battery Front End.SchDoc, BatteryCharger.SchDoc, DC_DC_5V.SchDoc, MC.SchDoc, SecureBot.SchLib, Title.SchDoc]
2019-10-21 Add default config debug print to analog input and ADCs
2019-10-21 Add chip id readout to charger and BQ24725A
2019-10-21 SEC-570 final files and added logo
    [Back_Pannel.DXF, Back_Pannel_Restrictor_for_supply_cable.STL, Link_upper_corner_L.STL, Link_upper_corner_R.STL]
2019-10-21 SEC-570 Redid files because of corruption and did all plane files
    [Back_Pannel.DXF, Bottom_Pannel.DXF, Front_Pannel.DXF, Side_Panel.DXF, Upper_Pannel.DXF]
2019-10-21 Scale cell voltage in frontend by vref
2019-10-22 Fix lock up in read cell and reversed state in battery verification
    [analogInput.cpp, charger.cpp, control.cpp, frontend.cpp, main.cpp, monitor.cpp]
2019-10-22 Add battery ok log message
2019-10-22 Add default switches to 0 and control power debounce
2019-10-23 Fix ADC reading always 0
    [ADS1015.cpp, frontend.cpp]
2019-10-23 Removed accumulator when measuring cell voltage
2019-10-23 fix temperature reading and add overtemperature protection
    [defines.hpp, frontend.cpp, monitor.cpp]
2019-10-23 Add charge state print, adjust bms current reading and fix lock when power is applied to bms
    [charger.cpp, control.cpp, frontend.cpp]
2019-10-23 Reconfigure bms at start of monitoring loop
2019-10-24 Fix register write to BQ24725A and reverse relay switch polarity
    [BQ24725A.cpp, control.cpp, switches.cpp]
2019-10-24 Add charger current readouts
2019-10-24 SEC-570 Modification of links for assembly
    [Link_upper_corner_L.SLDPRT, Link_upper_corner_L.STL, Link_upper_corner_R.SLDPRT, Link_upper_corner_R.STL]
2019-10-25 SEC-587 Fixed map-image first cycle read error, added more param into the map-image launcher (virtualDevices.launch) and added a xlsx file to validate the parameters used in the same launch file
    [OccupancyGridValidator.xlsx]
2019-10-25 SEC-587 Made the height equal the width in the launch file, added colors to the xlsx
    [OccupancyGridValidator.xlsx]
2019-10-27 SEC-593 Cleanup of mecanical folder for robot bases and renaming of solidworks files and renew references
    [91290A110_BLACK-OXIDE CLASS 12.9 SOCKET HEAD CAP SCREW.SLDPRT, 95610A330_NYLON FLAT WASHER.SLDPRT, 98952A120_ALUM MALE-FEM THRDED HEX STANDOFF.SLDPRT, Assem_Body_Pioneer.SLDASM, Assem_Body_turtle.SLDASM, Assem_body.SLDASM, Assem_body_turtle.SLDASM, Assem_turtleBase.SLDASM]
2019-10-28 SEC-593 File clean up
    [BodyAttach.SLDPRT, IntelSup.STL, Links_ButtomOfBody.STL, Links_ButtomOfCap.STL, Links_TopOfBody.STL, Links_TopOfCap.STL, RealSense_holder.STL]
2019-10-28 Update topics to robot topics and uncomment virtual camera
2019-10-28 SEC-591 Modified to coordinates of the sensors to fit with the new armor
2019-10-28 SEC-529 Added components to the log view, added the table component to list the events, added multiple inputs for filtering, added a database module to the store that makes the queries and manage tho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
2019-10-30 Add doc, charger register print and settings for 4 cell
2019-11-01 SEC-602 April tag holder
    [AprilTagHolder.SLDPRT, AprilTagHolder.STL, Upper_Pannel.SLDPRT]
2019-11-04 Add Dock behaviour. Not working yet
    [planner_node.cpp]
2019-11-05 SEC-602 hole for april tag pannel
    [Upper_Pannel.DXF]
2019-11-07 SEC-529 Removed underlined and : from filter title
2019-11-07 SEC-614|SEC-615 Added predefined filters, added map to event page, modified the request process for events
2019-11-08 SEC-615 Fixed typos, fixed filtering for event request, fixed bad request format of filters, changed default filter to event of last 7 days, added rest request into rest file
2019-11-09 SEC-613 Modified the teleop view to integrate overlay/convert to it, made the small video appear on top of the bigger one with some transparency, added a way to switch the stream displays, made the j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
2019-11-09 Changed events to use x; y; yaw; coordinate system
2019-11-09 Add reverse behavior and strategy to get off charge station after a loiter
2019-11-11 Tune HBBA Docking Fix bug where configured dock approach yaw would not be published Hardcode reverse time in hbba config Tune dock approach point Adjust map image generator topics to hbba topics
2019-11-12 SEC-613 Added the map size to waypoint overlay, made the grid a activable feature with a prop, made the show prop affect the display of waypoint, improved teleop turns
2019-11-12 SEC-615 Fixed some bug with the map and added the zoom button overlay
2019-11-13 SEC-623 Updated vue-bootstrap package, currently changing the table component from the custom one to the vue-bootstrap one, added patrol config with control and all the necessary queries (except thos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
2019-11-17 Changed the ros frames of the pioneer for the new position of camera and lidar
2019-11-18 SEC-625 Added docking button to teleop view with store support
2019-11-19 SEC-628 Fixed eventDetection errors, currently waiting for talks to continue
2019-11-21 SEC-640 Event Detection is working and images are posted to the database, added launch and config files for darknet in event detection pkg, made the http client check the camera feed directly, add ti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
2019-11-22 Add apriltag for mapping and localization Fix bug where dock motivation would switch to docking before reaching approach point
2019-11-23 First proto of apriltag based collision detection
    [planner_node.cpp]
2019-11-23 Revert "First proto of apriltag based collision detection"
    This reverts commit 1878385eafdc64ed764ba9d539d9c3abcbbda41e.
    [planner_node.cpp]
2019-11-23 SEC-625 Fixed the current robot state
2019-11-23 SEC-625 Fixed patrol format, added behaviour for the send schedule button, changed loops to repetitions in patrol scripts
2019-11-26 SEC-625 Bug fixes, more transition, more user friendly and added deconnect all button
2019-11-26 Set BQ76 to no bypassed cell before reading cell voltage.
2019-12-03 Added button to the patrol planner view
2019-12-13 Library Updates and corrections
    [ADC.SchDoc, Battery Front End.SchDoc, BatteryBoard.PrjPcb, BatteryCharger.SchDoc, Buck Boost 19V.SchDoc, Connectors.SchDoc, DC_DC_12V.SchDoc, DC_DC_15V_AND_VAR.SchDoc]
